thedarknet/darknet8-badge/Prototype1/hardware/docs/TJC-028-9341SPI裸屏规格书.pdf

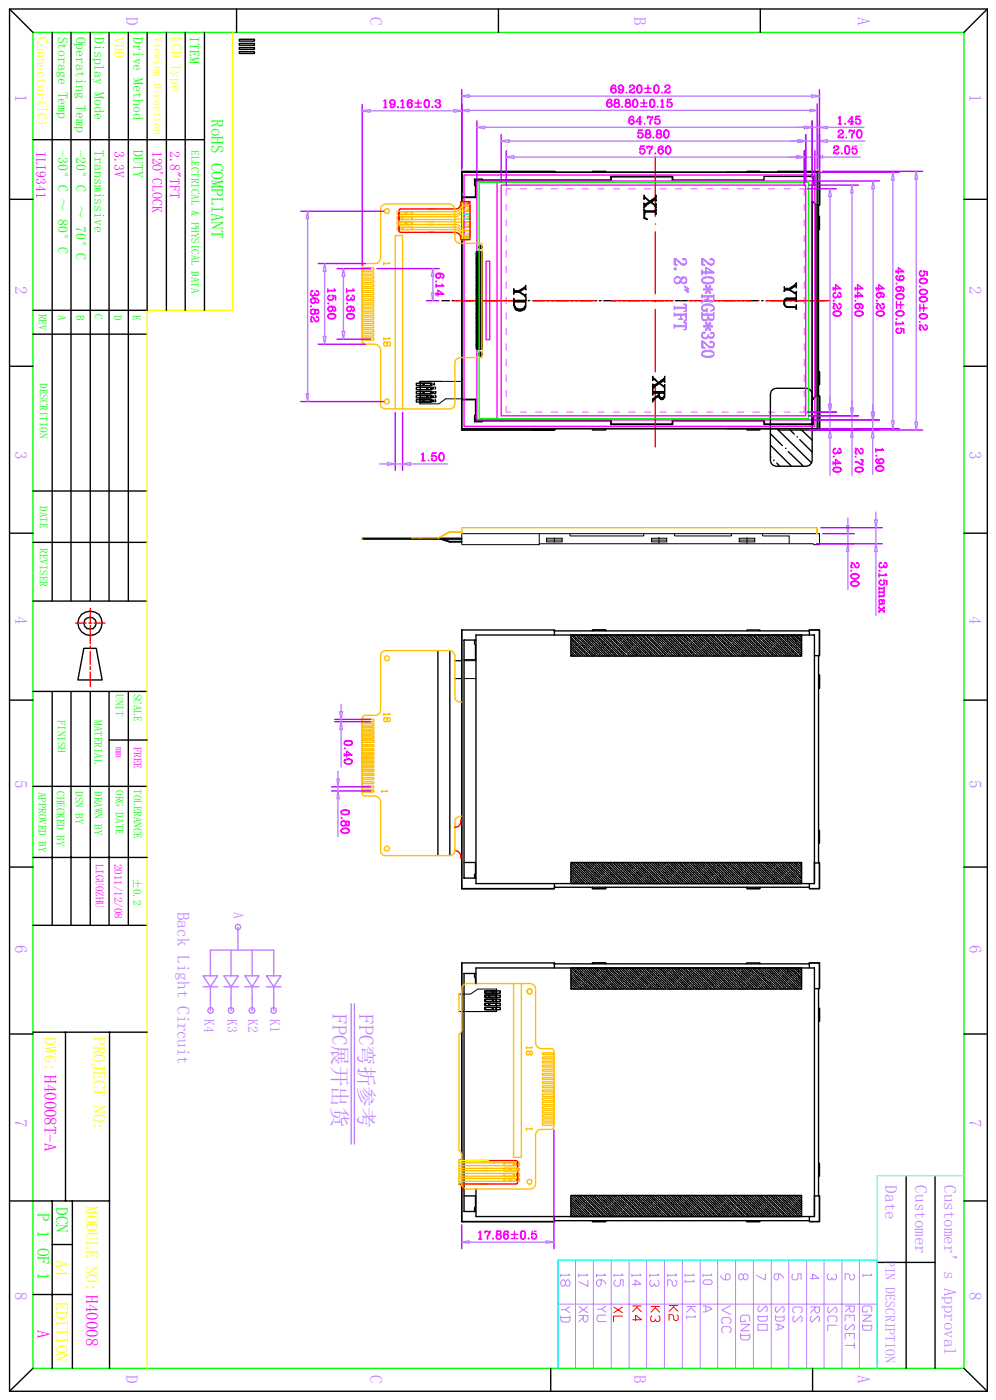
[picture p12: page 1]
Date; Customer; Customer’s Approval; RoHS COMPLIANT; Connector(IC); Storage Temp; Operating Temp; Display Mode; VDD; Drive Method; Viewing Direction; LCD Type; Transmissive; DUTY; UNIT; SCALE; FREE; FINISH; MATERIAL; CHECKED BY; DSN BY; DRAWN BY; ORG DATE; TOLERANCE; APPROVED BY; DWG:; EDITION; DCN A4; FPC弯折参考; FPC展开出货; PIN DESCRIPTION; LIGUOZHU; ILI9341; 12O'CLOCK; 2.8"TFT

ITEM ELECTRICAL & PHYSICAL DATA

REV DESCRITION DATE REVISER

Back Light Circuit

PROJECT NO: MODULE NO:
