thedarknet/darknet8-badge/Prototype1/hardware/docs/2.4-tft-touch-modules  dimension.pdf

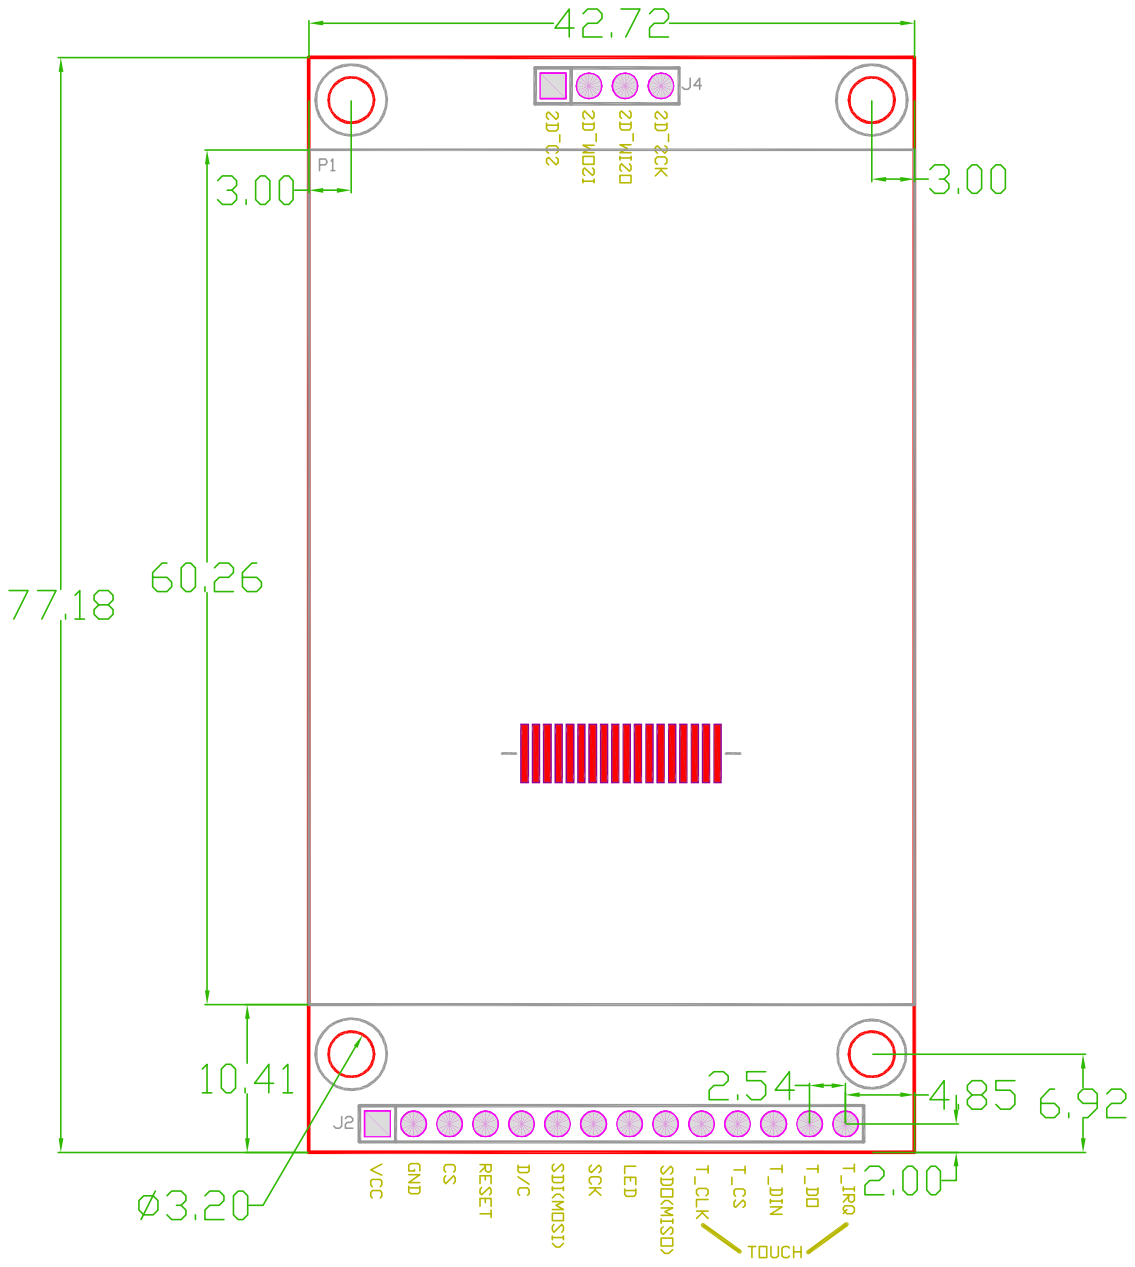
[picture p13: page 1]
