thedarknet/darknet8-badge/Prototype1/hardware/docs/2.4-tft-touch-modules schematic.pdf

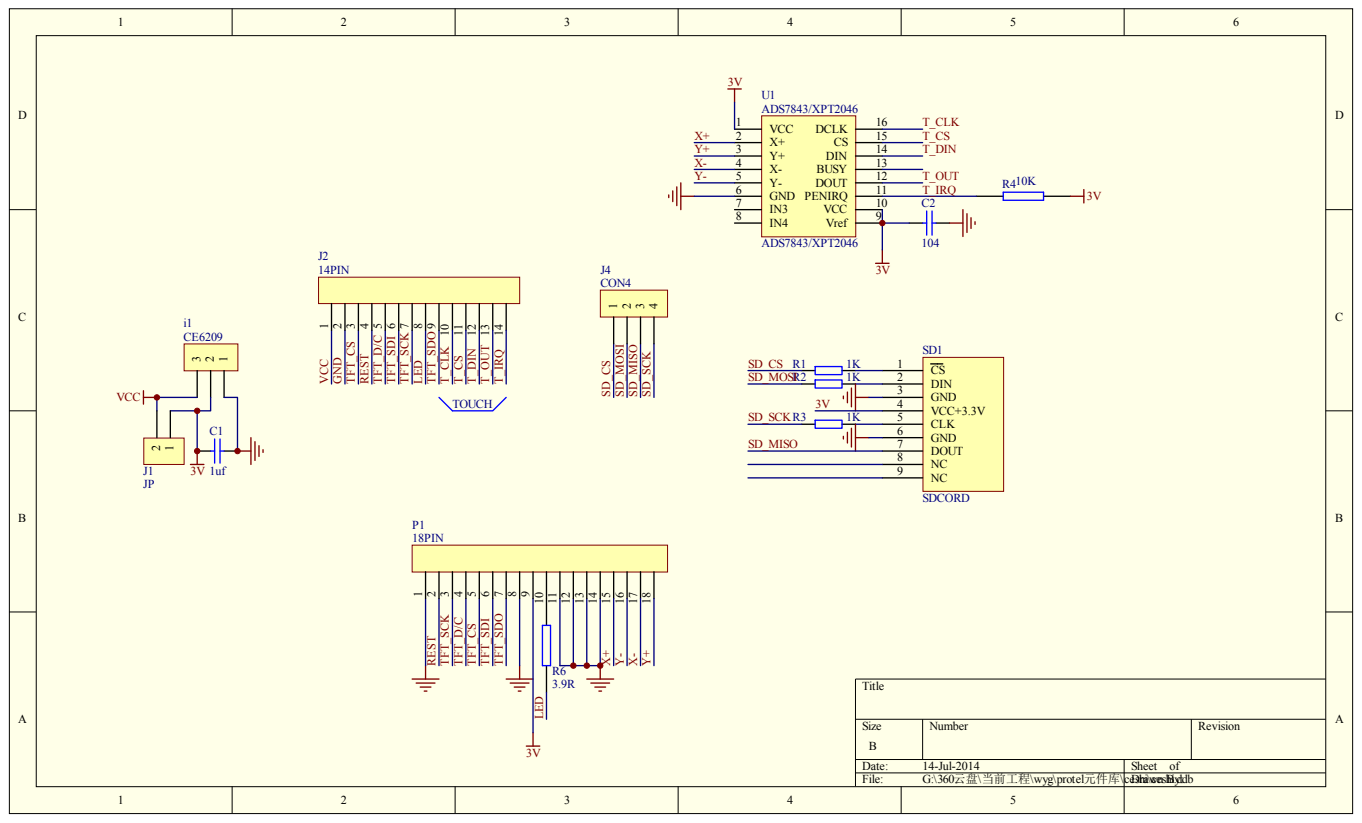
[picture p14: page 1]

\ceshi\ceshi.ddb Drawn By:
