thedarknet/darknet8-badge/DC27/hardware/DC27-bottom.brd

## EAGLE design DC27/hardware/DC27-bottom.brd (2019-06-22)

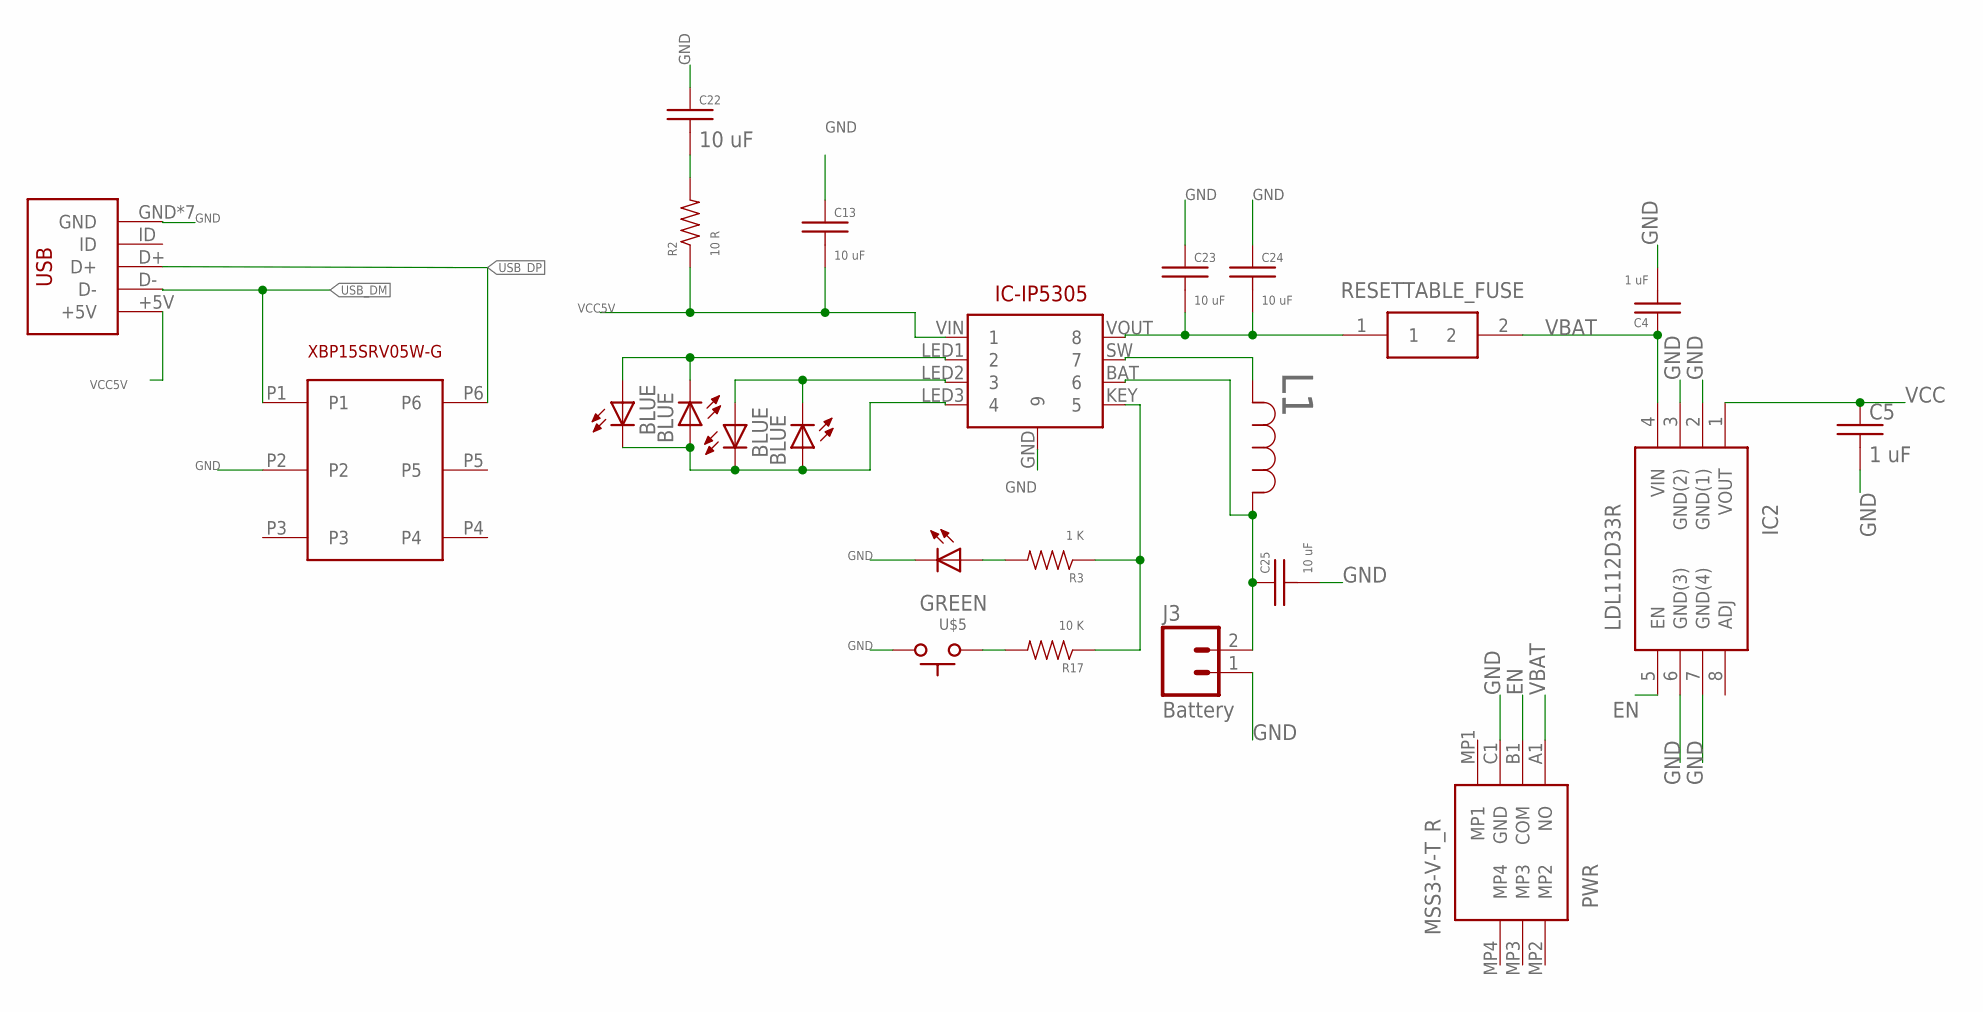
[picture p28: schematic DC27-bottom.sch, sheet 1]

Parts:
C4, C5: 1 uF; C0805
C13, C22, C23, C24, C25: 10 uF; C0805
CL1, CL2, CL3, CL4: BLUE; LED-1206
IC2: LDL112D33R; SOIC127P600X175-8N
IC-IP5305: IP5305ESOP8; SOIC127P600X165-8
J3: Battery; JST-2-PTH
KEYLED: GREEN; LED-1206
L1: 2.2uH; IND_TAIYO_NRS4018
PWR: MSS3-V-T_R; MSS3VTR
R2: 10 R; 0805
R3: 1 K; 0805
R17: 10 K; 0805
RESETTABLE_FUSE: 0ZCJ0050FF2G; FUSC3216X55N
U$2: XBP15SRV05W-G; SOT-26P-XBP15SRV05W-G
U$3: DX4R005JJ2DX4R005JJ2; DX4R005JJ2
U$5: SWITCH_TACTILETACTILE-2PIN-NARROW; TACTILE-2PIN-NARROW

Connections:
EN: IC2.5 (EN), PWR.B1 (COM); also elsewhere on the board
GND: C4.2, C5.2, C13.1, C22.1, C23.1, C24.1, C25.2, IC2.2 (GND(1)), IC2.3 (GND(2)), IC2.6 (GND(3)), IC2.7 (GND(4)), IC-IP5305.GND (9), J3.1, KEYLED.C, PWR.C1 (GND), U$2.P2, U$3.GND, U$3.P$6 (GND), U$3.P$7 (GND), U$3.P$8 (GND), U$3.P$9 (GND), U$3.P$10 (GND), U$3.P$11 (GND), U$5.P$1 (A); also elsewhere on the board
unnamed: CL1.A, CL2.C, IC-IP5305.LED1 (2)
unnamed: CL3.A, CL4.C, IC-IP5305.LED2 (3)
unnamed: CL1.C, CL2.A, CL3.C, CL4.A, IC-IP5305.LED3 (4)
unnamed: C22.2, R2.2
unnamed: IC-IP5305.SW (7), L1.2
unnamed: C25.1, IC-IP5305.BAT (6), J3.2, L1.1
unnamed: IC-IP5305.KEY (5), R3.1, R17.1
unnamed: KEYLED.A, R3.2
unnamed: R17.2, U$5.P$2 (C)
unnamed: C23.2, C24.2, IC-IP5305.VOUT (8), RESETTABLE_FUSE.1
USB_DM: U$2.P1, U$3.D-; also elsewhere on the board
USB_DP: U$2.P6, U$3.D+; also elsewhere on the board
VBAT: C4.1, IC2.4 (VIN), PWR.A1 (NO), RESETTABLE_FUSE.2
VCC: C5.1, IC2.1 (VOUT); also elsewhere on the board
VCC5V: C13.2, IC-IP5305.VIN (1), R2.1, U$3.+5V; also elsewhere on the board

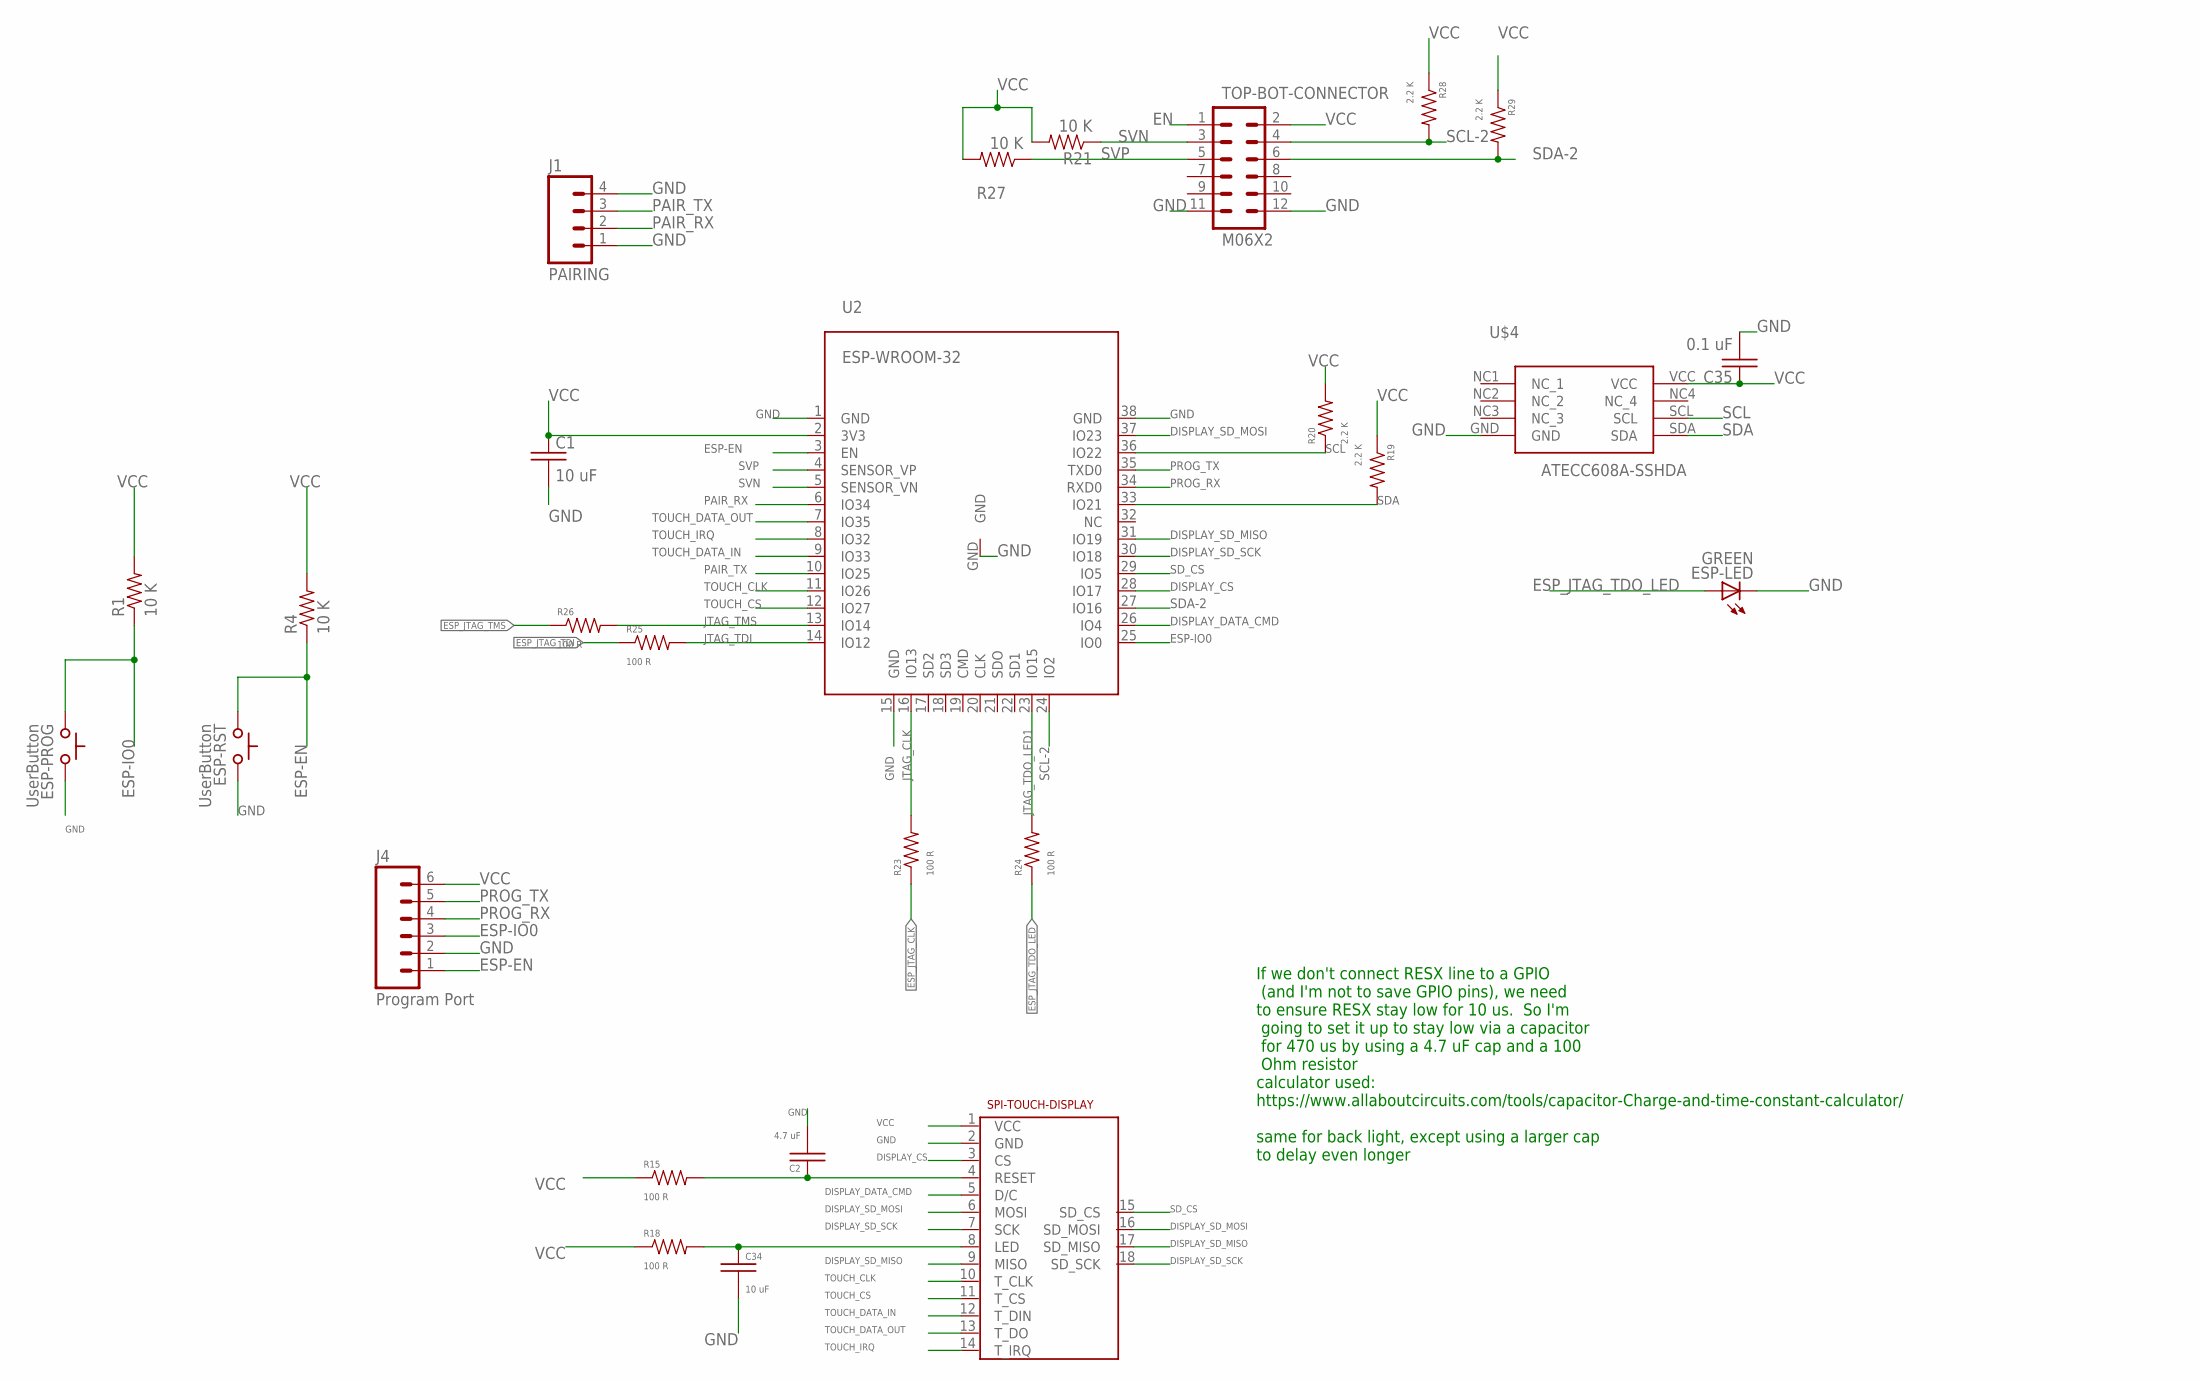
[picture p29: schematic DC27-bottom.sch, sheet 2]

Parts:
C1, C34: 10 uF; C0805
C2: 4.7 uF; C0805
C35: 0.1 uF; C0805
ESP-LED: GREEN; LED-1206
ESP-PROG: UserButton; TACTILE-2PIN-NARROW
ESP-RST: UserButton; TACTILE-2PIN-NARROW
J1: PAIRING; 1X04
J4: Program Port; 1X06-SMD-POGO
R1, R4, R21, R27: 10 K; 0805
R15, R18, R23, R24, R25, R26: 100 R; 0805
R19, R20, R28, R29: 2.2 K; 0805
TOP-BOT-CONNECTOR: M06X2; 2X6
U2: ESP-WROOM-32
U$4: ATECC608A-SSHDA; 8-SOIC
U$10: 2.4-SPI-TFT-TOUCH-SSD-MODULE

Connections:
DISPLAY_BACKLIT: C34.1, R18.2, U$10.8 (LED)
DISPLAY_CS: U2.28 (IO17), U$10.3 (CS)
DISPLAY_DATA_CMD: U2.26 (IO4), U$10.5 (D/C)
DISPLAY_RESET: C2.1, R15.2, U$10.4 (RESET)
DISPLAY_SD_MISO: U2.31 (IO19), U$10.9 (MISO), U$10.17 (SD_MISO)
DISPLAY_SD_MOSI: U2.37 (IO23), U$10.6 (MOSI), U$10.16 (SD_MOSI)
DISPLAY_SD_SCK: U2.30 (IO18), U$10.7 (SCK), U$10.18 (SD_SCK)
EN: TOP-BOT-CONNECTOR.1; also elsewhere on the board
ESP-EN: ESP-RST.P$2 (C), J4.1, R4.1, U2.3 (EN)
ESP-IO0: ESP-PROG.P$2 (C), J4.3, R1.1, U2.25 (IO0)
ESP_JTAG_CLK: R23.1; also elsewhere on the board
ESP_JTAG_TDI: R25.1; also elsewhere on the board
ESP_JTAG_TDO_LED: ESP-LED.A, R24.1; also elsewhere on the board
ESP_JTAG_TMS: R26.1; also elsewhere on the board
GND: C1.2, C2.2, C34.2, C35.2, ESP-LED.C, ESP-PROG.P$1 (A), ESP-RST.P$1 (A), J1.1, J1.4, J4.2, TOP-BOT-CONNECTOR.11, TOP-BOT-CONNECTOR.12, U2.1 (GND), U2.15 (GND), U2.38 (GND), U2.GND, U$4.GND, U$10.2 (GND); also elsewhere on the board
JTAG_CLK: R23.2, U2.16 (IO13)
JTAG_TDI: R25.2, U2.14 (IO12)
JTAG_TDO_LED1: R24.2, U2.23 (IO15)
JTAG_TMS: R26.2, U2.13 (IO14)
PAIR_RX: J1.2, U2.6 (IO34)
PAIR_TX: J1.3, U2.10 (IO25)
PROG_RX: J4.4, U2.34 (RXD0); also elsewhere on the board
PROG_TX: J4.5, U2.35 (TXD0); also elsewhere on the board
SCL: R20.1, U2.36 (IO22), U$4.SCL
SCL-2: R28.2, TOP-BOT-CONNECTOR.4, U2.24 (IO2)
SDA: R19.2, U2.33 (IO21), U$4.SDA
SDA-2: R29.2, TOP-BOT-CONNECTOR.6, U2.27 (IO16)
SD_CS: U2.29 (IO5), U$10.15 (SD_CS)
SVN: R21.1, TOP-BOT-CONNECTOR.3, U2.5 (SENSOR_VN)
SVP: R27.1, TOP-BOT-CONNECTOR.5, U2.4 (SENSOR_VP)
TOUCH_CLK: U2.11 (IO26), U$10.10 (T_CLK)
TOUCH_CS: U2.12 (IO27), U$10.11 (T_CS)
TOUCH_DATA_IN: U2.9 (IO33), U$10.12 (T_DIN)
TOUCH_DATA_OUT: U2.7 (IO35), U$10.13 (T_DO)
TOUCH_IRQ: U2.8 (IO32), U$10.14 (T_IRQ)
VCC: C1.1, C35.1, J4.6, R1.2, R4.2, R15.1, R18.1, R19.1, R20.2, R21.2, R27.2, R28.1, R29.1, TOP-BOT-CONNECTOR.2, U2.2 (3V3), U$4.VCC, U$10.1 (VCC); also elsewhere on the board

Notes on the sheet:
If we don't connect RESX line to a GPIO (and I'm not to save GPIO pins), we need to ensure RESX stay low for 10 us. So I'm going to set it up to stay low via a capacitor for 470 us by using a 4.7 uF cap and a 100 Ohm resistor calculator used: https://www.allaboutcircuits.com/tools/capacitor-Charge-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

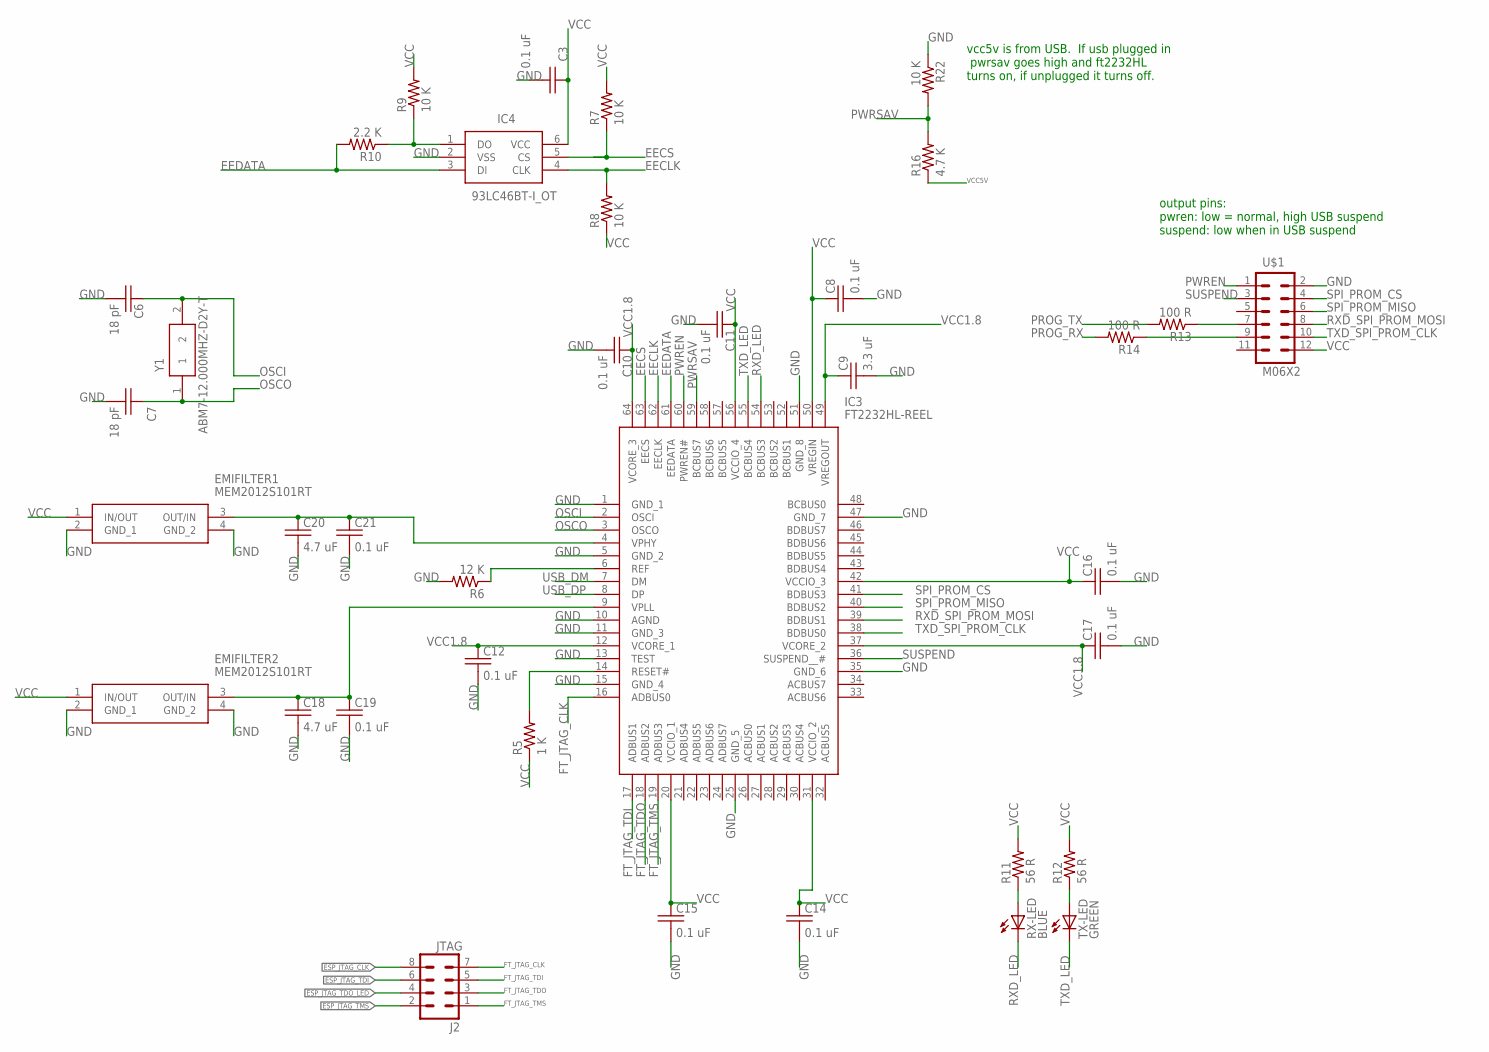
[picture p30: schematic DC27-bottom.sch, sheet 3]

Parts:
C3, C8, C10, C11, C12, C14, C15, C16, C17, C19, C21: 0.1 uF; C0805
C6, C7: 18 pF; C0805
C9: 3.3 uF; C0805
C18, C20: 4.7 uF; C0805
EMIFILTER1, EMIFILTER2: MEM2012S101RT
IC3: FT2232HL-REEL; QFP50P1200X1200X160-64N
IC4: 93LC46BT-I_OT; SOT95P270X145-6N
J2: JTAG; 2X4
R5: 1 K; 0805
R6: 12 K; 0805
R7, R8, R9, R22: 10 K; 0805
R10: 2.2 K; 0805
R11, R12: 56 R; 0805
R13, R14: 100 R; 0805
R16: 4.7 K; 0805
RX-LED: BLUE; LED-1206
TX-LED: GREEN; LED-1206
U$1: M06X2; 2X6
Y1: ABM7-12.000MHZ-D2Y-T; ABM7

Connections:
EECLK: IC3.62 (EECLK), IC4.4 (CLK), R8.2
EECS: IC3.63 (EECS), IC4.5 (CS), R7.1
EEDATA: IC3.61 (EEDATA), IC4.3 (DI), R10.2
ESP_JTAG_CLK: J2.8; also elsewhere on the board
ESP_JTAG_TDI: J2.6; also elsewhere on the board
ESP_JTAG_TDO_LED: J2.4; also elsewhere on the board
ESP_JTAG_TMS: J2.2; also elsewhere on the board
FT_JTAG_CLK: IC3.16 (ADBUS0), J2.7
FT_JTAG_TDI: IC3.17 (ADBUS1), J2.5
FT_JTAG_TDO: IC3.18 (ADBUS2), J2.3
FT_JTAG_TMS: IC3.19 (ADBUS3), J2.1
GND: C3.2, C6.2, C7.2, C8.2, C9.2, C10.2, C11.2, C12.2, C14.2, C15.2, C16.2, C17.2, C18.2, C19.2, C20.2, C21.2, EMIFILTER1.2 (GND_1), EMIFILTER1.4 (GND_2), EMIFILTER2.2 (GND_1), EMIFILTER2.4 (GND_2), IC3.1 (GND_1), IC3.5 (GND_2), IC3.10 (AGND), IC3.11 (GND_3), IC3.13 (TEST), IC3.15 (GND_4), IC3.25 (GND_5), IC3.35 (GND_6), IC3.47 (GND_7), IC3.51 (GND_8), IC4.2 (VSS), R6.2, R22.1, U$1.2; also elsewhere on the board
unnamed: IC3.14 (RESET#), R5.2
unnamed: IC3.6 (REF), R6.1
unnamed: IC4.1 (DO), R9.1, R10.1
unnamed: R11.1, RX-LED.A
unnamed: R12.1, TX-LED.A
unnamed: C18.1, C19.1, EMIFILTER2.3 (OUT/IN), IC3.9 (VPLL)
unnamed: C20.1, C21.1, EMIFILTER1.3 (OUT/IN), IC3.4 (VPHY)
unnamed: R14.1, U$1.9
unnamed: R13.1, U$1.7
OSCI: C6.1, IC3.2 (OSCI), Y1.2
OSCO: C7.1, IC3.3 (OSCO), Y1.1
PROG_RX: R14.2; also elsewhere on the board
PROG_TX: R13.2; also elsewhere on the board
PWREN: IC3.60 (PWREN#), U$1.1
PWRSAV: IC3.59 (BCBUS7), R16.2, R22.2
RXD_LED: IC3.54 (BCBUS3), RX-LED.C
RXD_SPI_PROM_MOSI: IC3.39 (BDBUS1), U$1.8
SPI_PROM_CS: IC3.41 (BDBUS3), U$1.4
SPI_PROM_MISO: IC3.40 (BDBUS2), U$1.6
SUSPEND: IC3.36 (SUSPEND__#), U$1.3
TXD_LED: IC3.55 (BCBUS4), TX-LED.C
TXD_SPI_PROM_CLK: IC3.38 (BDBUS0), U$1.10
USB_DM: IC3.7 (DM); also elsewhere on the board
USB_DP: IC3.8 (DP); also elsewhere on the board
VCC: C3.1, C8.1, C11.1, C14.1, C15.1, C16.1, EMIFILTER1.1 (IN/OUT), EMIFILTER2.1 (IN/OUT), IC3.20 (VCCIO_1), IC3.31 (VCCIO_2), IC3.42 (VCCIO_3), IC3.50 (VREGIN), IC3.56 (VCCIO_4), IC4.6 (VCC), R5.1, R7.2, R8.1, R9.2, R11.2, R12.2, U$1.12; also elsewhere on the board
VCC1.8: C9.1, C10.1, C12.1, C17.1, IC3.12 (VCORE_1), IC3.37 (VCORE_2), IC3.49 (VREGOUT), IC3.64 (VCORE_3)
VCC5V: R16.1; also elsewhere on the board

Notes on the sheet:
output pins: pwren: low = normal, high USB suspend suspend: low when in USB suspend
vcc5v is from USB. If usb plugged in pwrsav goes high and ft2232HL turns on, if unplugged it turns off.

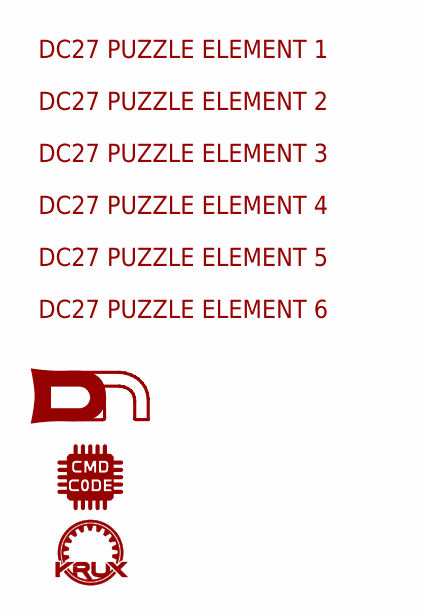
[picture p31: schematic DC27-bottom.sch, sheet 4]

Parts:
U$6: DC27_PUZZLE_ELEMENT_1
U$7: KRUX_LOGO
U$8: CMD_C0DE_LOGO
U$9: DN_LOGODC26; DN_LOGO_DC26
U$11: DC27_PUZZLE_ELEMENT_2
U$12: DC27_PUZZLE_ELEMENT_3
U$13: DC27_PUZZLE_ELEMENT_4
U$14: DC27_PUZZLE_ELEMENT_5
U$15: DC27_PUZZLE_ELEMENT_6

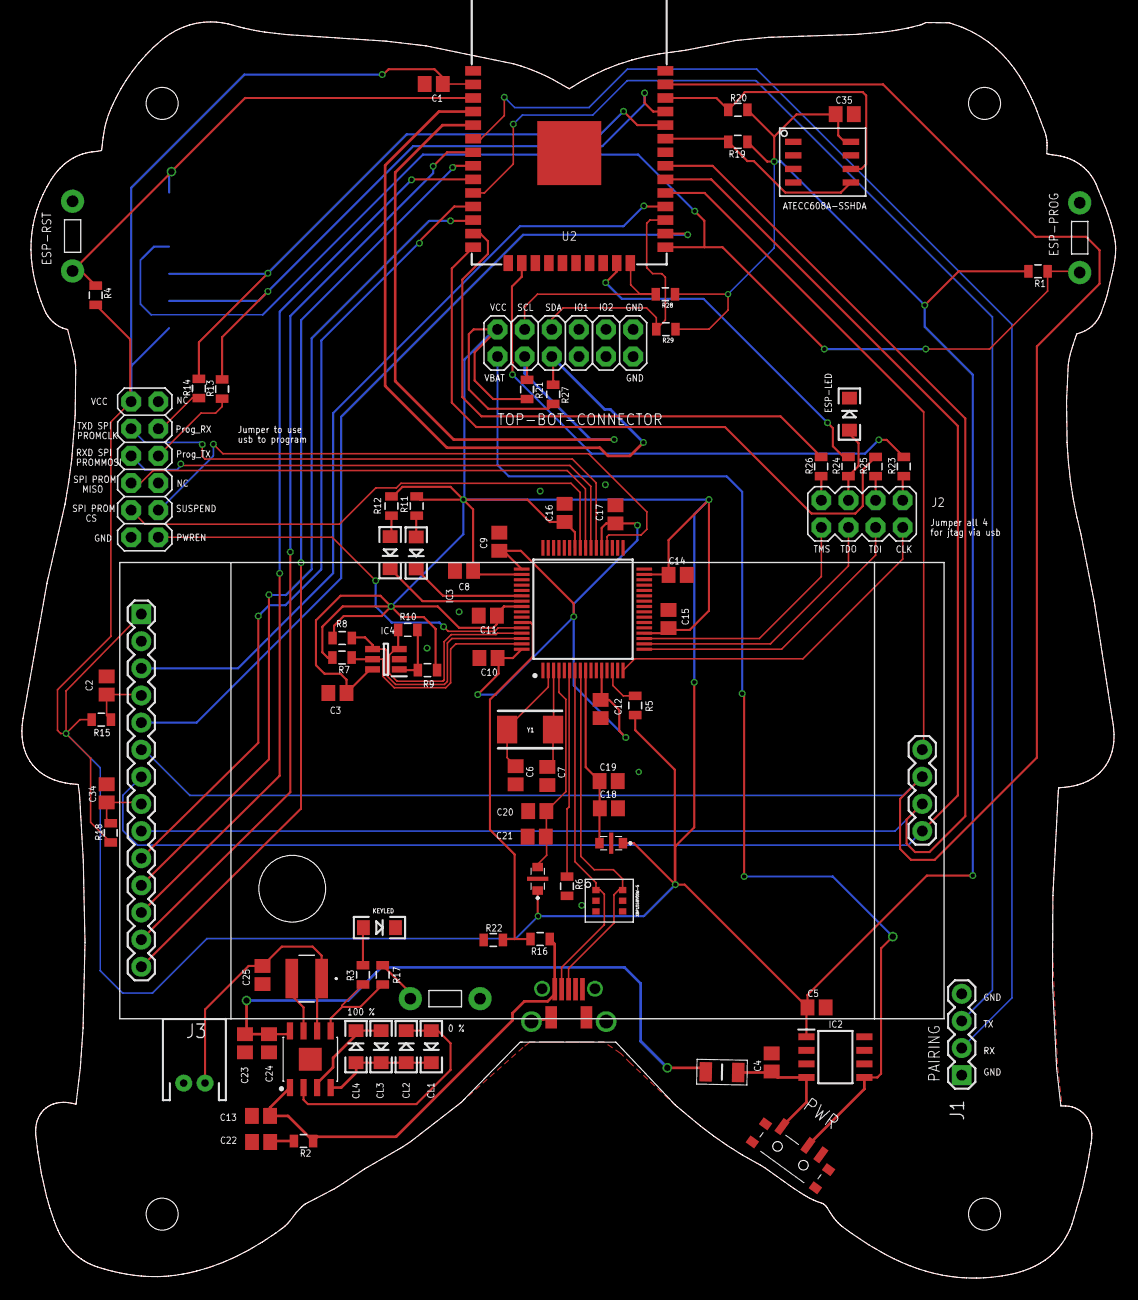
[picture p32: board DC27-bottom.brd from above]

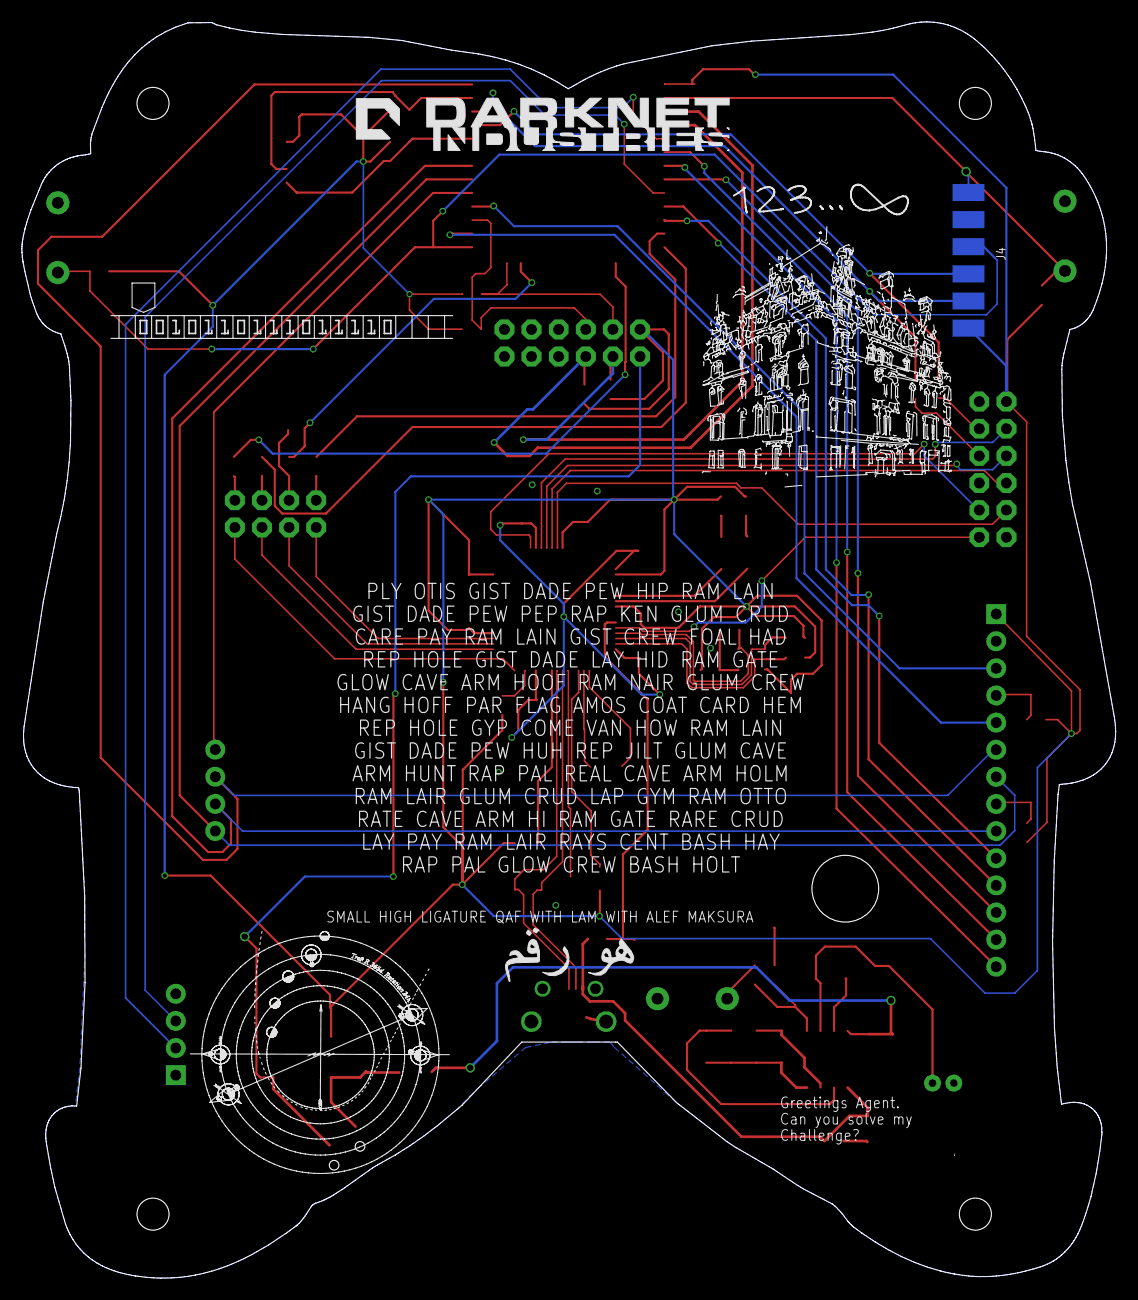
[picture p33: board DC27-bottom.brd from below]

Board: 2 copper layers, 102.4 x 117.6 mm, 97 parts (10 on the bottom side), 78 nets.
