thedarknet/darknet8-badge/DC27/hardware/DC27-top.brd

## EAGLE design DC27/hardware/DC27-top.brd (2019-06-17)

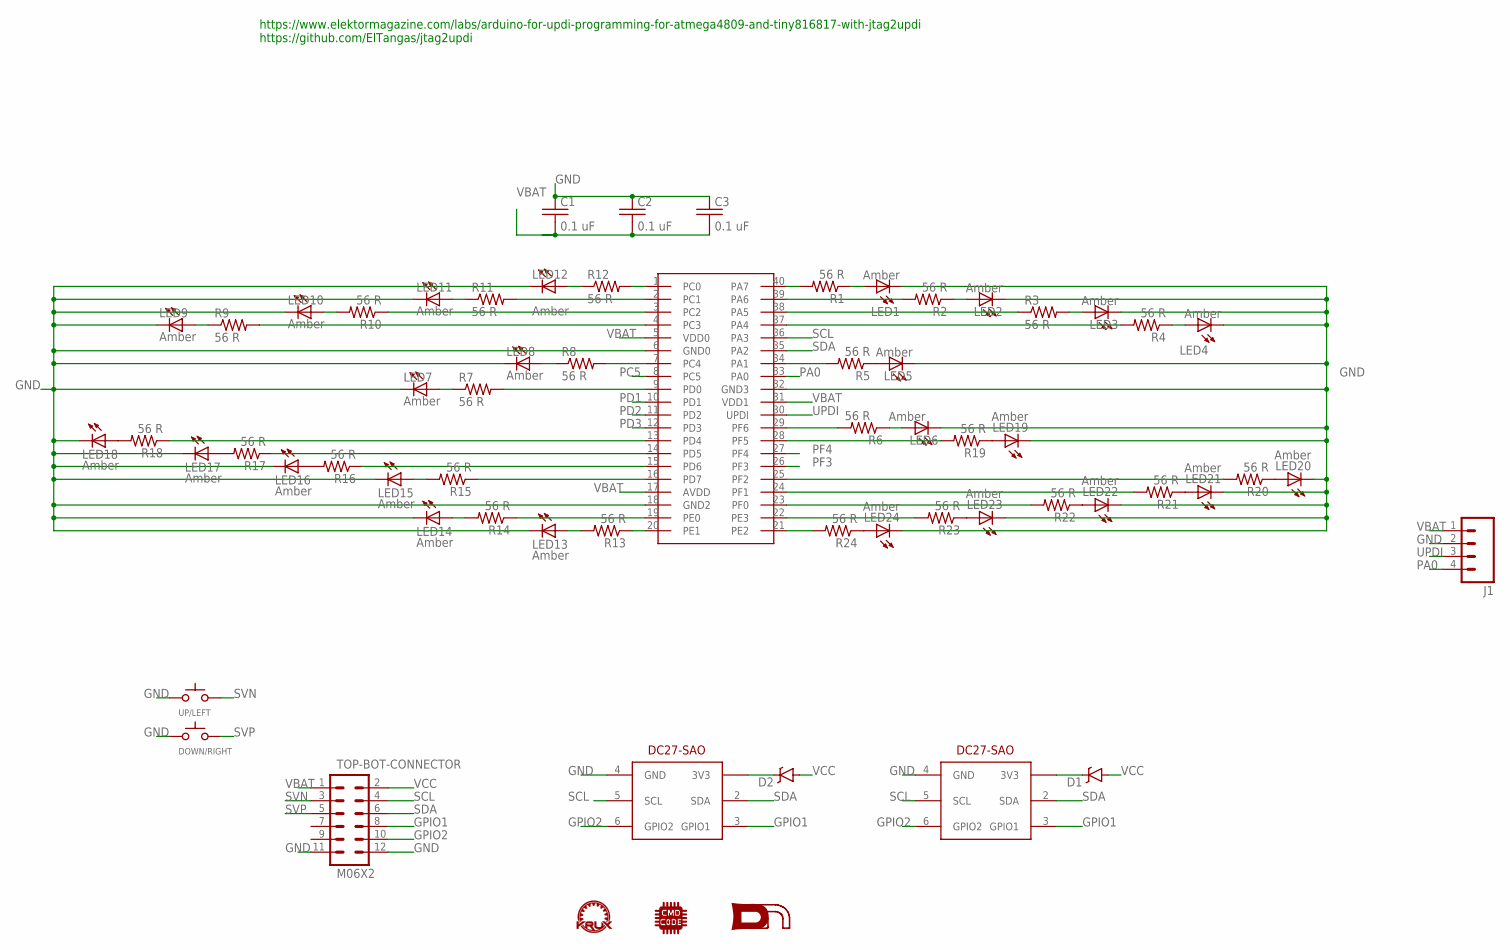
[picture p34: schematic DC27-top.sch]

Parts:
C1, C2, C3: 0.1 uF; C1206
D1, D2: DIODE-SCHOTTKYDIOAD-TH; DIOAD1060W80L520D270
DOWN/RIGHT: SWITCH_TACTILETACTILE-2PIN-NARROW; TACTILE-2PIN-NARROW
J1: M04PTH; 1X04
LED1, LED2, LED3, LED4, LED5, LED6, LED7, LED8, LED9, LED10, LED11, LED12, LED13, LED14, LED15, LED16, LED17, LED18, LED19, LED20, LED21, LED22, LED23, LED24: Amber; GULLWING_LED
R1, R2, R3, R4, R5, R6, R7, R8, R9, R10, R11, R12, R13, R14, R15, R16, R17, R18, R19, R20, R21, R22, R23, R24: 56 R; 1206
TOP-BOT-CONNECTOR: M06X2; 2X6
U$1: KRUX_LOGO
U$2: CMD_C0DE_LOGO
U$3, U$4: DC-27-SAO; 3X2
U$5: DN_LOGODC26; DN_LOGO_DC26
U$6: ATMEGA4809-PFATMEL4809-PF; DIP1587W58P254L5175H635Q40B
UP/LEFT: SWITCH_TACTILETACTILE-2PIN-NARROW; TACTILE-2PIN-NARROW

Connections:
GND: C1.1, C2.1, C3.1, DOWN/RIGHT.P$2 (C), J1.2, LED1.C, LED2.C, LED3.C, LED4.C, LED5.C, LED6.C, LED7.C, LED8.C, LED9.C, LED10.C, LED11.C, LED12.C, LED13.C, LED14.C, LED15.C, LED16.C, LED17.C, LED18.C, LED19.C, LED20.C, LED21.C, LED22.C, LED23.C, LED24.C, TOP-BOT-CONNECTOR.11, TOP-BOT-CONNECTOR.12, U$3.4 (GND), U$4.4 (GND), U$6.6 (GND0), U$6.18 (GND2), U$6.32 (GND3), UP/LEFT.P$2 (C)
GPIO1: TOP-BOT-CONNECTOR.8, U$3.3 (GPIO1), U$4.3 (GPIO1)
GPIO2: TOP-BOT-CONNECTOR.10, U$3.6 (GPIO2), U$4.6 (GPIO2)
unnamed: R9.2, U$6.4 (PC3)
unnamed: LED9.A, R9.1
unnamed: R8.2, U$6.7 (PC4)
unnamed: R7.2, U$6.9 (PD0)
unnamed: R1.2, U$6.40 (PA7)
unnamed: R2.2, U$6.39 (PA6)
unnamed: R3.1, U$6.38 (PA5)
unnamed: LED8.A, R8.1
unnamed: LED7.A, R7.1
unnamed: R10.1, U$6.3 (PC2)
unnamed: R11.2, U$6.2 (PC1)
unnamed: R12.2, U$6.1 (PC0)
unnamed: R4.2, U$6.37 (PA4)
unnamed: LED5.A, R5.1
unnamed: R5.2, U$6.34 (PA1)
unnamed: R13.1, U$6.20 (PE1)
unnamed: LED13.A, R13.2
unnamed: R14.1, U$6.19 (PE0)
unnamed: LED14.A, R14.2
unnamed: R15.1, U$6.16 (PD7)
unnamed: LED15.A, R15.2
unnamed: LED17.A, R17.2
unnamed: LED16.A, R16.2
unnamed: R18.1, U$6.13 (PD4)
unnamed: D2.C, U$3.1 (3V3)
unnamed: D1.C, U$4.1 (3V3)
unnamed: R6.2, U$6.29 (PF6)
unnamed: LED6.A, R6.1
unnamed: LED4.A, R4.1
unnamed: LED18.A, R18.2
unnamed: LED1.A, R1.1
unnamed: LED2.A, R2.1
unnamed: R17.1, U$6.14 (PD5)
unnamed: R16.1, U$6.15 (PD6)
unnamed: LED24.A, R24.1
unnamed: LED10.A, R10.2
unnamed: LED11.A, R11.1
unnamed: LED12.A, R12.1
unnamed: LED23.A, R23.1
unnamed: LED22.A, R22.1
unnamed: LED19.A, R19.1
unnamed: LED21.A, R21.1
unnamed: LED20.A, R20.1
unnamed: R19.2, U$6.28 (PF5)
unnamed: R20.2, U$6.25 (PF2)
unnamed: R21.2, U$6.24 (PF1)
unnamed: R22.2, U$6.23 (PF0)
unnamed: R23.2, U$6.22 (PE3)
unnamed: R24.2, U$6.21 (PE2)
unnamed: LED3.A, R3.2
PA0: J1.4, U$6.33 (PA0)
PC5: U$6.8 (PC5)
PD1: U$6.10 (PD1)
PD2: U$6.11 (PD2)
PD3: U$6.12 (PD3)
PF3: U$6.26 (PF3)
PF4: U$6.27 (PF4)
SCL: TOP-BOT-CONNECTOR.4, U$3.5 (SCL), U$4.5 (SCL), U$6.36 (PA3)
SDA: TOP-BOT-CONNECTOR.6, U$3.2 (SDA), U$4.2 (SDA), U$6.35 (PA2)
SVN: TOP-BOT-CONNECTOR.3, UP/LEFT.P$1 (A)
SVP: DOWN/RIGHT.P$1 (A), TOP-BOT-CONNECTOR.5
UPDI: J1.3, U$6.30 (UPDI)
VBAT: C1.2, C2.2, C3.2, J1.1, TOP-BOT-CONNECTOR.1, U$6.5 (VDD0), U$6.17 (AVDD), U$6.31 (VDD1)
VCC: D1.A, D2.A, TOP-BOT-CONNECTOR.2

Notes on the sheet:
https://www.elektormagazine.com/labs/arduino-for-updi-programming-for-atmega4809-and-tiny816817-with-jtag2updi https://github.com/ElTangas/jtag2updi

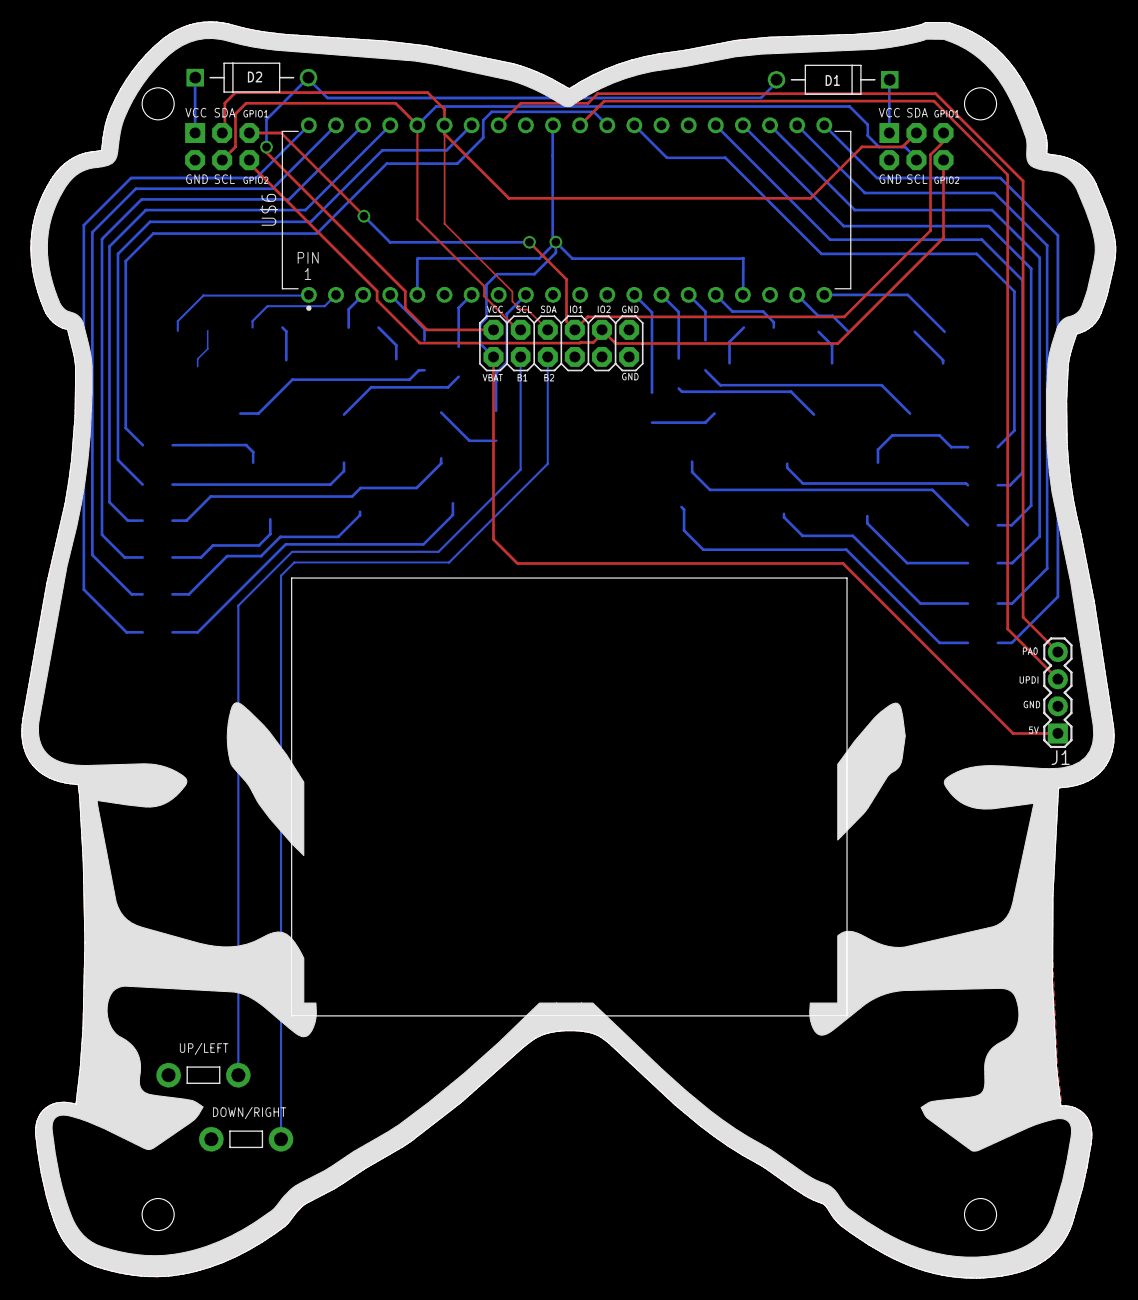
[picture p35: board DC27-top.brd from above]

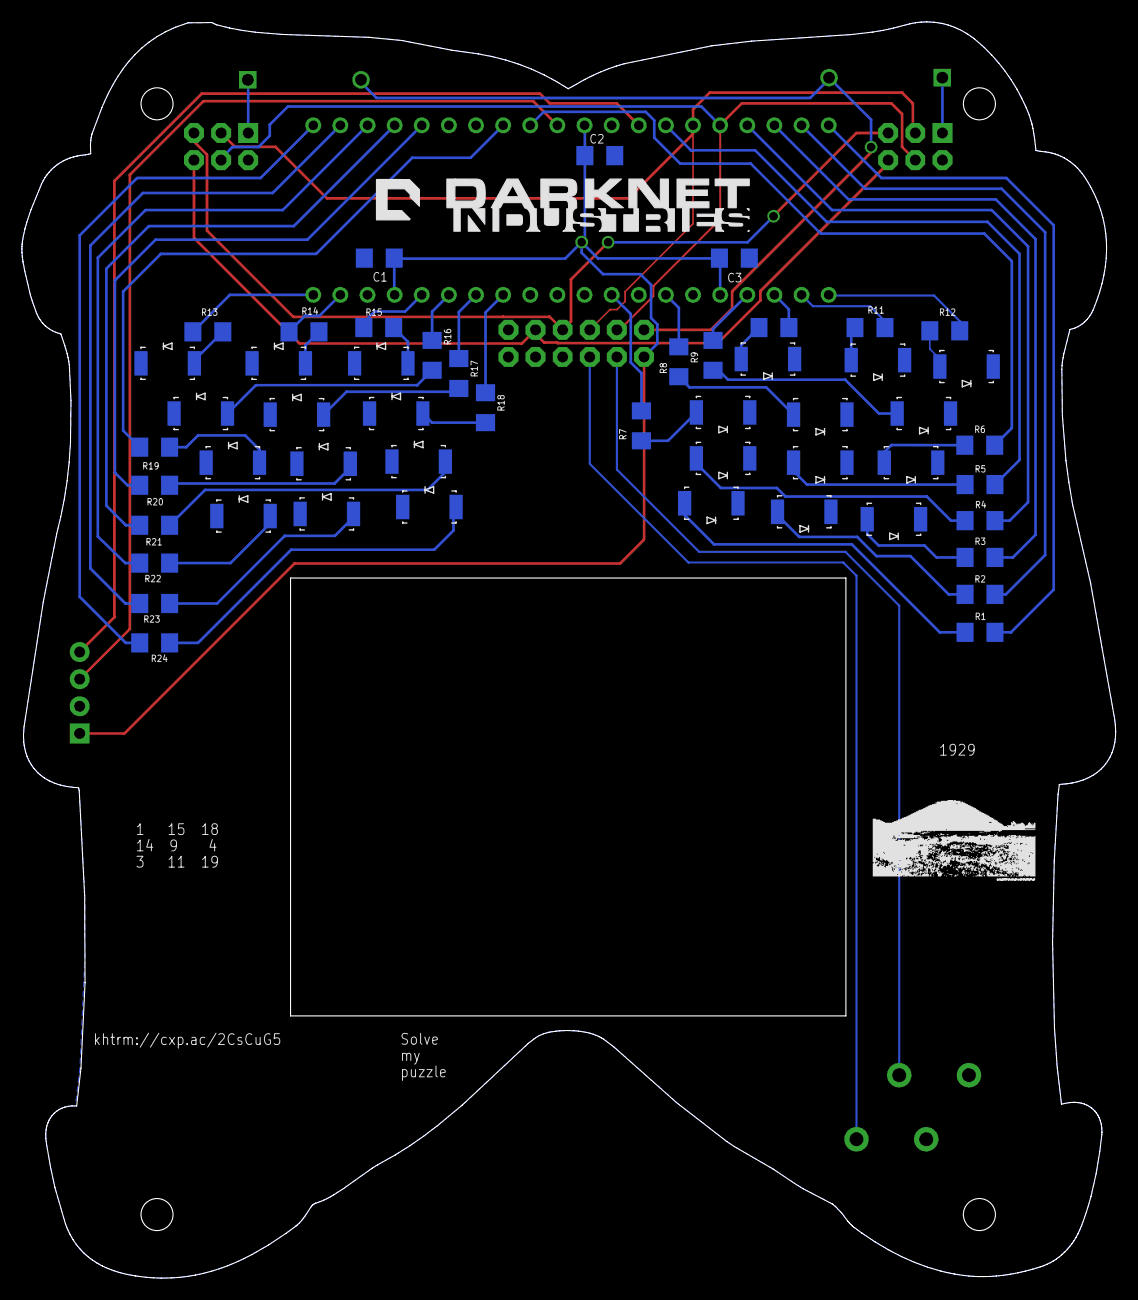
[picture p36: board DC27-top.brd from below]

Board: 2 copper layers, 102.4 x 117.6 mm, 63 parts (54 on the bottom side), 61 nets.
