thedarknet/darknet8-badge/DC27/hardware/sao/fpa-sao.brd

## EAGLE design DC27/hardware/sao/fpa-sao.brd (2019-06-17)

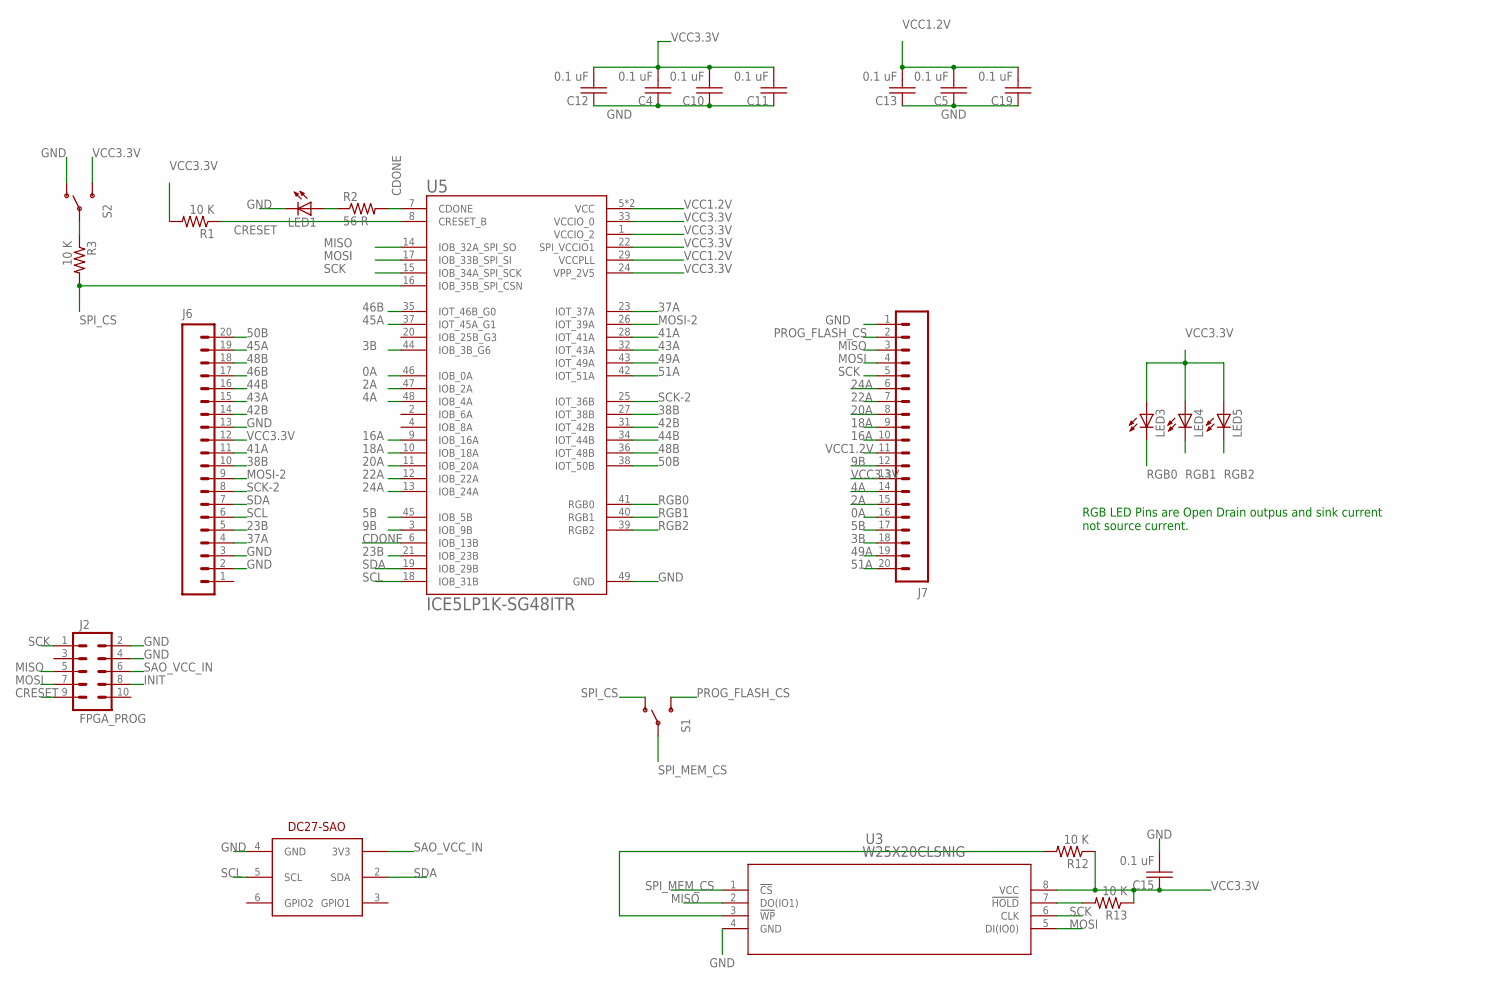
[picture p37: schematic fpa-sao.sch, sheet 1]

Parts:
C4, C5, C10, C11, C12, C13, C15, C19: 0.1 uF; C0603
J2: FPGA_PROG; 2X5_NOSILK
J6, J7: M20NO_SILK_KIT; 1X20_NO_SILK_KIT
LED1: LED1206; LED-1206
LED3, LED4, LED5: LED3MM
R1, R3, R12, R13: 10 K; 0805
R2: 56 R; 1206
S1, S2: SWITCH-SPSTKIT; SWITCH-SPDT_KIT
U3: W25X20CLSNIG; WIN_SN-8
U5: ICE5LP1K-SG48ITR; QFN50P700X700X100-49N
U$1: DC-27-SAO; 3X2

Connections:
0A: J7.16, U5.46 (IOB_0A)
2A: J7.15, U5.47 (IOB_2A)
3B: J7.18, U5.44 (IOB_3B_G6)
4A: J7.14, U5.48 (IOB_4A)
5B: J7.17, U5.45 (IOB_5B)
9B: J7.12, U5.3 (IOB_9B)
16A: J7.10, U5.9 (IOB_16A)
18A: J7.9, U5.10 (IOB_18A)
20A: J7.8, U5.11 (IOB_20A)
22A: J7.7, U5.12 (IOB_22A)
23B: J6.5, U5.21 (IOB_23B)
24A: J7.6, U5.13 (IOB_24A)
37A: J6.4, U5.23 (IOT_37A)
38B: J6.10, U5.27 (IOT_38B)
41A: J6.11, U5.28 (IOT_41A)
42B: J6.14, U5.31 (IOT_42B)
43A: J6.15, U5.32 (IOT_43A)
44B: J6.16, U5.34 (IOT_44B)
45A: J6.19, U5.37 (IOT_45A_G1)
46B: J6.17, U5.35 (IOT_46B_G0)
48B: J6.18, U5.36 (IOT_48B)
49A: J7.19, U5.43 (IOT_49A)
50B: J6.20, U5.38 (IOT_50B)
51A: J7.20, U5.42 (IOT_51A)
CDONE: R2.2, U5.6 (IOB_13B), U5.7 (CDONE)
CRESET: J2.9, R1.1, U5.8 (CRESET_B)
GND: C4.1, C5.1, C10.1, C11.1, C12.1, C13.1, C15.2, C19.1, J2.2, J2.4, J6.2, J6.3, J6.13, J7.1, LED1.C, S2.1 (O), U3.4 (GND), U5.49 (GND), U$1.4 (GND); also elsewhere on the board
INIT: J2.8
MISO: J2.5, J7.3, U3.2 (DO(IO1)), U5.14 (IOB_32A_SPI_SO)
MOSI: J2.7, J7.4, U3.5 (DI(IO0)), U5.17 (IOB_33B_SPI_SI); also elsewhere on the board
MOSI-2: J6.9, U5.26 (IOT_39A); also elsewhere on the board
unnamed: LED1.A, R2.1
unnamed: R3.1, S2.2
unnamed: R12.2, U3.3 (!WP)
unnamed: R13.2, U3.7 (!HOLD)
PROG_FLASH_CS: J7.2, S1.3 (S)
RGB0: LED3.K (C), U5.41 (RGB0)
RGB1: LED4.K (C), U5.40 (RGB1)
RGB2: LED5.K (C), U5.39 (RGB2)
SAO_VCC_IN: J2.6, U$1.1 (3V3); also elsewhere on the board
SCK: J2.1, J7.5, U3.6 (CLK), U5.15 (IOB_34A_SPI_SCK); also elsewhere on the board
SCK-2: J6.8, U5.25 (IOT_36B); also elsewhere on the board
SCL: J6.6, U5.18 (IOB_31B), U$1.5 (SCL)
SDA: J6.7, U5.19 (IOB_29B), U$1.2 (SDA)
SPI_CS: R3.2, S1.1 (O), U5.16 (IOB_35B_SPI_CSN)
SPI_MEM_CS: S1.2, U3.1 (!CS)
VCC1.2V: C5.2, C13.2, C19.2, J7.11, U5.5 (VCC), U5.29 (VCCPLL), U5.30 (VCC); also elsewhere on the board
VCC3.3V: C4.2, C10.2, C11.2, C12.2, C15.1, J6.12, J7.13, LED3.A, LED4.A, LED5.A, R1.2, R12.1, R13.1, S2.3 (S), U3.8 (VCC), U5.1 (VCCIO_2), U5.22 (SPI_VCCIO1), U5.24 (VPP_2V5), U5.33 (VCCIO_0); also elsewhere on the board

Notes on the sheet:
RGB LED Pins are Open Drain outpus and sink current not source current.

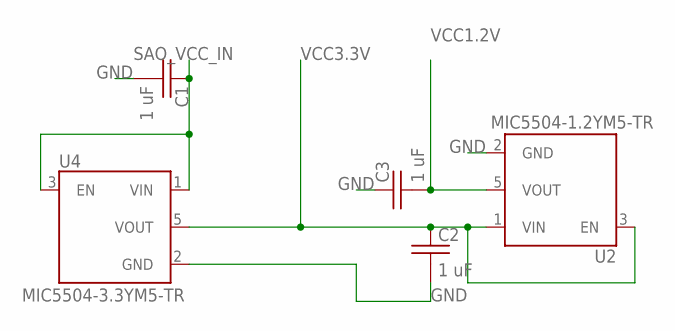
[picture p38: schematic fpa-sao.sch, sheet 2]

Parts:
C1, C2, C3: 1 uF; C0603
U2: MIC5504-1.2YM5-TR; SOT23-5P95_280X145XL45X37N
U4: MIC5504-3.3YM5-TR; SOT23-5P95_280X145XL45X37N

Connections:
GND: C1.2, C2.2, C3.1, U2.2 (GND), U4.2 (GND); also elsewhere on the board
SAO_VCC_IN: C1.1, U4.1 (VIN), U4.3 (EN); also elsewhere on the board
VCC1.2V: C3.2, U2.5 (VOUT); also elsewhere on the board
VCC3.3V: C2.1, U2.1 (VIN), U2.3 (EN), U4.5 (VOUT); also elsewhere on the board

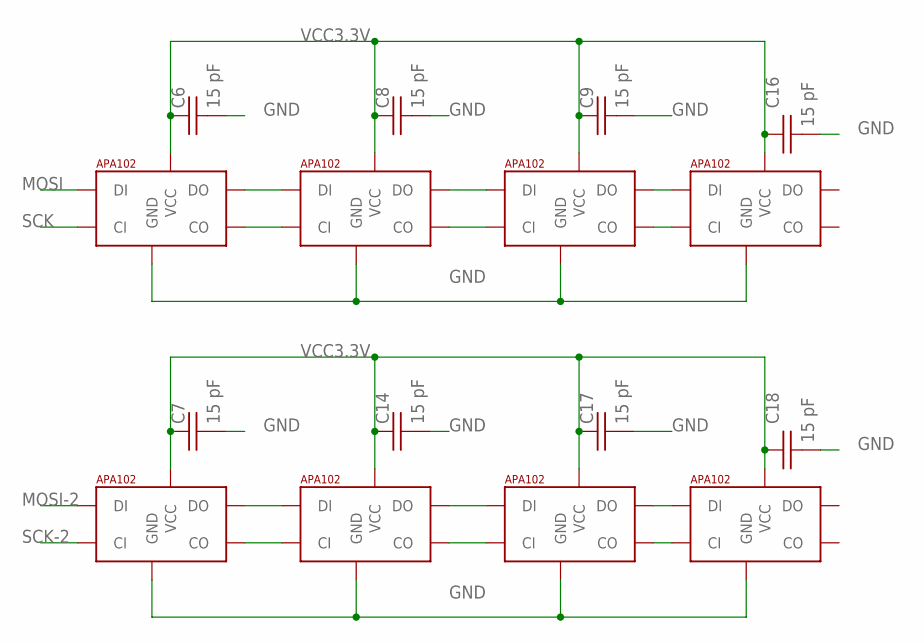
[picture p39: schematic fpa-sao.sch, sheet 3]

Parts:
C6, C7, C8, C9, C14, C16, C17, C18: 15 pF; C1206
U$2, U$3, U$4, U$5, U$6, U$7, U$8, U$10: APA1025050; APA102_5050

Connections:
GND: C6.2, C7.2, C8.2, C9.2, C14.2, C16.2, C17.2, C18.2, U$2.6 (GND), U$3.6 (GND), U$4.6 (GND), U$5.6 (GND), U$6.6 (GND), U$7.6 (GND), U$8.6 (GND), U$10.6 (GND); also elsewhere on the board
MOSI: U$6.4 (DI); also elsewhere on the board
MOSI-2: U$2.4 (DI); also elsewhere on the board
unnamed: U$6.2 (CO), U$7.5 (CI)
unnamed: U$6.3 (DO), U$7.4 (DI)
unnamed: U$7.3 (DO), U$8.4 (DI)
unnamed: U$7.2 (CO), U$8.5 (CI)
unnamed: U$2.2 (CO), U$3.5 (CI)
unnamed: U$8.3 (DO), U$10.4 (DI)
unnamed: U$8.2 (CO), U$10.5 (CI)
unnamed: U$2.3 (DO), U$3.4 (DI)
unnamed: U$3.3 (DO), U$4.4 (DI)
unnamed: U$3.2 (CO), U$4.5 (CI)
unnamed: U$4.3 (DO), U$5.4 (DI)
unnamed: U$4.2 (CO), U$5.5 (CI)
SCK: U$6.5 (CI); also elsewhere on the board
SCK-2: U$2.5 (CI); also elsewhere on the board
VCC3.3V: C6.1, C7.1, C8.1, C9.1, C14.1, C16.1, C17.1, C18.1, U$2.1 (VCC), U$3.1 (VCC), U$4.1 (VCC), U$5.1 (VCC), U$6.1 (VCC), U$7.1 (VCC), U$8.1 (VCC), U$10.1 (VCC); also elsewhere on the board

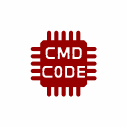
[picture p40: schematic fpa-sao.sch, sheet 4]

Parts:
U$9: CMD_C0DE_LOGOCMD_CODE_LOGO_SILK; CMD_C0DE_LOGO_SILK

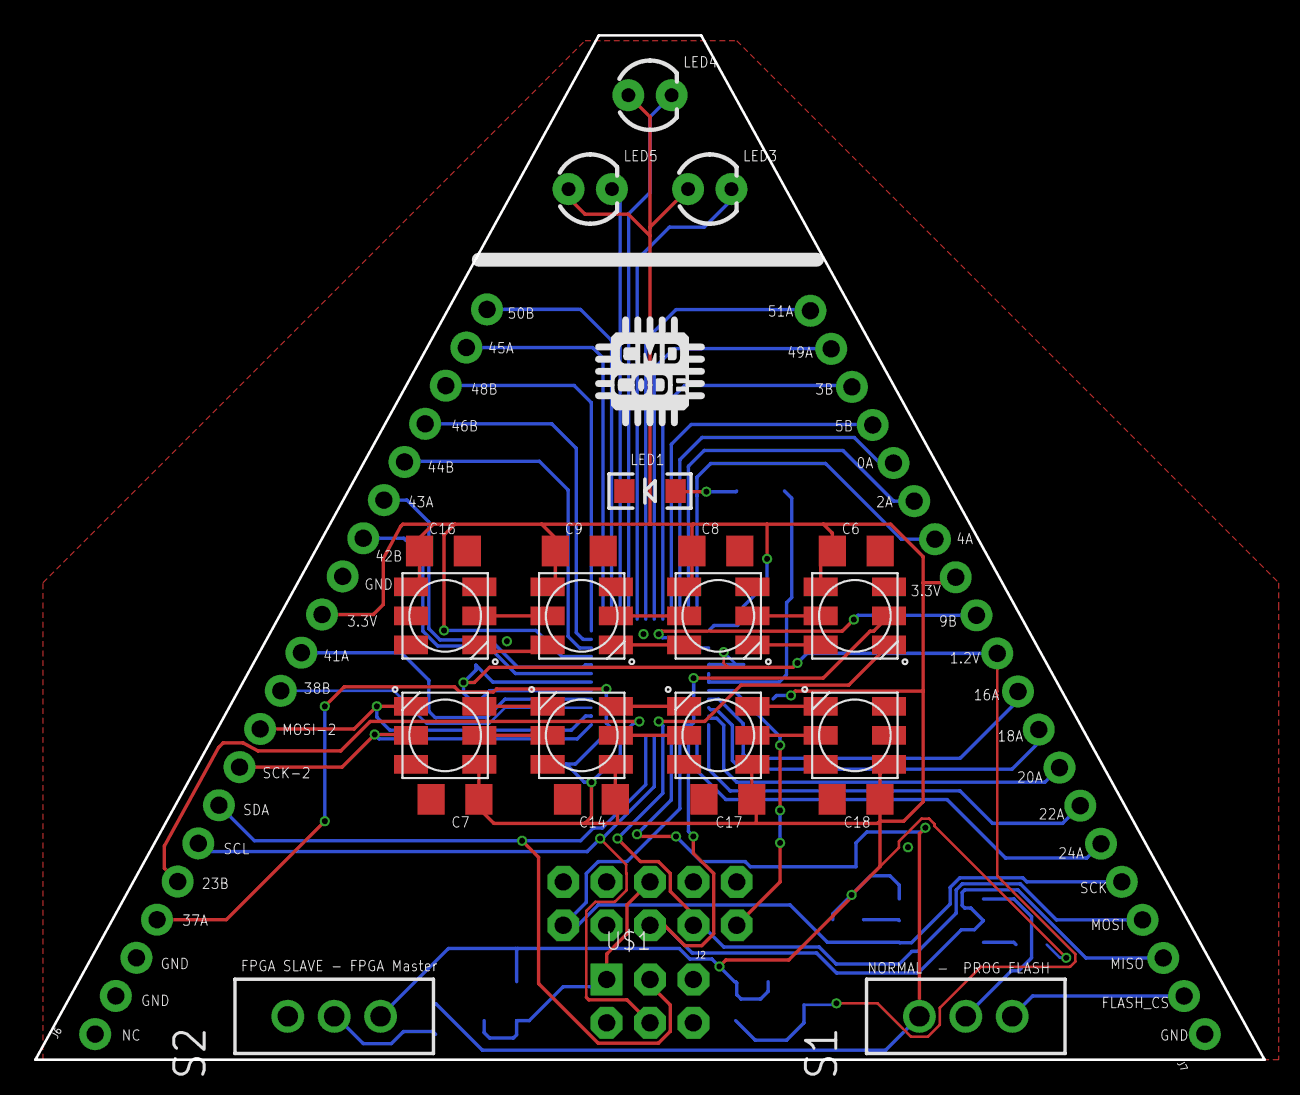
[picture p41: board fpa-sao.brd from above]

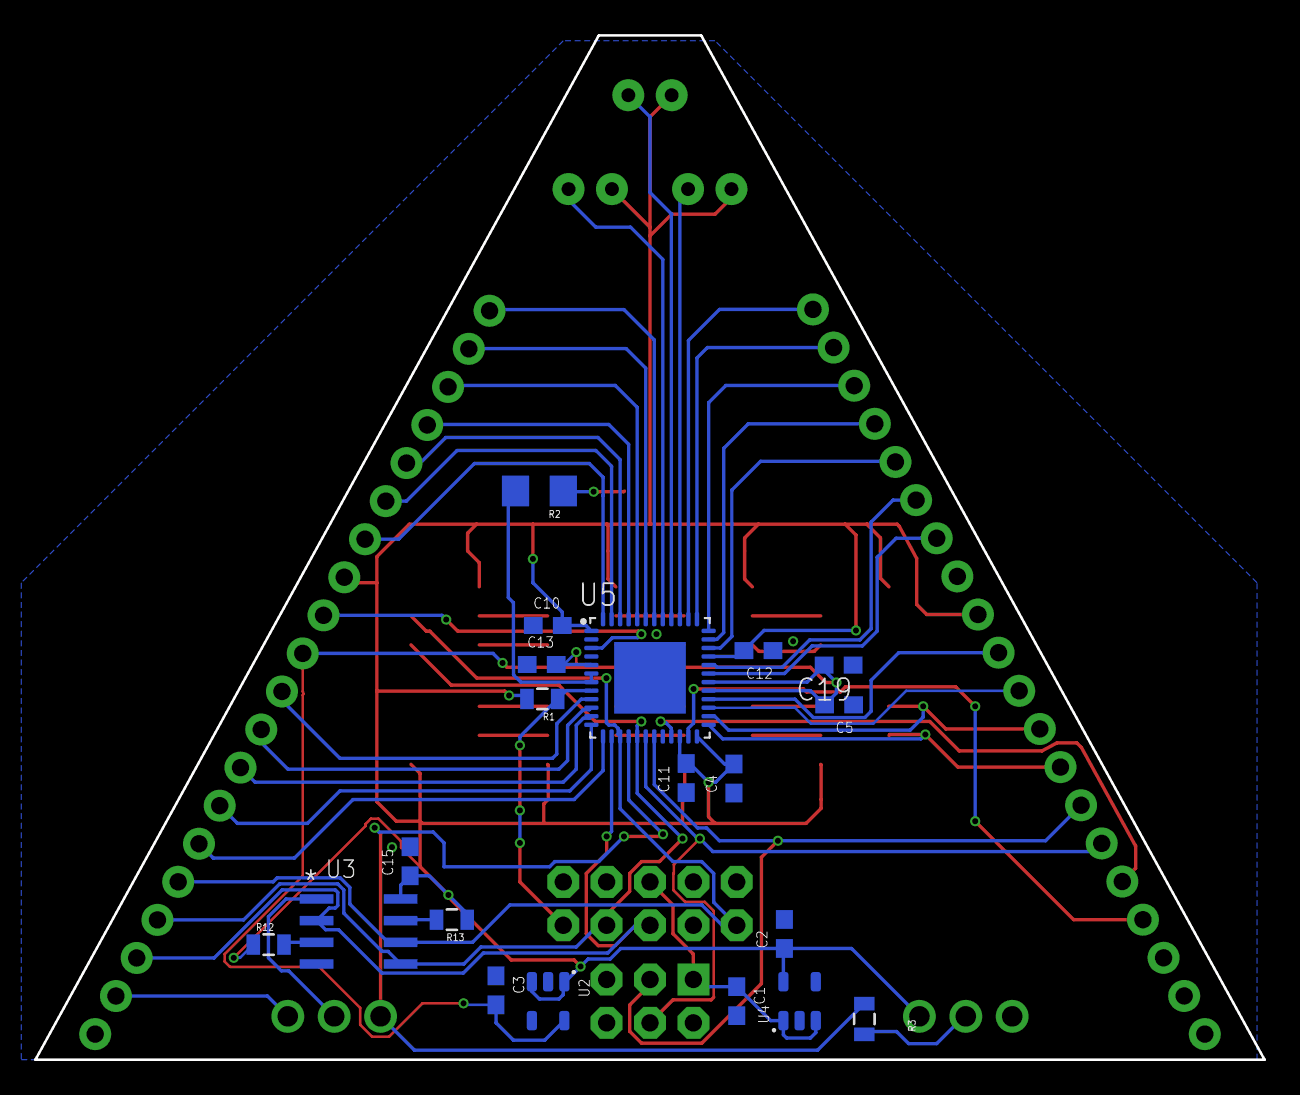
[picture p42: board fpa-sao.brd from below]

Board: 2 copper layers, 72.0 x 60.0 mm, 47 parts (20 on the bottom side), 59 nets.
