thedarknet/darknet8-badge/DC27/hardware/breakouts-for-testing/breakout-ledpca9956b.brd

## EAGLE design DC27/hardware/breakouts-for-testing/breakout-ledpca9956b.brd (2019-04-20)

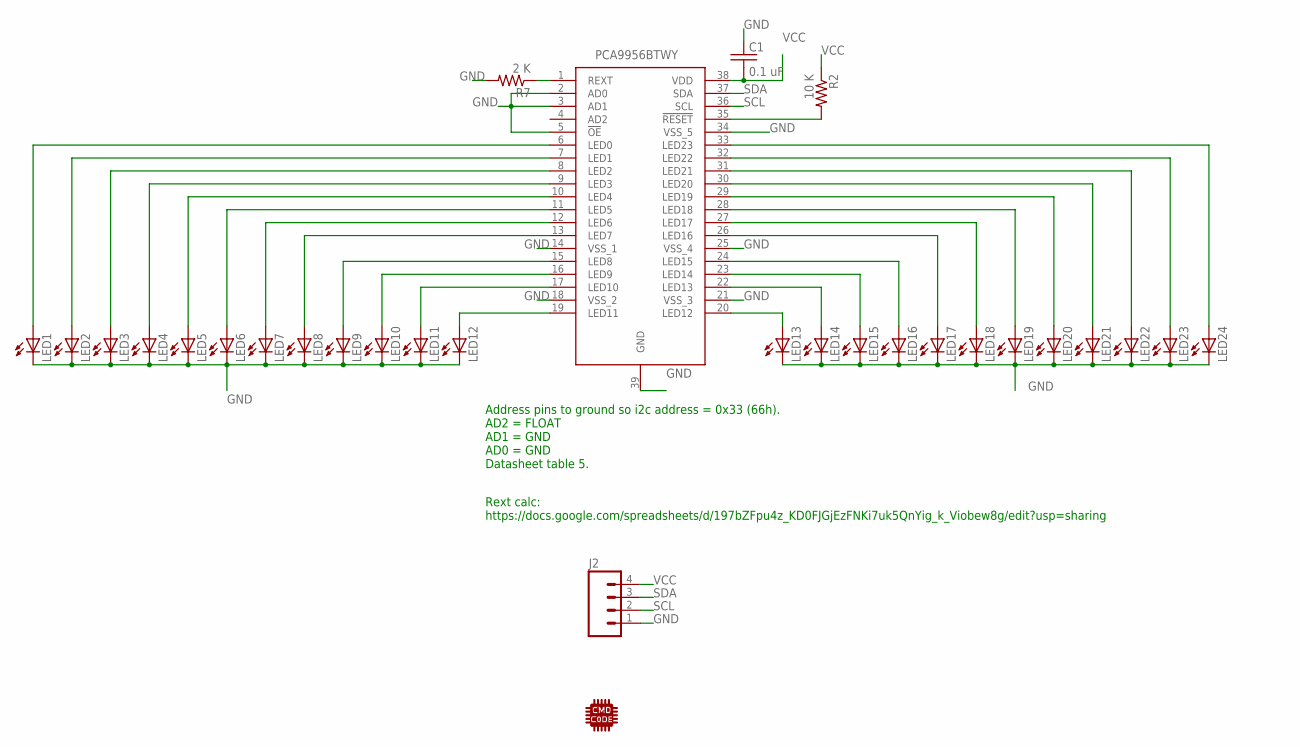
[picture p43: schematic breakout-ledpca9956b.sch]

Parts:
C1: 0.1 uF; C0805
IC1: PCA9956BTWY; SOP50P640X110-39N
J2: M04PTH; 1X04
LED1, LED2, LED3, LED4, LED5, LED6, LED7, LED8, LED9, LED10, LED11, LED12, LED13, LED14, LED15, LED16, LED17, LED18, LED19, LED20, LED21, LED22, LED23, LED24: LEDREVERSEMOUNT; GULLWING_LED
R2: 10 K; R0805
R7: 2 K; R0805
U$2: CMD_C0DE_LOGO

Connections:
GND: C1.1, IC1.2 (AD0), IC1.3 (AD1), IC1.5 (!OE), IC1.14 (VSS_1), IC1.18 (VSS_2), IC1.21 (VSS_3), IC1.25 (VSS_4), IC1.34 (VSS_5), IC1.39 (GND), J2.1, LED1.C, LED2.C, LED3.C, LED4.C, LED5.C, LED6.C, LED7.C, LED8.C, LED9.C, LED10.C, LED11.C, LED12.C, LED13.C, LED14.C, LED15.C, LED16.C, LED17.C, LED18.C, LED19.C, LED20.C, LED21.C, LED22.C, LED23.C, LED24.C, R7.2
unnamed: IC1.6 (LED0), LED1.A
unnamed: IC1.7 (LED1), LED2.A
unnamed: IC1.8 (LED2), LED3.A
unnamed: IC1.9 (LED3), LED4.A
unnamed: IC1.10 (LED4), LED5.A
unnamed: IC1.11 (LED5), LED6.A
unnamed: IC1.12 (LED6), LED7.A
unnamed: IC1.13 (LED7), LED8.A
unnamed: IC1.15 (LED8), LED9.A
unnamed: IC1.16 (LED9), LED10.A
unnamed: IC1.17 (LED10), LED11.A
unnamed: IC1.19 (LED11), LED12.A
unnamed: IC1.20 (LED12), LED13.A
unnamed: IC1.22 (LED13), LED14.A
unnamed: IC1.23 (LED14), LED15.A
unnamed: IC1.24 (LED15), LED16.A
unnamed: IC1.26 (LED16), LED17.A
unnamed: IC1.27 (LED17), LED18.A
unnamed: IC1.28 (LED18), LED19.A
unnamed: IC1.29 (LED19), LED20.A
unnamed: IC1.30 (LED20), LED21.A
unnamed: IC1.31 (LED21), LED22.A
unnamed: IC1.32 (LED22), LED23.A
unnamed: IC1.33 (LED23), LED24.A
unnamed: IC1.1 (REXT), R7.1
unnamed: IC1.35 (!RESET), R2.2
SCL: IC1.36 (SCL), J2.2
SDA: IC1.37 (SDA), J2.3
VCC: C1.2, IC1.38 (VDD), J2.4, R2.1

Notes on the sheet:
Address pins to ground so i2c address = 0x33 (66h). AD2 = FLOAT AD1 = GND AD0 = GND Datasheet table 5.
Rext calc: https://docs.google.com/spreadsheets/d/197bZFpu4z_KD0FJGjEzFNKi7uk5QnYig_k_Viobew8g/edit?usp=sharing

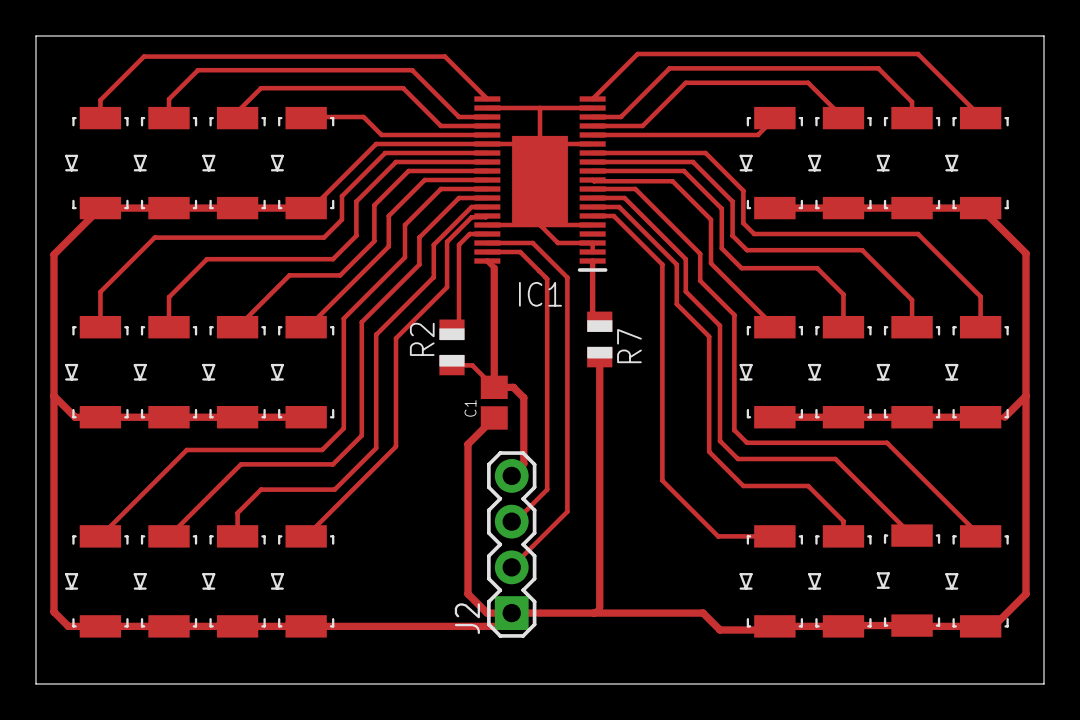
[picture p44: board breakout-ledpca9956b.brd from above]

Board: 2 copper layers, 56.0 x 36.0 mm, 30 parts (0 on the bottom side), 30 nets.
