thedarknet/darknet8-badge/DC27/hardware/breakouts-for-testing/atmega4089/atmega4089-breakout.brd

## EAGLE design DC27/hardware/breakouts-for-testing/atmega4089/atmega4089-breakout.brd (2019-05-16)

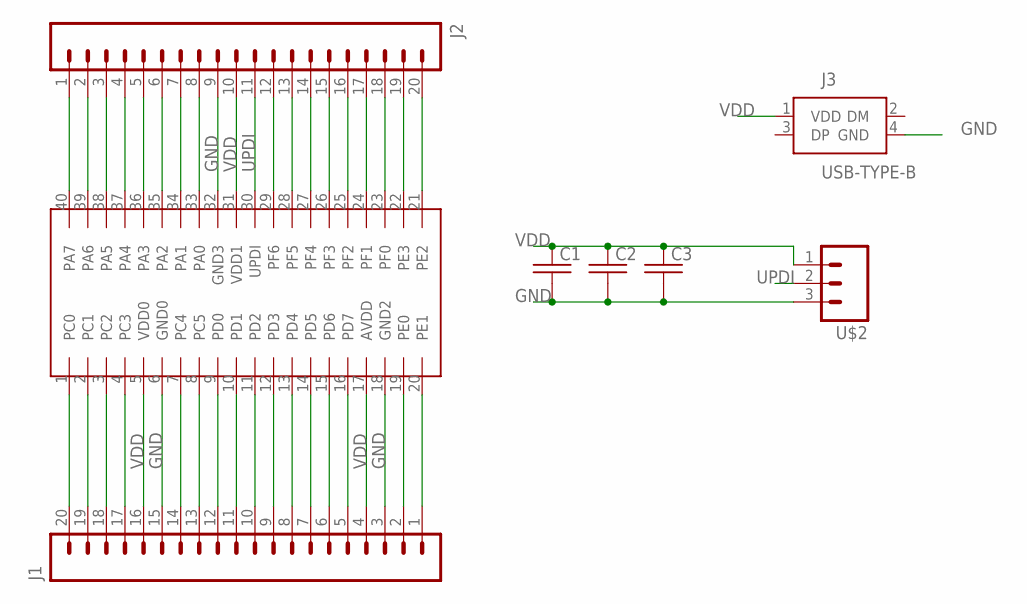
[picture p45: schematic atmega4089-breakout.sch]

Parts:
C1, C2, C3: C-USC0805; C0805
J1, J2: M20; 1X20
J3: USB-TYPE-B; 61400413321
U$1: ATMEGA4809-PFATMEL4809-PF; DIP1587W58P254L5175H635Q40B
U$2: M03; 1X03_UDPI

Connections:
GND: C1.2, C2.2, C3.2, J1.3, J1.15, J2.9, J3.4 (GND), U$1.6 (GND0), U$1.18 (GND2), U$1.32 (GND3), U$2.3
unnamed: J2.1, U$1.40 (PA7)
unnamed: J2.2, U$1.39 (PA6)
unnamed: J2.3, U$1.38 (PA5)
unnamed: J2.4, U$1.37 (PA4)
unnamed: J2.5, U$1.36 (PA3)
unnamed: J2.6, U$1.35 (PA2)
unnamed: J2.7, U$1.34 (PA1)
unnamed: J2.8, U$1.33 (PA0)
unnamed: J2.12, U$1.29 (PF6)
unnamed: J2.13, U$1.28 (PF5)
unnamed: J2.14, U$1.27 (PF4)
unnamed: J2.15, U$1.26 (PF3)
unnamed: J2.16, U$1.25 (PF2)
unnamed: J2.17, U$1.24 (PF1)
unnamed: J2.18, U$1.23 (PF0)
unnamed: J2.19, U$1.22 (PE3)
unnamed: J2.20, U$1.21 (PE2)
unnamed: J1.1, U$1.20 (PE1)
unnamed: J1.2, U$1.19 (PE0)
unnamed: J1.5, U$1.16 (PD7)
unnamed: J1.6, U$1.15 (PD6)
unnamed: J1.7, U$1.14 (PD5)
unnamed: J1.8, U$1.13 (PD4)
unnamed: J1.9, U$1.12 (PD3)
unnamed: J1.10, U$1.11 (PD2)
unnamed: J1.11, U$1.10 (PD1)
unnamed: J1.12, U$1.9 (PD0)
unnamed: J1.13, U$1.8 (PC5)
unnamed: J1.14, U$1.7 (PC4)
unnamed: J1.17, U$1.4 (PC3)
unnamed: J1.18, U$1.3 (PC2)
unnamed: J1.19, U$1.2 (PC1)
unnamed: J1.20, U$1.1 (PC0)
UPDI: J2.11, U$1.30 (UPDI), U$2.2
VDD: C1.1, C2.1, C3.1, J1.4, J1.16, J2.10, J3.1 (VDD), U$1.5 (VDD0), U$1.17 (AVDD), U$1.31 (VDD1), U$2.1

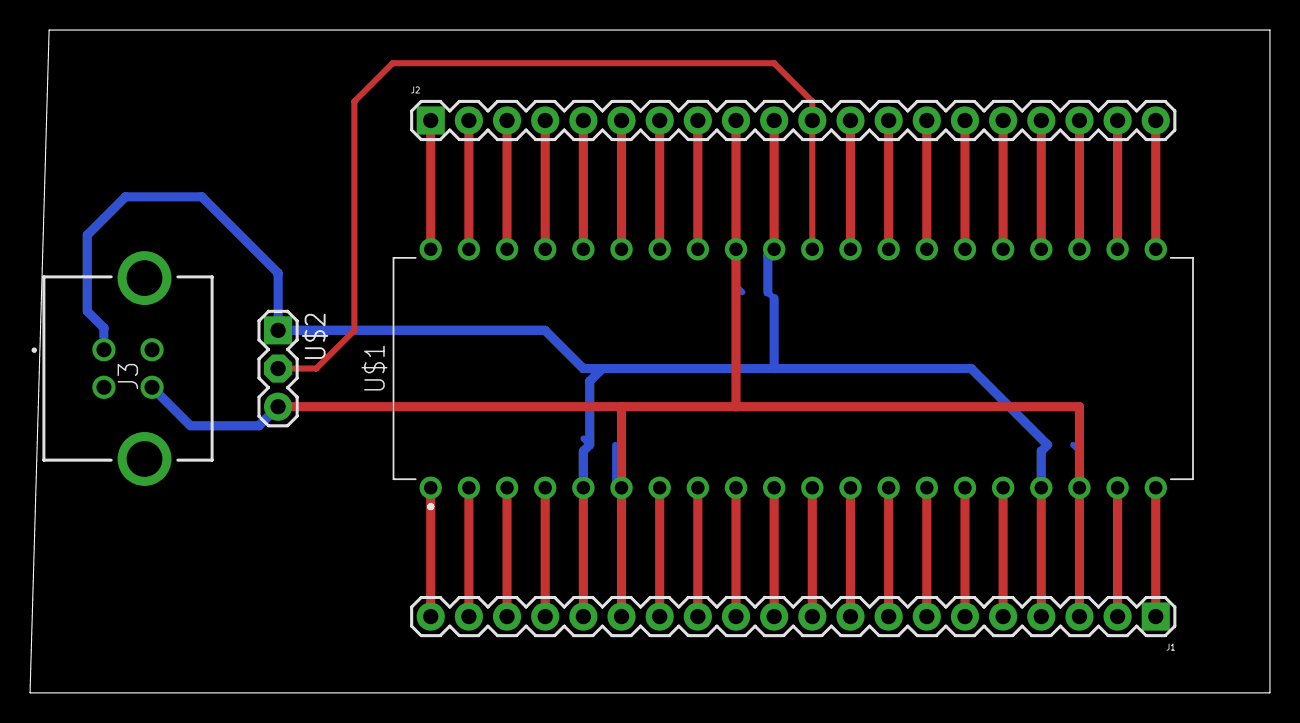
[picture p46: board atmega4089-breakout.brd from above]

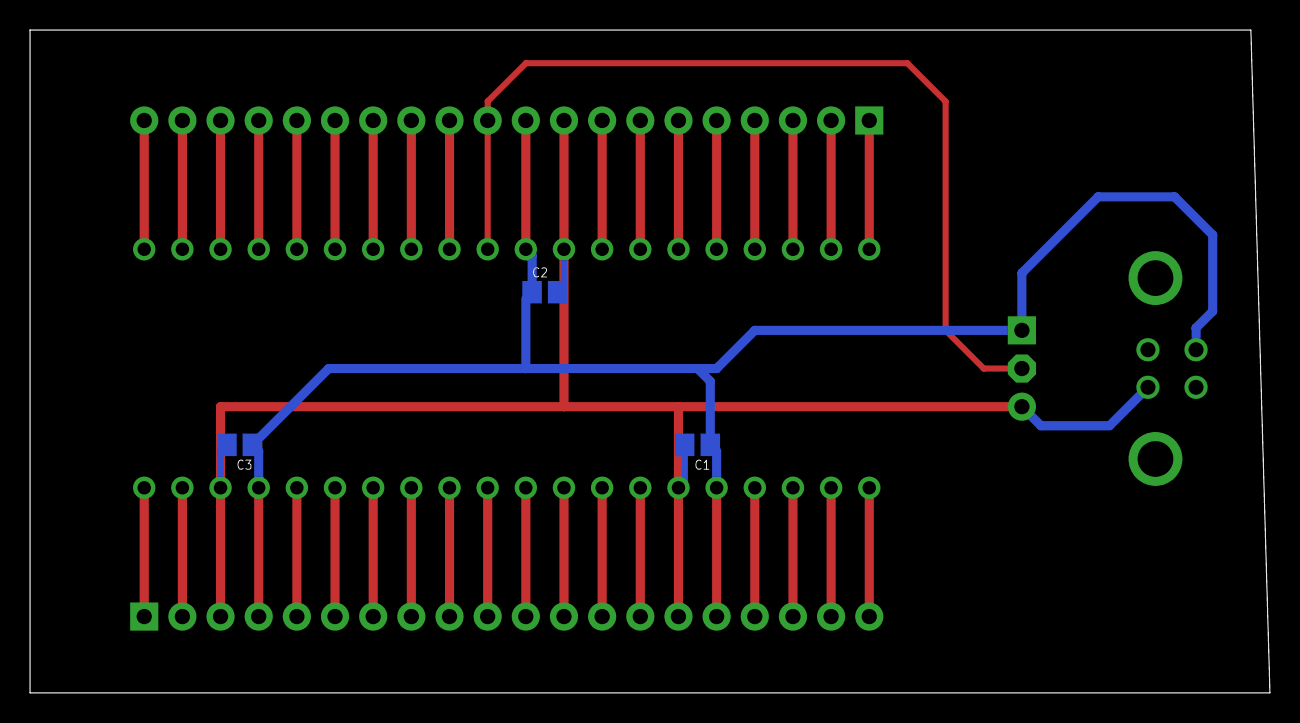
[picture p47: board atmega4089-breakout.brd from below]

Board: 2 copper layers, 82.5 x 44.1 mm, 8 parts (3 on the bottom side), 36 nets.
