thedarknet/darknet8-badge/Prototype1/hardware/prototype2/prototype2-whole-through-usb.brd

## EAGLE design Prototype1/hardware/prototype2/prototype2-whole-through-usb.brd (2019-05-05)

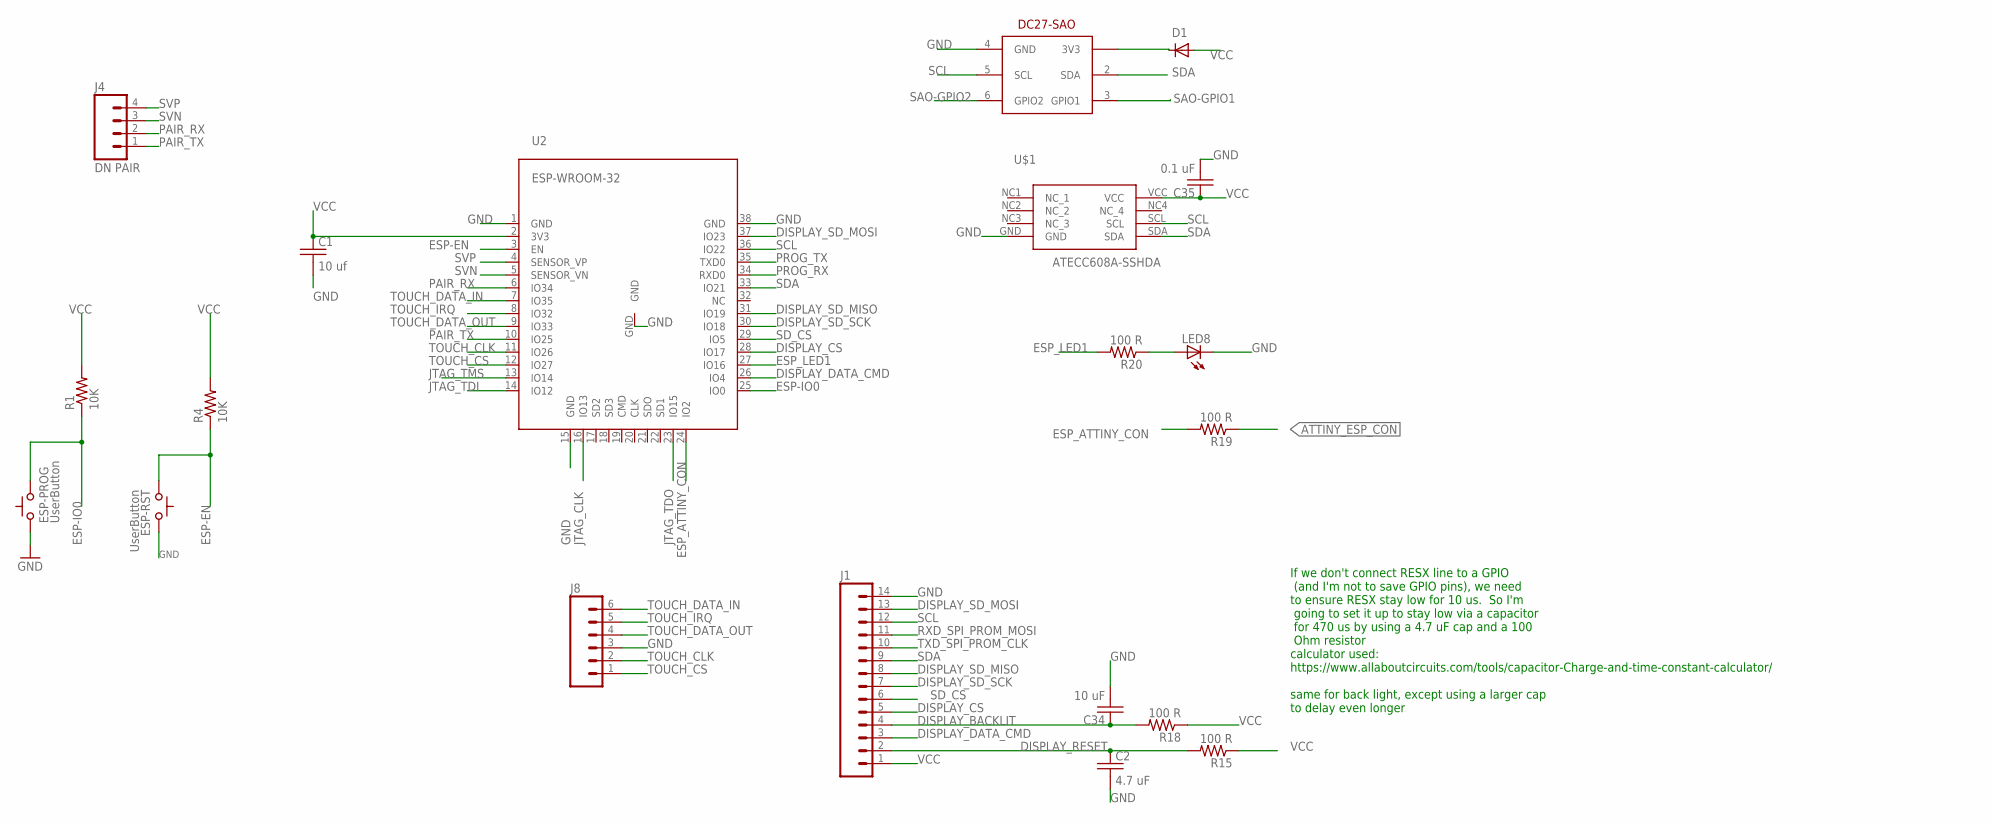
[picture p48: schematic prototype2-whole-through-usb.sch, sheet 1]

Parts:
C1: 10 uf; C0805
C2: 4.7 uF; C0805
C34: 10 uF; C0805
C35: 0.1 uF; C0805
D1: DIODESMA; SMA-DIODE
ESP-PROG: UserButton; TACTILE-2PIN-NARROW
ESP-RST: UserButton; TACTILE-2PIN-NARROW
J1: M14; 1X14
J4: DN PAIR; 1X04
J8: M06NO_SILK_YES_STOP; 1X06_NO_SILK_YES_STOP
LED8: LED3MM
R1, R4: 10K; 0805
R15, R18, R19, R20: 100 R; 0805
U2: ESP-WROOM-32
U$1: ATECC608A-SSHDA; 8-SOIC
U$4: DC-27-SAO; 3X2

Connections:
ATTINY_ESP_CON: R19.1; also elsewhere on the board
DISPLAY_BACKLIT: C34.1, J1.4, R18.2
DISPLAY_CS: J1.5, U2.28 (IO17)
DISPLAY_DATA_CMD: J1.3, U2.26 (IO4)
DISPLAY_RESET: C2.1, J1.2, R15.2
DISPLAY_SD_MISO: J1.8, U2.31 (IO19)
DISPLAY_SD_MOSI: J1.13, U2.37 (IO23)
DISPLAY_SD_SCK: J1.7, U2.30 (IO18)
ESP-EN: ESP-RST.P$2 (C), R4.1, U2.3 (EN)
ESP-IO0: ESP-PROG.P$1 (A), R1.1, U2.25 (IO0)
ESP_ATTINY_CON: R19.2, U2.24 (IO2)
ESP_LED1: R20.2, U2.27 (IO16)
GND: C1.2, C2.2, C34.2, C35.2, ESP-PROG.P$2 (C), ESP-RST.P$1 (A), J1.14, J8.3, LED8.K (C), U2.1 (GND), U2.15 (GND), U2.38 (GND), U2.GND, U$1.GND, U$4.4 (GND); also elsewhere on the board
JTAG_CLK: U2.16 (IO13); also elsewhere on the board
JTAG_TDI: U2.14 (IO12); also elsewhere on the board
JTAG_TDO: U2.23 (IO15); also elsewhere on the board
JTAG_TMS: U2.13 (IO14); also elsewhere on the board
unnamed: D1.C, U$4.1 (3V3)
unnamed: LED8.A, R20.1
PAIR_RX: J4.2, U2.6 (IO34)
PAIR_TX: J4.1, U2.10 (IO25)
PROG_RX: U2.34 (RXD0); also elsewhere on the board
PROG_TX: U2.35 (TXD0); also elsewhere on the board
RXD_SPI_PROM_MOSI: J1.11; also elsewhere on the board
SAO-GPIO1: U$4.3 (GPIO1)
SAO-GPIO2: U$4.6 (GPIO2)
SCL: J1.12, U2.36 (IO22), U$1.SCL, U$4.5 (SCL)
SDA: J1.9, U2.33 (IO21), U$1.SDA, U$4.2 (SDA)
SD_CS: J1.6, U2.29 (IO5)
SVN: J4.3, U2.5 (SENSOR_VN)
SVP: J4.4, U2.4 (SENSOR_VP)
TOUCH_CLK: J8.2, U2.11 (IO26)
TOUCH_CS: J8.1, U2.12 (IO27)
TOUCH_DATA_IN: J8.6, U2.7 (IO35)
TOUCH_DATA_OUT: J8.4, U2.9 (IO33)
TOUCH_IRQ: J8.5, U2.8 (IO32)
TXD_SPI_PROM_CLK: J1.10; also elsewhere on the board
VCC: C1.1, C35.1, D1.A, J1.1, R1.2, R4.2, R15.1, R18.1, U2.2 (3V3), U$1.VCC; also elsewhere on the board

Notes on the sheet:
If we don't connect RESX line to a GPIO (and I'm not to save GPIO pins), we need to ensure RESX stay low for 10 us. So I'm going to set it up to stay low via a capacitor for 470 us by using a 4.7 uF cap and a 100 Ohm resistor calculator used: https://www.allaboutcircuits.com/tools/capacitor-Charge-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

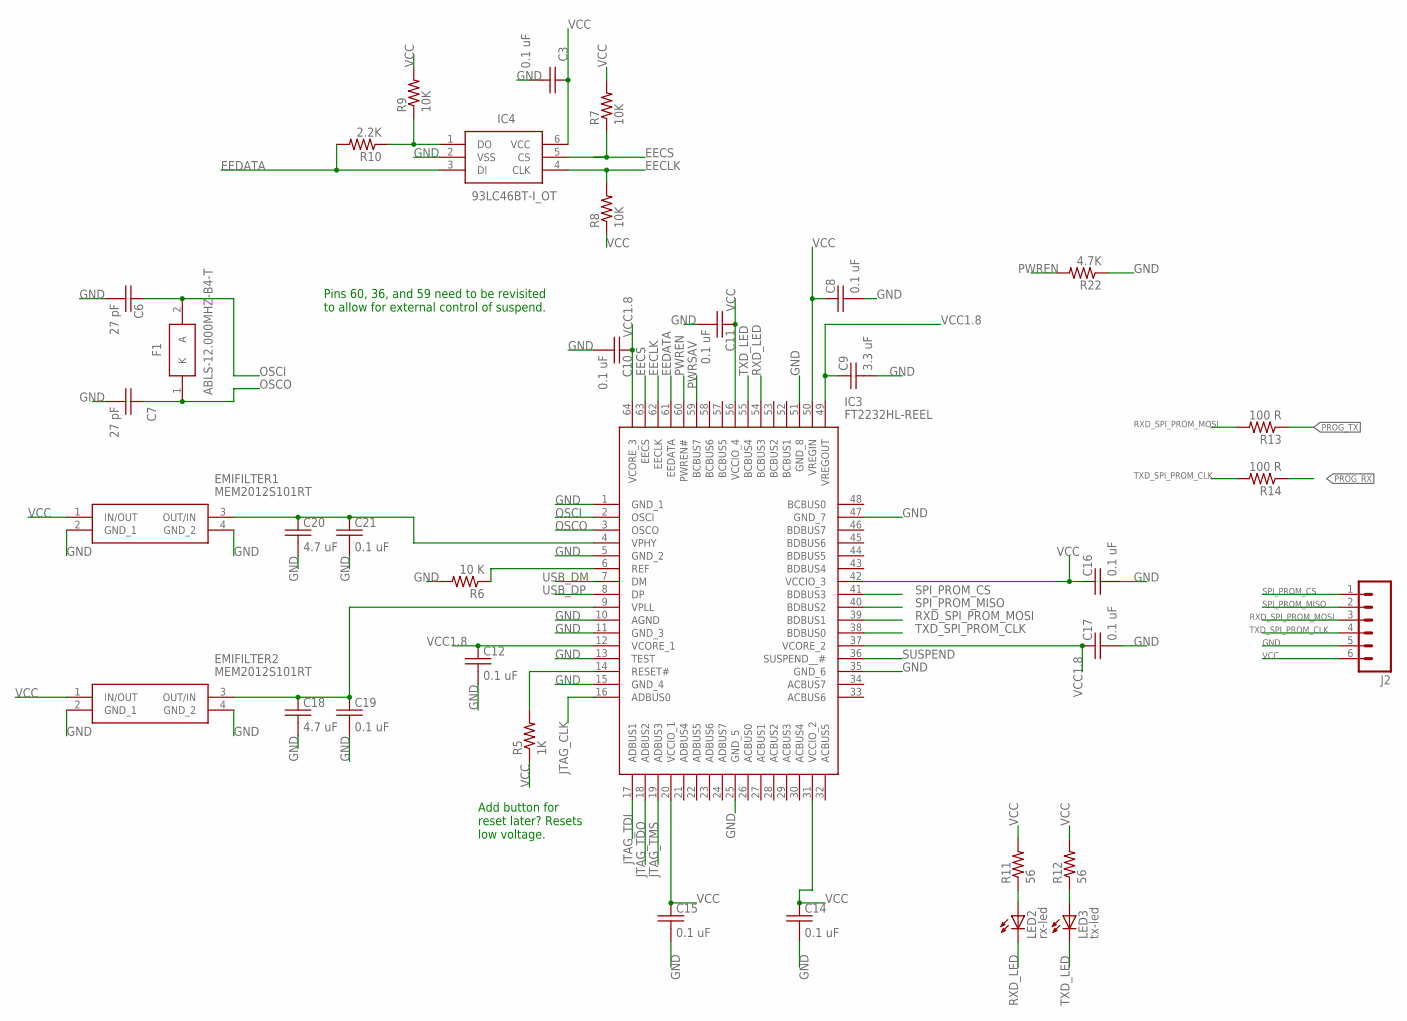
[picture p49: schematic prototype2-whole-through-usb.sch, sheet 2]

Parts:
C3, C8, C10, C11, C12, C14, C15, C16, C17, C19, C21: 0.1 uF; C0805
C6, C7: 27 pF; C0805
C9: 3.3 uF; C0805
C18, C20: 4.7 uF; C0805
EMIFILTER1, EMIFILTER2: MEM2012S101RT
F1: ABLS-12.000MHZ-B4-T; HC/49US-(AT49)_1
IC3: FT2232HL-REEL; QFP50P1200X1200X160-64N
IC4: 93LC46BT-I_OT; SOT95P270X145-6N
J2: M06SILK_FEMALE_PTH; 1X06
LED2: rx-led; LED3MM
LED3: tx-led; LED3MM
R5: 1K; 0805
R6: 10 K; 0805
R7, R8, R9: 10K; 0805
R10: 2.2K; 0805
R11, R12: 56; 0805
R13, R14: 100 R; 0805
R22: 4.7K; 0805

Connections:
EECLK: IC3.62 (EECLK), IC4.4 (CLK), R8.2
EECS: IC3.63 (EECS), IC4.5 (CS), R7.1
EEDATA: IC3.61 (EEDATA), IC4.3 (DI), R10.2
GND: C3.2, C6.2, C7.2, C8.2, C9.2, C10.2, C11.2, C12.2, C14.2, C15.2, C16.2, C17.2, C18.2, C19.2, C20.2, C21.2, EMIFILTER1.2 (GND_1), EMIFILTER1.4 (GND_2), EMIFILTER2.2 (GND_1), EMIFILTER2.4 (GND_2), IC3.1 (GND_1), IC3.5 (GND_2), IC3.10 (AGND), IC3.11 (GND_3), IC3.13 (TEST), IC3.15 (GND_4), IC3.25 (GND_5), IC3.35 (GND_6), IC3.47 (GND_7), IC3.51 (GND_8), IC4.2 (VSS), J2.5, R6.2, R22.1; also elsewhere on the board
JTAG_CLK: IC3.16 (ADBUS0); also elsewhere on the board
JTAG_TDI: IC3.17 (ADBUS1); also elsewhere on the board
JTAG_TDO: IC3.18 (ADBUS2); also elsewhere on the board
JTAG_TMS: IC3.19 (ADBUS3); also elsewhere on the board
unnamed: IC3.14 (RESET#), R5.2
unnamed: IC3.6 (REF), R6.1
unnamed: IC4.1 (DO), R9.1, R10.1
unnamed: LED2.A, R11.1
unnamed: LED3.A, R12.1
unnamed: C18.1, C19.1, EMIFILTER2.3 (OUT/IN), IC3.9 (VPLL)
unnamed: C20.1, C21.1, EMIFILTER1.3 (OUT/IN), IC3.4 (VPHY)
OSCI: C6.1, F1.2 (A), IC3.2 (OSCI)
OSCO: C7.1, F1.1 (K), IC3.3 (OSCO)
PROG_RX: R14.1; also elsewhere on the board
PROG_TX: R13.1; also elsewhere on the board
PWREN: IC3.60 (PWREN#), R22.2
PWRSAV: IC3.59 (BCBUS7)
RXD_LED: IC3.54 (BCBUS3), LED2.K (C)
RXD_SPI_PROM_MOSI: IC3.39 (BDBUS1), J2.3, R13.2; also elsewhere on the board
SPI_PROM_CS: IC3.41 (BDBUS3), J2.1
SPI_PROM_MISO: IC3.40 (BDBUS2), J2.2
SUSPEND: IC3.36 (SUSPEND__#)
TXD_LED: IC3.55 (BCBUS4), LED3.K (C)
TXD_SPI_PROM_CLK: IC3.38 (BDBUS0), J2.4, R14.2; also elsewhere on the board
USB_DM: IC3.7 (DM); also elsewhere on the board
USB_DP: IC3.8 (DP); also elsewhere on the board
VCC: C3.1, C8.1, C11.1, C14.1, C15.1, C16.1, EMIFILTER1.1 (IN/OUT), EMIFILTER2.1 (IN/OUT), IC3.20 (VCCIO_1), IC3.31 (VCCIO_2), IC3.42 (VCCIO_3), IC3.50 (VREGIN), IC3.56 (VCCIO_4), IC4.6 (VCC), J2.6, R5.1, R7.2, R8.1, R9.2, R11.2, R12.2; also elsewhere on the board
VCC1.8: C9.1, C10.1, C12.1, C17.1, IC3.12 (VCORE_1), IC3.37 (VCORE_2), IC3.49 (VREGOUT), IC3.64 (VCORE_3)

Notes on the sheet:
Add button for reset later? Resets low voltage.
Pins 60, 36, and 59 need to be revisited to allow for external control of suspend.

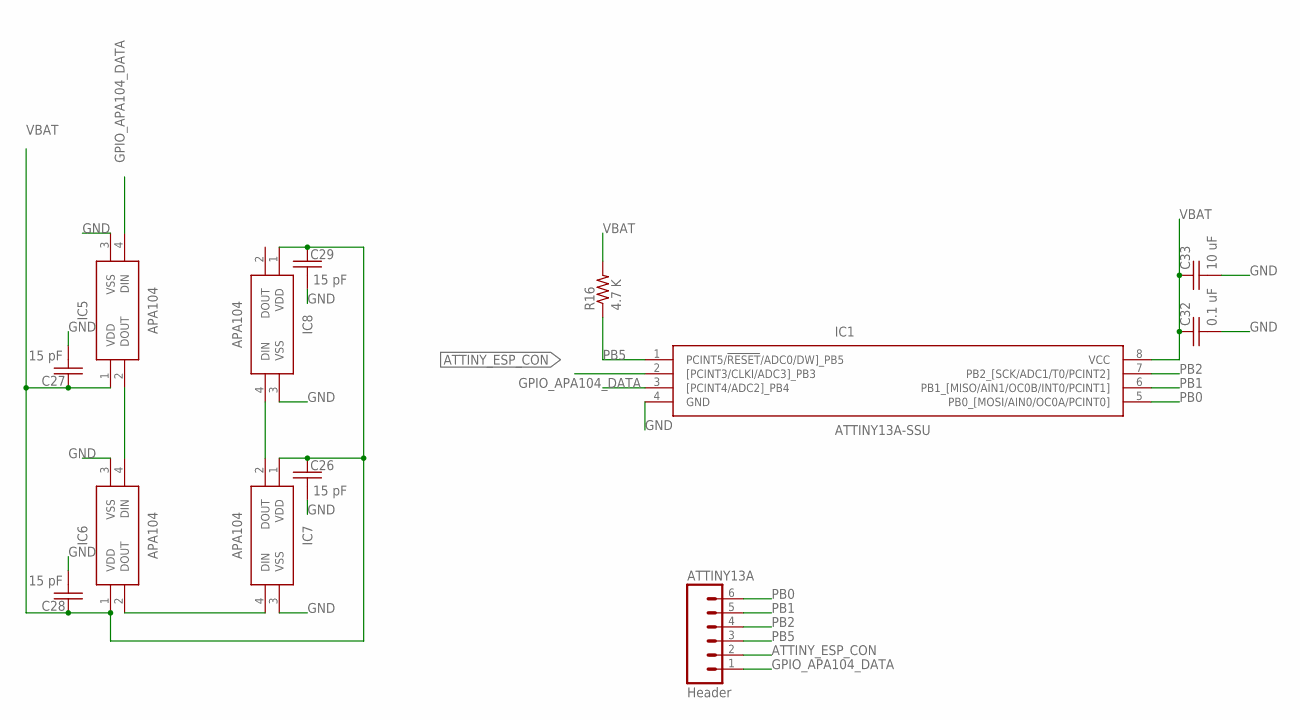
[picture p50: schematic prototype2-whole-through-usb.sch, sheet 3]

Parts:
ATTINY13A: Header; 1X06
C26, C27, C28, C29: 15 pF; C0805
C32: 0.1 uF; C0805
C33: 10 uF; C0805
IC1: ATTINY13A-SSU; SOIC127P600X175-8N
IC5, IC6, IC7, IC8: APA104
R16: 4.7 K; 0805

Connections:
ATTINY_ESP_CON: ATTINY13A.2, IC1.2 ([PCINT3/CLKI/ADC3]_PB3); also elsewhere on the board
GND: C26.2, C27.2, C28.2, C29.2, C32.2, C33.2, IC1.4 (GND), IC5.3 (VSS), IC6.3 (VSS), IC7.3 (VSS), IC8.3 (VSS); also elsewhere on the board
GPIO_APA104_DATA: ATTINY13A.1, IC1.3 ([PCINT4/ADC2]_PB4), IC5.4 (DIN)
unnamed: IC5.2 (DOUT), IC6.4 (DIN)
unnamed: IC6.2 (DOUT), IC7.4 (DIN)
unnamed: IC7.2 (DOUT), IC8.4 (DIN)
PB0: ATTINY13A.6, IC1.5 (PB0_[MOSI/AIN0/OC0A/PCINT0])
PB1: ATTINY13A.5, IC1.6 (PB1_[MISO/AIN1/OC0B/INT0/PCINT1])
PB2: ATTINY13A.4, IC1.7 (PB2_[SCK/ADC1/T0/PCINT2])
PB5: ATTINY13A.3, IC1.1 (PCINT5/!RESET!/ADC0/DW]_PB5), R16.1
VBAT: C26.1, C27.1, C28.1, C29.1, C32.1, C33.1, IC1.8 (VCC), IC5.1 (VDD), IC6.1 (VDD), IC7.1 (VDD), IC8.1 (VDD), R16.2; also elsewhere on the board
