thedarknet/darknet8-badge/Prototype1/hardware/prototype2/prototype2-whole-through-usb.brd

## EAGLE design Prototype1/hardware/prototype2/prototype2-whole-through-usb.brd (continued)

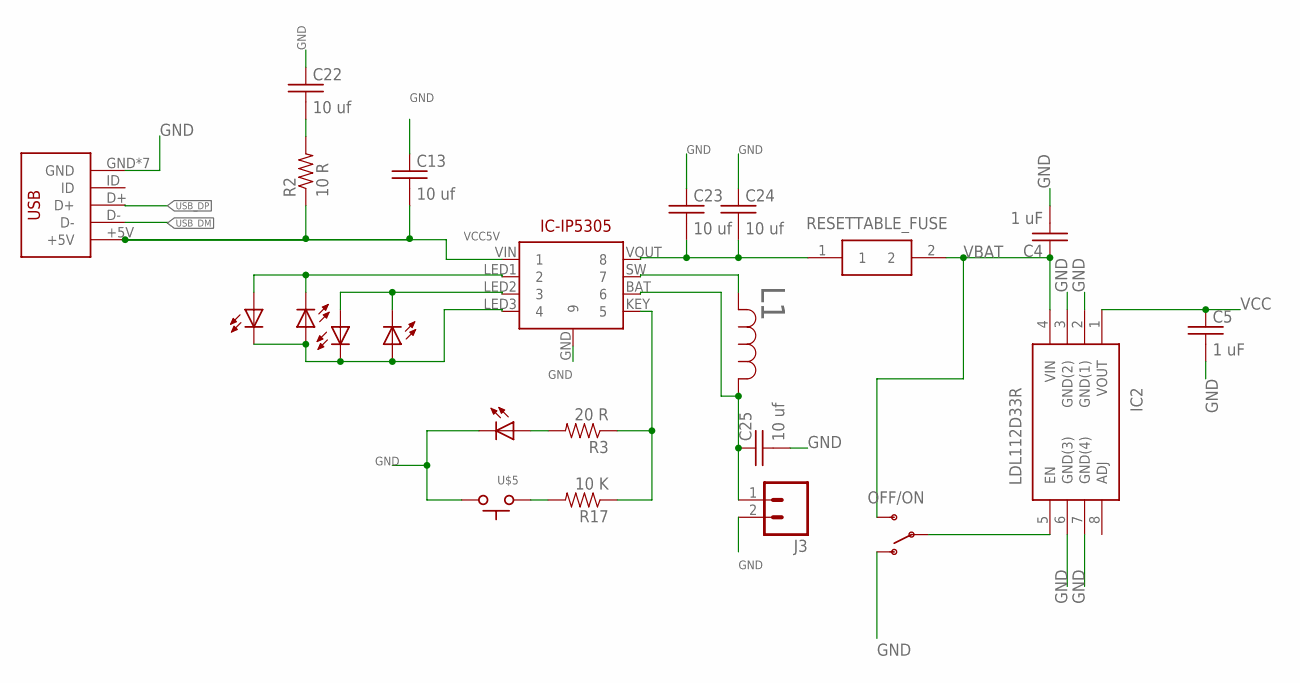
[picture p51: schematic prototype2-whole-through-usb.sch, sheet 4]

Parts:
C4, C5: 1 uF; C0805
C13, C22, C23, C24, C25: 10 uf; C0805
IC2: LDL112D33R; SOIC127P600X175-8N
IC-IP5305: IP5305ESOP8; SOIC127P600X165-8
J3: M02PTH; 1X02
L1: NRS4018T2R2MDGJ; IND_TAIYO_NRS4018
LED1, LED4, LED5, LED6, LED7: LED3MM
OFF/ON: SWITCH-SPSTKIT; SWITCH-SPDT_KIT
R2: 10 R; 0805
R3: 20 R; 0805
R17: 10 K; 0805
RESETTABLE_FUSE: 0ZCJ0050FF2G; FUSC3216X55N
U$2: DX4R005JJ2DX4R005JJ2; DX4R005JJ2
U$5: SWITCH_TACTILETACTILE-2PIN-NARROW; TACTILE-2PIN-NARROW

Connections:
GND: C4.2, C5.2, C13.1, C22.1, C23.1, C24.1, C25.2, IC2.2 (GND(1)), IC2.3 (GND(2)), IC2.6 (GND(3)), IC2.7 (GND(4)), IC-IP5305.GND (9), J3.2, LED7.K (C), OFF/ON.1 (O), U$2.GND, U$2.P$6 (GND), U$2.P$7 (GND), U$2.P$8 (GND), U$2.P$9 (GND), U$2.P$10 (GND), U$2.P$11 (GND), U$5.P$1 (A); also elsewhere on the board
unnamed: IC2.5 (EN), OFF/ON.2
unnamed: IC-IP5305.LED1 (2), LED1.A, LED4.K (C)
unnamed: C23.2, C24.2, IC-IP5305.VOUT (8), RESETTABLE_FUSE.1
unnamed: IC-IP5305.LED2 (3), LED5.A, LED6.K (C)
unnamed: IC-IP5305.LED3 (4), LED1.K (C), LED4.A, LED5.K (C), LED6.A
unnamed: C22.2, R2.2
unnamed: IC-IP5305.SW (7), L1.2
unnamed: C25.1, IC-IP5305.BAT (6), J3.1, L1.1
unnamed: IC-IP5305.KEY (5), R3.1, R17.1
unnamed: LED7.A, R3.2
unnamed: R17.2, U$5.P$2 (C)
USB_DM: U$2.D-; also elsewhere on the board
USB_DP: U$2.D+; also elsewhere on the board
VBAT: C4.1, IC2.4 (VIN), OFF/ON.3 (S), RESETTABLE_FUSE.2; also elsewhere on the board
VCC: C5.1, IC2.1 (VOUT); also elsewhere on the board
VCC5V: C13.2, IC-IP5305.VIN (1), R2.1, U$2.+5V


Parts:
U$3: CMD_C0DE_LOGOCMD_CODE_LOGO_TOP_COPPER; CMD_C0DE_LOGO_TOP_COPPER

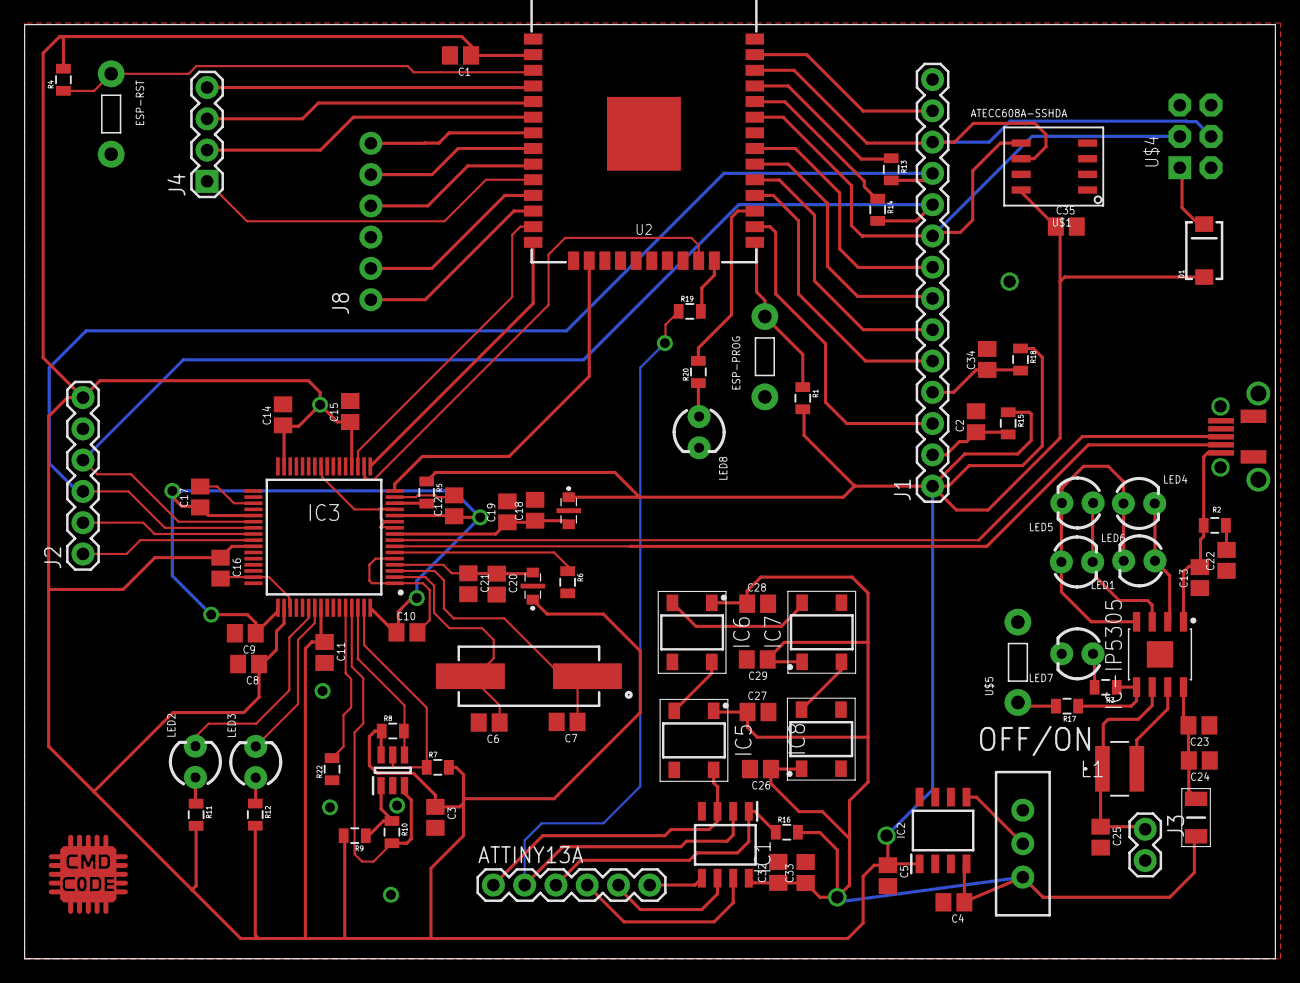
[picture p52: board prototype2-whole-through-usb.brd from above]

Board: 2 copper layers, 101.6 x 75.9 mm, 92 parts (0 on the bottom side), 77 nets.
