thedarknet/darknet8-badge/Prototype1/hardware/ft2232H Breakout/ft2232h-breakout-with-ground-planesch.brd

## EAGLE design Prototype1/hardware/ft2232H Breakout/ft2232h-breakout-with-ground-planesch.brd (2019-03-21)

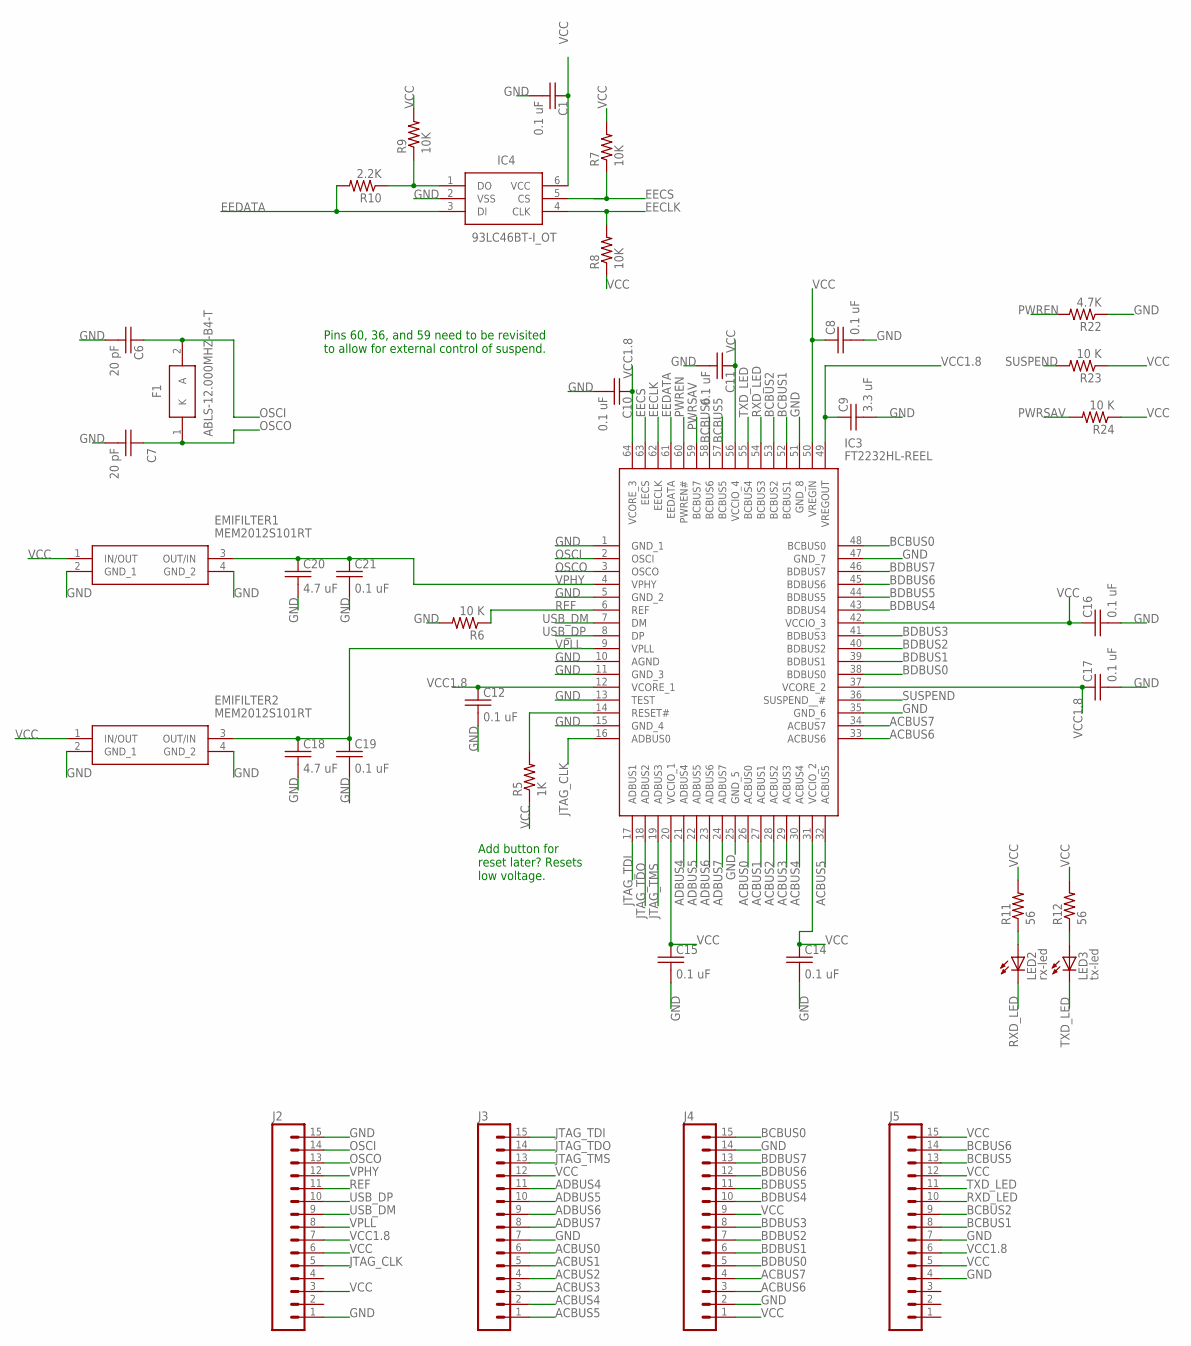
[picture p53: schematic ft2232h-breakout-with-ground-planesch.sch, sheet 1]

Parts:
C1, C8, C10, C11, C12, C14, C15, C16, C17, C19, C21: 0.1 uF; C0805
C6, C7: 20 pF; C0805
C9: 3.3 uF; C0805
C18, C20: 4.7 uF; C0805
EMIFILTER1, EMIFILTER2: MEM2012S101RT
F1: ABLS-12.000MHZ-B4-T; HC/49US-(AT49)_1
IC3: FT2232HL-REEL; QFP50P1200X1200X160-64N
IC4: 93LC46BT-I_OT; SOT95P270X145-6N
J2, J3, J4, J5: M15; 1X15
LED2: rx-led; LED3MM
LED3: tx-led; LED3MM
R5: 1K; 0805
R6, R23, R24: 10 K; 0805
R7, R8, R9: 10K; 0805
R10: 2.2K; 0805
R11, R12: 56; 0805
R22: 4.7K; 0805

Connections:
ACBUS0: IC3.26 (ACBUS0), J3.6
ACBUS1: IC3.27 (ACBUS1), J3.5
ACBUS2: IC3.28 (ACBUS2), J3.4
ACBUS3: IC3.29 (ACBUS3), J3.3
ACBUS4: IC3.30 (ACBUS4), J3.2
ACBUS5: IC3.32 (ACBUS5), J3.1
ACBUS6: IC3.33 (ACBUS6), J4.3
ACBUS7: IC3.34 (ACBUS7), J4.4
ADBUS4: IC3.21 (ADBUS4), J3.11
ADBUS5: IC3.22 (ADBUS5), J3.10
ADBUS6: IC3.23 (ADBUS6), J3.9
ADBUS7: IC3.24 (ADBUS7), J3.8
BCBUS0: IC3.48 (BCBUS0), J4.15
BCBUS1: IC3.52 (BCBUS1), J5.8
BCBUS2: IC3.53 (BCBUS2), J5.9
BCBUS5: IC3.57 (BCBUS5), J5.13
BCBUS6: IC3.58 (BCBUS6), J5.14
BDBUS0: IC3.38 (BDBUS0), J4.5
BDBUS1: IC3.39 (BDBUS1), J4.6
BDBUS2: IC3.40 (BDBUS2), J4.7
BDBUS3: IC3.41 (BDBUS3), J4.8
BDBUS4: IC3.43 (BDBUS4), J4.10
BDBUS5: IC3.44 (BDBUS5), J4.11
BDBUS6: IC3.45 (BDBUS6), J4.12
BDBUS7: IC3.46 (BDBUS7), J4.13
EECLK: IC3.62 (EECLK), IC4.4 (CLK), R8.2
EECS: IC3.63 (EECS), IC4.5 (CS), R7.1
EEDATA: IC3.61 (EEDATA), IC4.3 (DI), R10.2
GND: C1.2, C6.2, C7.2, C8.2, C9.2, C10.2, C11.2, C12.2, C14.2, C15.2, C16.2, C17.2, C18.2, C19.2, C20.2, C21.2, EMIFILTER1.2 (GND_1), EMIFILTER1.4 (GND_2), EMIFILTER2.2 (GND_1), EMIFILTER2.4 (GND_2), IC3.1 (GND_1), IC3.5 (GND_2), IC3.10 (AGND), IC3.11 (GND_3), IC3.13 (TEST), IC3.15 (GND_4), IC3.25 (GND_5), IC3.35 (GND_6), IC3.47 (GND_7), IC3.51 (GND_8), IC4.2 (VSS), J2.1, J2.15, J3.7, J4.2, J4.14, J5.4, J5.7, R6.2, R22.1; also elsewhere on the board
JTAG_CLK: IC3.16 (ADBUS0), J2.5
JTAG_TDI: IC3.17 (ADBUS1), J3.15
JTAG_TDO: IC3.18 (ADBUS2), J3.14
JTAG_TMS: IC3.19 (ADBUS3), J3.13
unnamed: IC3.14 (RESET#), R5.2
unnamed: IC4.1 (DO), R9.1, R10.1
unnamed: LED2.A, R11.1
unnamed: LED3.A, R12.1
OSCI: C6.1, F1.2 (A), IC3.2 (OSCI), J2.14
OSCO: C7.1, F1.1 (K), IC3.3 (OSCO), J2.13
PWREN: IC3.60 (PWREN#), R22.2
PWRSAV: IC3.59 (BCBUS7), R24.2
REF: IC3.6 (REF), J2.11, R6.1
RXD_LED: IC3.54 (BCBUS3), J5.10, LED2.K (C)
SUSPEND: IC3.36 (SUSPEND__#), R23.2
TXD_LED: IC3.55 (BCBUS4), J5.11, LED3.K (C)
USB_DM: IC3.7 (DM), J2.9; also elsewhere on the board
USB_DP: IC3.8 (DP), J2.10; also elsewhere on the board
VCC: C1.1, C8.1, C11.1, C14.1, C15.1, C16.1, EMIFILTER1.1 (IN/OUT), EMIFILTER2.1 (IN/OUT), IC3.20 (VCCIO_1), IC3.31 (VCCIO_2), IC3.42 (VCCIO_3), IC3.50 (VREGIN), IC3.56 (VCCIO_4), IC4.6 (VCC), J2.3, J2.6, J3.12, J4.1, J4.9, J5.5, J5.12, J5.15, R5.1, R7.2, R8.1, R9.2, R11.2, R12.2, R23.1, R24.1; also elsewhere on the board
VCC1.8: C9.1, C10.1, C12.1, C17.1, IC3.12 (VCORE_1), IC3.37 (VCORE_2), IC3.49 (VREGOUT), IC3.64 (VCORE_3), J2.7, J5.6
VPHY: C20.1, C21.1, EMIFILTER1.3 (OUT/IN), IC3.4 (VPHY), J2.12
VPLL: C18.1, C19.1, EMIFILTER2.3 (OUT/IN), IC3.9 (VPLL), J2.8

Notes on the sheet:
Add button for reset later? Resets low voltage.
Pins 60, 36, and 59 need to be revisited to allow for external control of suspend.

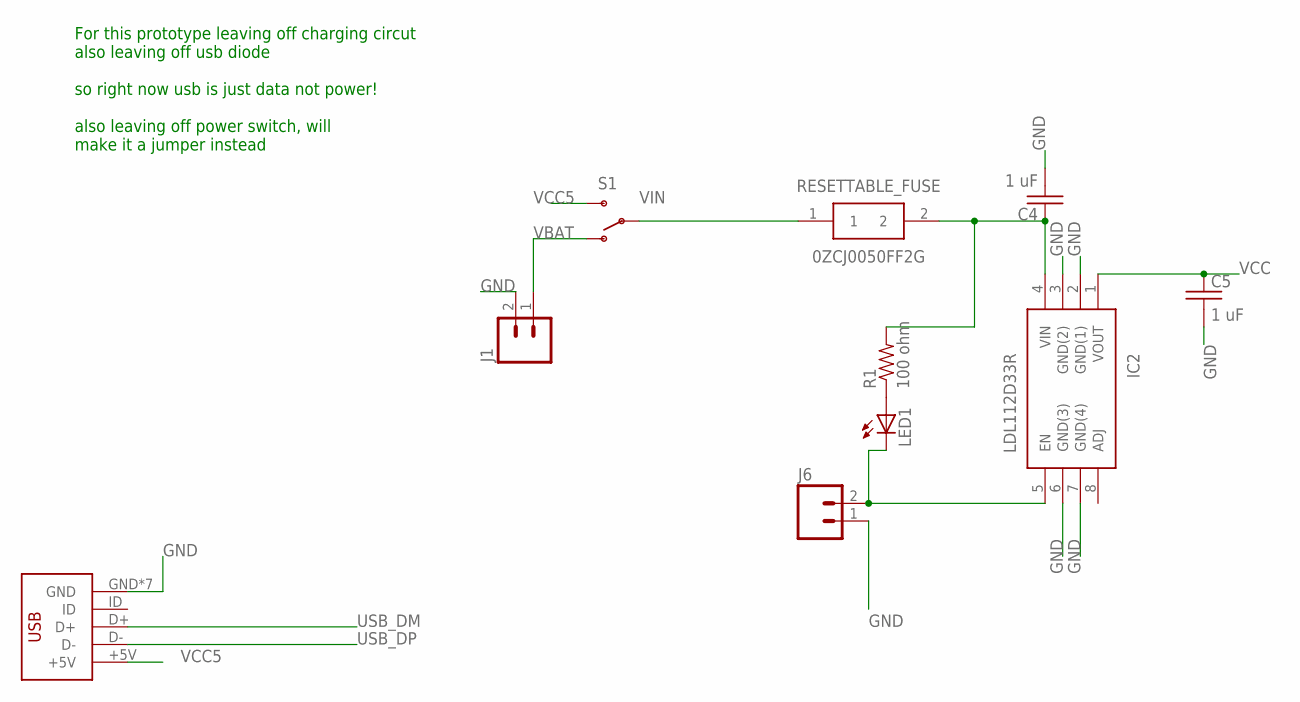
[picture p54: schematic ft2232h-breakout-with-ground-planesch.sch, sheet 2]

Parts:
C4, C5: 1 uF; C0805
IC2: LDL112D33R; SOIC127P600X175-8N
J1, J6: M02PTH; 1X02
LED1: LED3MM
R1: 100 ohm; AXIAL-0.3-KIT
RESETTABLE_FUSE: 0ZCJ0050FF2G; FUSC3216X55N
S1: SWITCH-SPSTPTH; SWITCH-SPDT
U$2: DX4R005JJ2DX4R005JJ2; DX4R005JJ2

Connections:
GND: C4.2, C5.2, IC2.2 (GND(1)), IC2.3 (GND(2)), IC2.6 (GND(3)), IC2.7 (GND(4)), J1.2, J6.1, U$2.GND, U$2.P$6 (GND), U$2.P$7 (GND), U$2.P$8 (GND), U$2.P$9 (GND), U$2.P$10 (GND), U$2.P$11 (GND); also elsewhere on the board
unnamed: LED1.A, R1.P$1 (1)
unnamed: C4.1, IC2.4 (VIN), R1.P$2 (2), RESETTABLE_FUSE.2
unnamed: IC2.5 (EN), J6.2, LED1.K (C)
USB_DM: U$2.D+; also elsewhere on the board
USB_DP: U$2.D-; also elsewhere on the board
VBAT: J1.1, S1.1 (O)
VCC: C5.1, IC2.1 (VOUT); also elsewhere on the board
VCC5: S1.3 (S), U$2.+5V
VIN: RESETTABLE_FUSE.1, S1.2

Notes on the sheet:
For this prototype leaving off charging circut also leaving off usb diode so right now usb is just data not power! also leaving off power switch, will make it a jumper instead

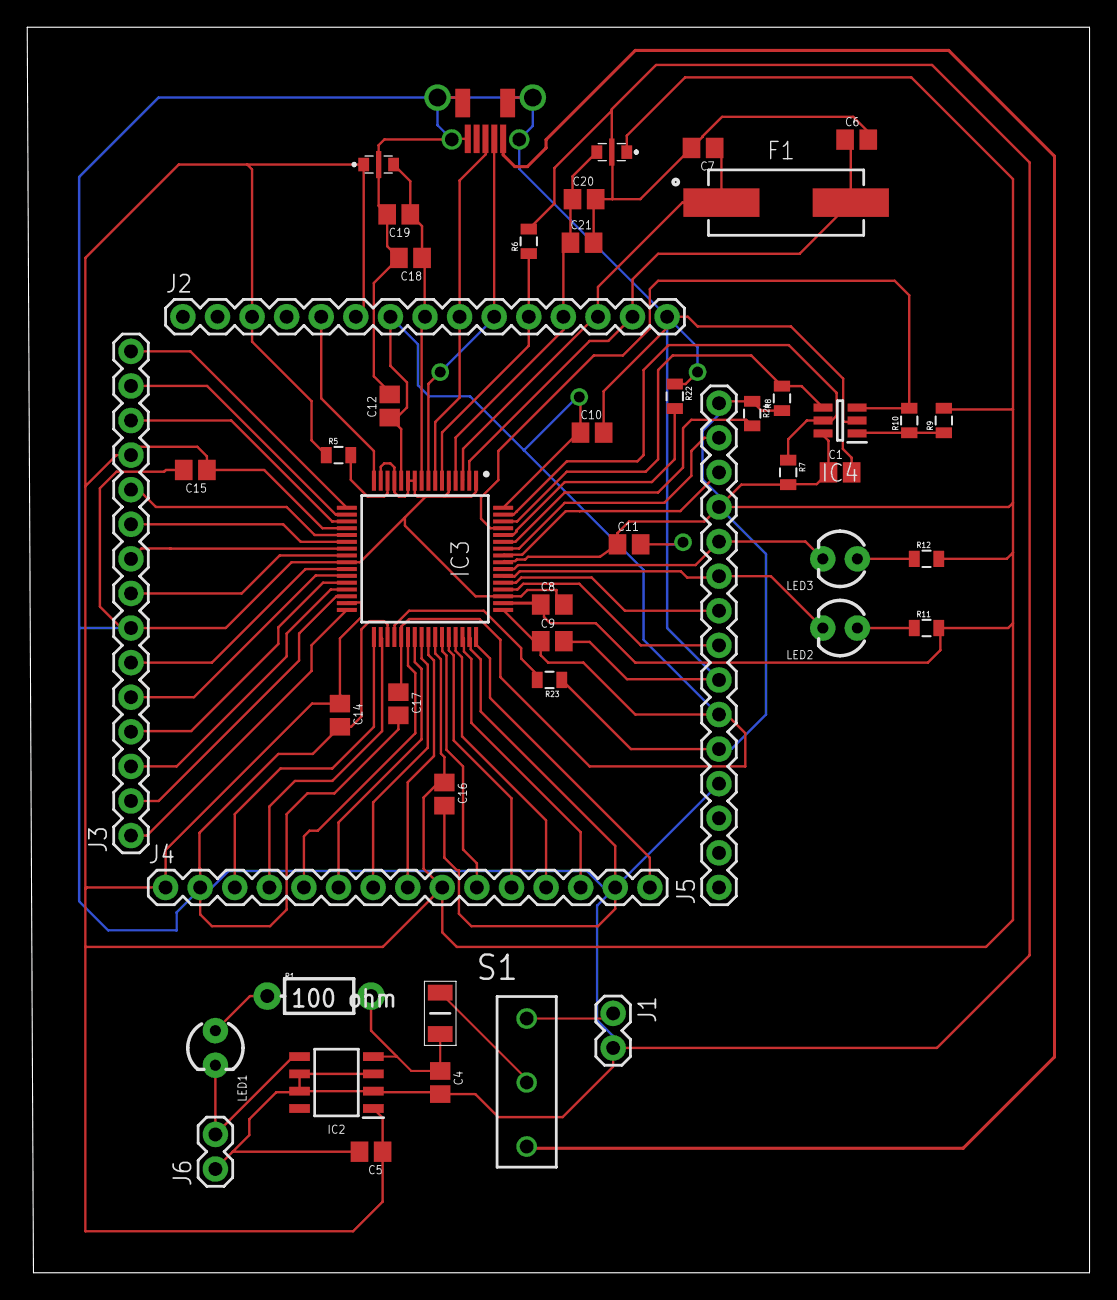
[picture p55: board ft2232h-breakout-with-ground-planesch.brd from above]

Board: 2 copper layers, 78.0 x 91.5 mm, 48 parts (0 on the bottom side), 57 nets.
