thedarknet/darknet8-badge/Prototype1/hardware/prototype1/prototype1-ftdi-as-breakout.brd

## EAGLE design Prototype1/hardware/prototype1/prototype1-ftdi-as-breakout.brd (2019-01-21, an earlier design)

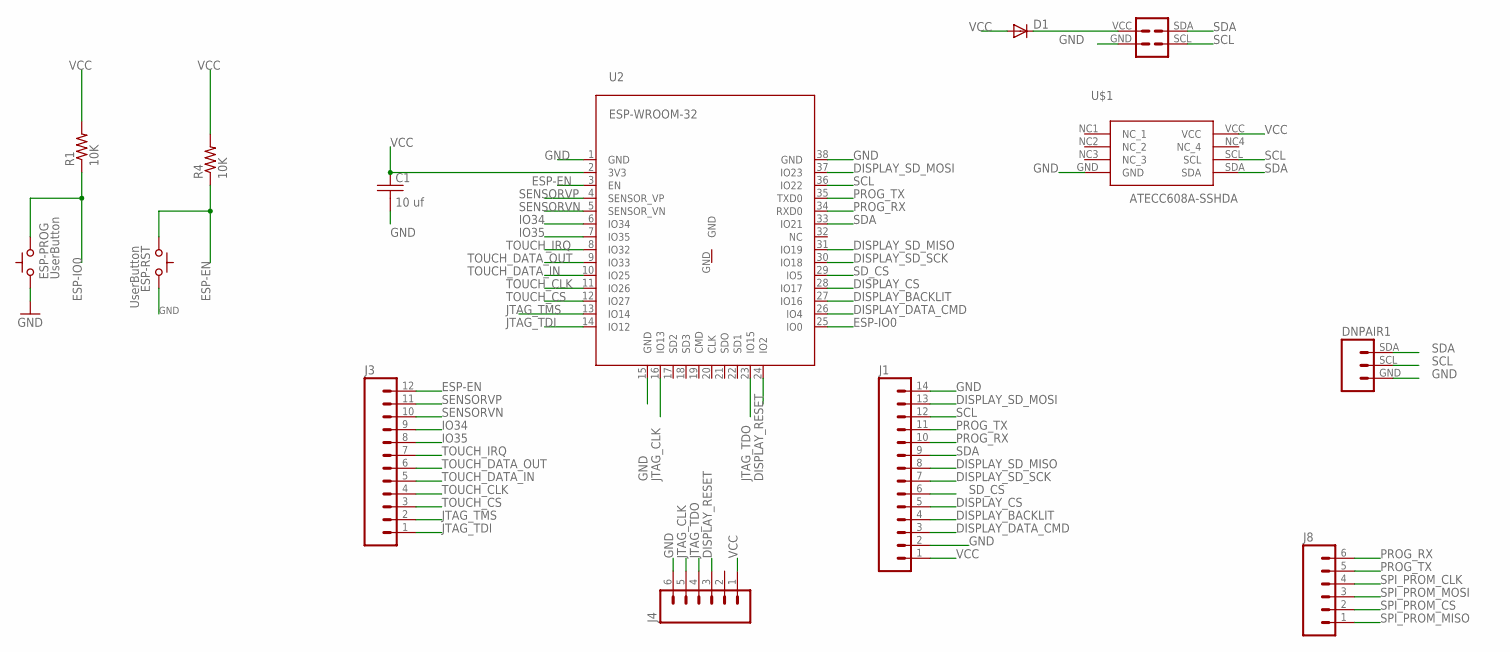
[picture p56: schematic prototype1-ftdi-as-breakout.sch, sheet 1]

Parts:
C1: 10 uf; C0805
D1: DIODESMA; SMA-DIODE
DNPAIR1: DARKNET_8_PAIR_CONNECTORPTH; 1X03
ESP-PROG: UserButton; TACTILE-2PIN-NARROW
ESP-RST: UserButton; TACTILE-2PIN-NARROW
J1: M14; 1X14
J3: M12PTH; 1X12
J4, J8: M06SILK_FEMALE_PTH; 1X06
R1, R4: 10K; 0805
SHITTY_ADDON: SAO1; DC26SHITTY_ADDON_CONNECTOR
U2: ESP-WROOM-32
U$1: ATECC608A-SSHDA; 8-SOIC

Connections:
DISPLAY_BACKLIT: J1.4, U2.27 (IO16)
DISPLAY_CS: J1.5, U2.28 (IO17)
DISPLAY_DATA_CMD: J1.3, U2.26 (IO4)
DISPLAY_RESET: J4.3, U2.24 (IO2)
DISPLAY_SD_MISO: J1.8, U2.31 (IO19)
DISPLAY_SD_MOSI: J1.13, U2.37 (IO23)
DISPLAY_SD_SCK: J1.7, U2.30 (IO18)
ESP-EN: ESP-RST.P$2 (C), J3.12, R4.1, U2.3 (EN)
ESP-IO0: ESP-PROG.P$1 (A), R1.1, U2.25 (IO0)
GND: C1.2, DNPAIR1.GND, ESP-PROG.P$2 (C), ESP-RST.P$1 (A), J1.2, J1.14, J4.6, SHITTY_ADDON.GND, U2.1 (GND), U2.15 (GND), U2.38 (GND), U$1.GND; also elsewhere on the board
IO34: J3.9, U2.6 (IO34)
IO35: J3.8, U2.7 (IO35)
JTAG_CLK: J4.5, U2.16 (IO13)
JTAG_TDI: J3.1, U2.14 (IO12)
JTAG_TDO: J4.4, U2.23 (IO15)
JTAG_TMS: J3.2, U2.13 (IO14)
unnamed: D1.C, SHITTY_ADDON.VCC
PROG_RX: J1.10, J8.6, U2.34 (RXD0)
PROG_TX: J1.11, J8.5, U2.35 (TXD0)
SCL: DNPAIR1.SCL, J1.12, SHITTY_ADDON.SCL, U2.36 (IO22), U$1.SCL
SDA: DNPAIR1.SDA, J1.9, SHITTY_ADDON.SDA, U2.33 (IO21), U$1.SDA
SD_CS: J1.6, U2.29 (IO5)
SENSORVN: J3.10, U2.5 (SENSOR_VN)
SENSORVP: J3.11, U2.4 (SENSOR_VP)
SPI_PROM_CLK: J8.4; also elsewhere on the board
SPI_PROM_CS: J8.2; also elsewhere on the board
SPI_PROM_MISO: J8.1; also elsewhere on the board
SPI_PROM_MOSI: J8.3; also elsewhere on the board
TOUCH_CLK: J3.4, U2.11 (IO26)
TOUCH_CS: J3.3, U2.12 (IO27)
TOUCH_DATA_IN: J3.5, U2.10 (IO25)
TOUCH_DATA_OUT: J3.6, U2.9 (IO33)
TOUCH_IRQ: J3.7, U2.8 (IO32)
VCC: C1.1, D1.A, J1.1, J4.1, R1.2, R4.2, U2.2 (3V3), U$1.VCC; also elsewhere on the board

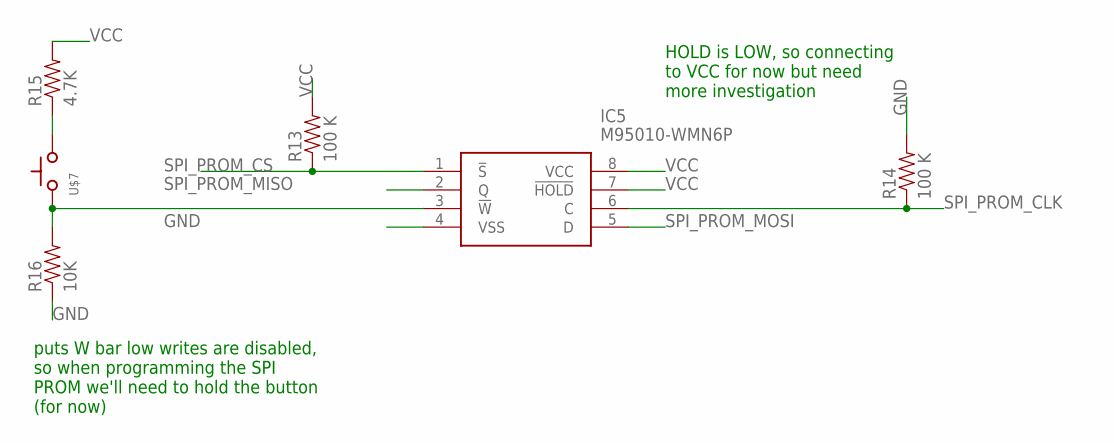
[picture p57: schematic prototype1-ftdi-as-breakout.sch, sheet 2]

Parts:
IC5: M95010-WMN6P; SOIC127P600X175-8N
R13, R14: 100 K; 0805
R15: 4.7K; 0805
R16: 10K; 0805
U$7: SWITCH_TACTILETACTILE-2PIN-NARROW; TACTILE-2PIN-NARROW

Connections:
GND: IC5.4 (VSS), R14.2, R16.1; also elsewhere on the board
unnamed: IC5.3 (!W), R16.2, U$7.P$2 (C)
unnamed: R15.1, U$7.P$1 (A)
SPI_PROM_CLK: IC5.6 (C), R14.1; also elsewhere on the board
SPI_PROM_CS: IC5.1 (!S), R13.1; also elsewhere on the board
SPI_PROM_MISO: IC5.2 (Q); also elsewhere on the board
SPI_PROM_MOSI: IC5.5 (D); also elsewhere on the board
VCC: IC5.7 (!HOLD), IC5.8 (VCC), R13.2, R15.2; also elsewhere on the board

Notes on the sheet:
HOLD is LOW, so connecting to VCC for now but need more investigation
puts W bar low writes are disabled, so when programming the SPI PROM we'll need to hold the button (for now)

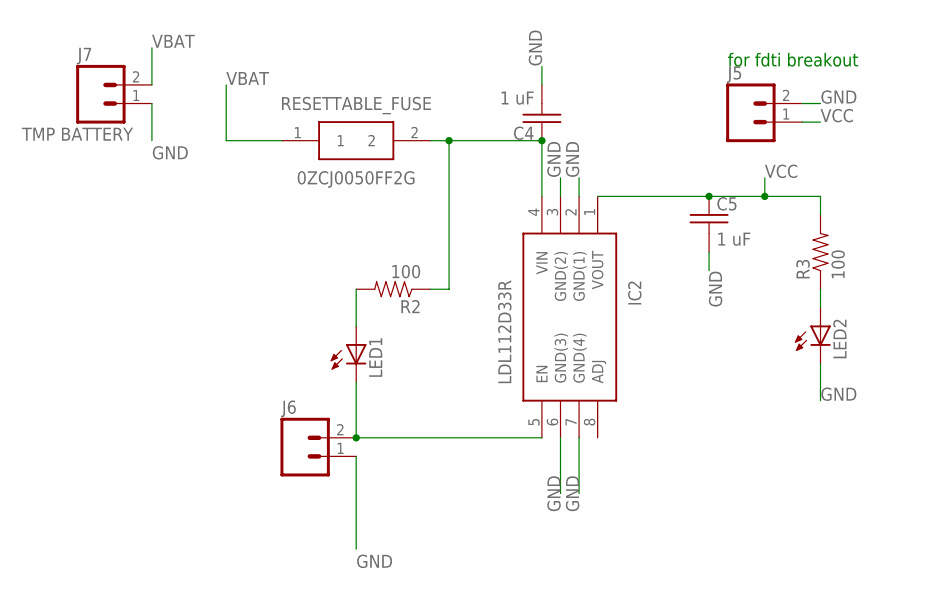
[picture p58: schematic prototype1-ftdi-as-breakout.sch, sheet 3]

Parts:
C4, C5: 1 uF; C0805
IC2: LDL112D33R; SOIC127P600X175-8N
J5, J6: M02PTH; 1X02
J7: TMP BATTERY; 1X02
LED1, LED2: LED3MM
R2, R3: 100; 0805
RESETTABLE_FUSE: 0ZCJ0050FF2G; FUSC3216X55N

Connections:
GND: C4.2, C5.2, IC2.2 (GND(1)), IC2.3 (GND(2)), IC2.6 (GND(3)), IC2.7 (GND(4)), J5.2, J6.1, J7.1, LED2.K (C); also elsewhere on the board
unnamed: C4.1, IC2.4 (VIN), R2.1, RESETTABLE_FUSE.2
unnamed: LED1.A, R2.2
unnamed: LED2.A, R3.1
unnamed: IC2.5 (EN), J6.2, LED1.K (C)
VBAT: J7.2, RESETTABLE_FUSE.1
VCC: C5.1, IC2.1 (VOUT), J5.1, R3.2; also elsewhere on the board

Notes on the sheet:
for fdti breakout


Parts:
U$2: CMD_C0DE_LOGOCMD_CODE_LOGO_TOP_COPPER; CMD_C0DE_LOGO_TOP_COPPER

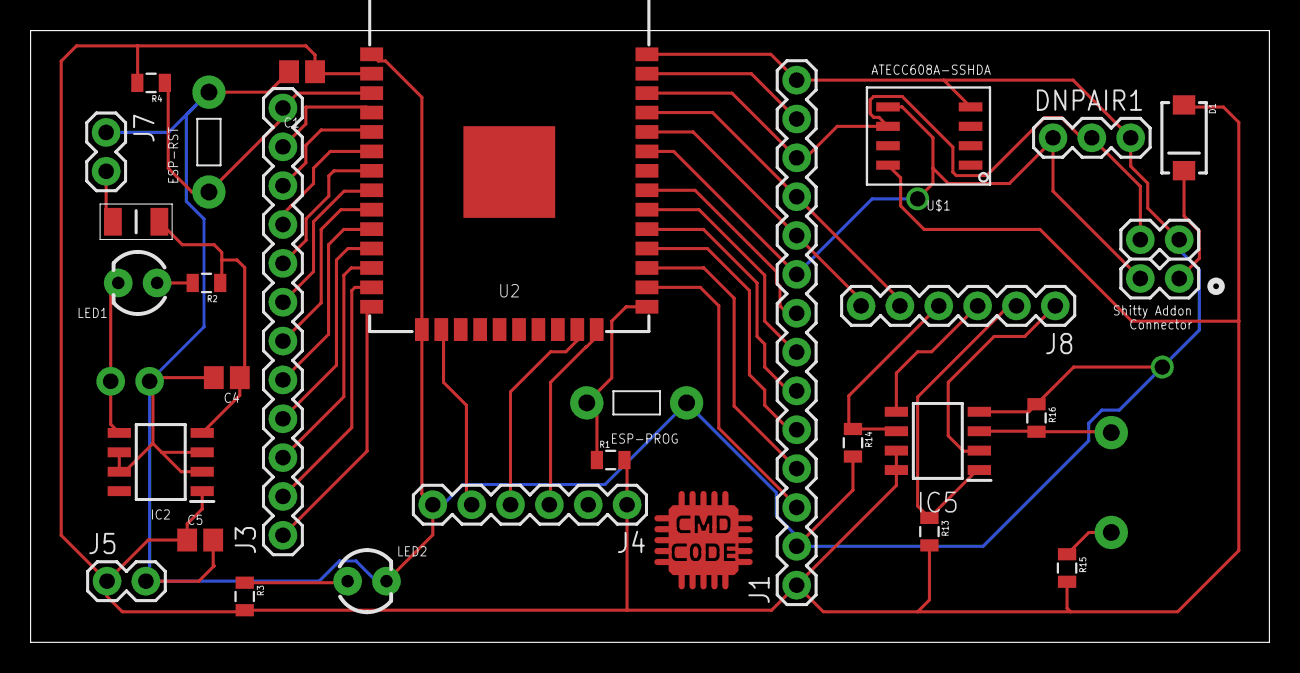
[picture p59: board prototype1-ftdi-as-breakout.brd from above]

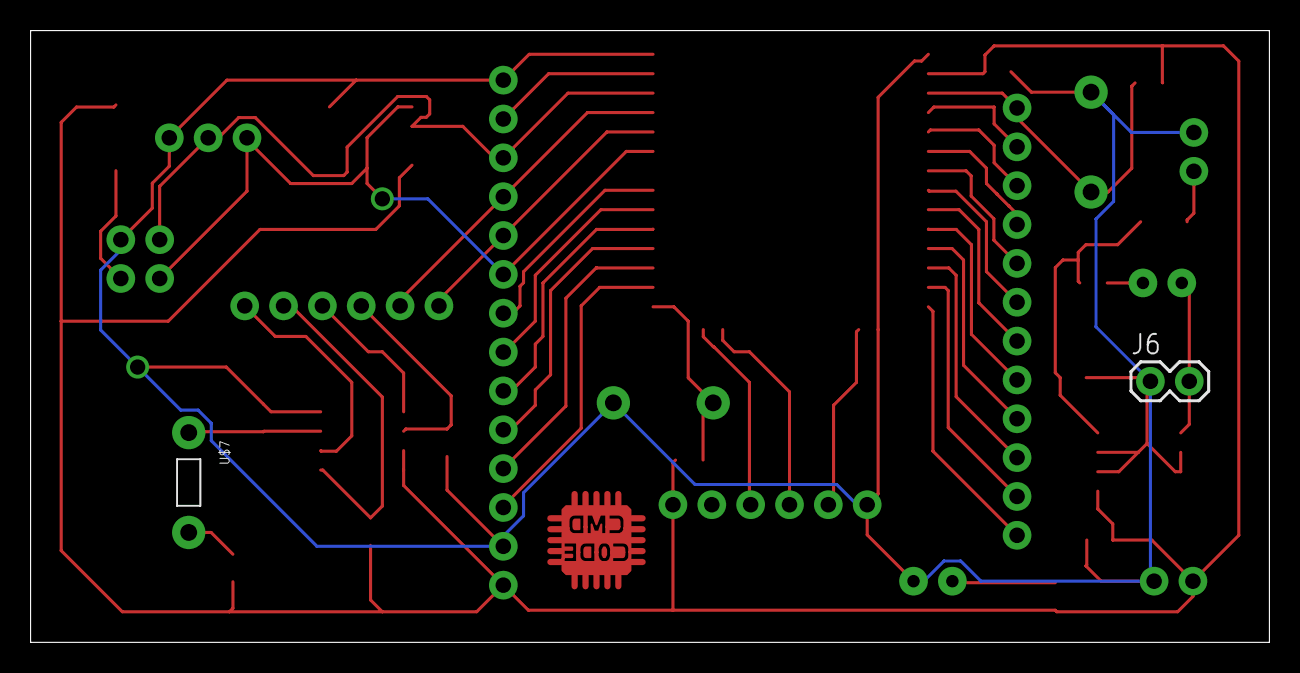
[picture p60: board prototype1-ftdi-as-breakout.brd from below]

Board: 2 copper layers, 81.0 x 40.0 mm, 32 parts (2 on the bottom side), 41 nets.
