thedarknet/darknet8-badge/Prototype1/hardware/prototype1/prototype1-with-charging-circut.brd

## EAGLE design Prototype1/hardware/prototype1/prototype1-with-charging-circut.brd (2019-01-07, an earlier design)

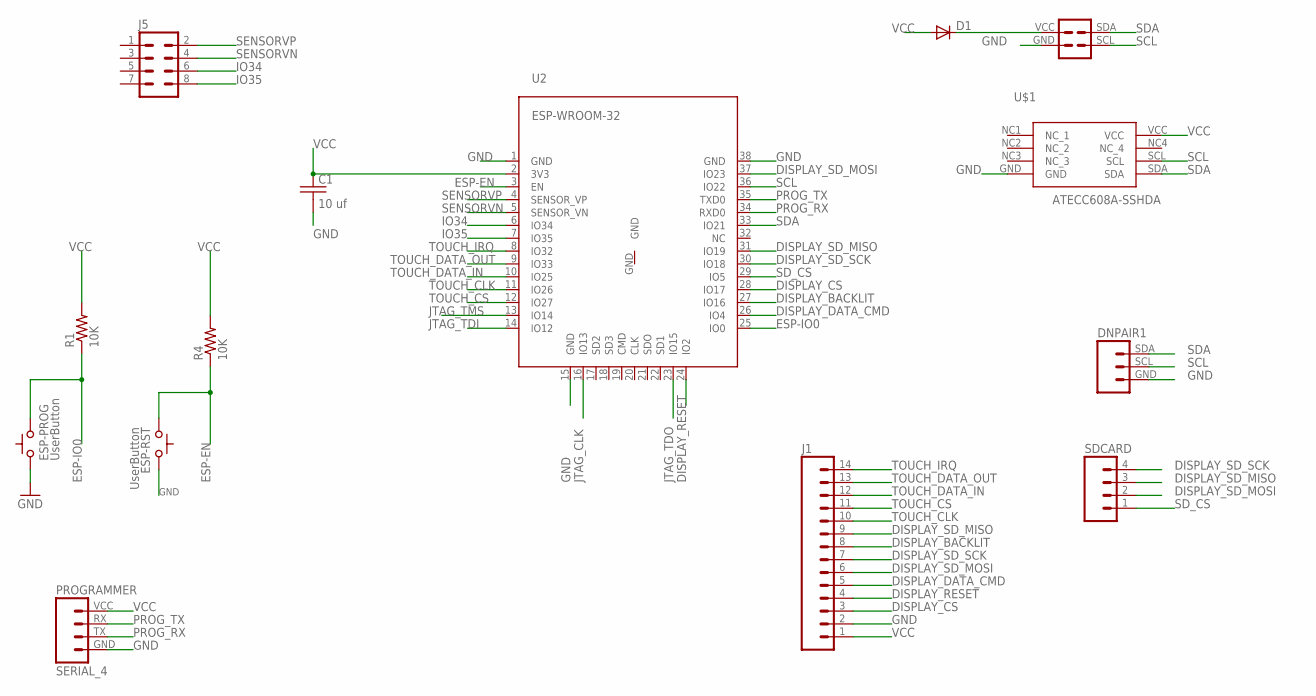
[picture p61: schematic prototype1-with-charging-circut.sch, sheet 1]

Parts:
C1: 10 uf; C0805
D1: DIODESMA; SMA-DIODE
DNPAIR1: DARKNET_8_PAIR_CONNECTORPTH; 1X03
ESP-PROG: UserButton; TACTILE-2PIN-NARROW
ESP-RST: UserButton; TACTILE-2PIN-NARROW
J1: M14; 1X14
J5: M04X2; 2X4
PROGRAMMER: SERIAL_4; SERIAL_HEADER_4
R1, R4: 10K; 0805
SDCARD: M04PTH; 1X04
SHITTY_ADDON: SAO1; DC26SHITTY_ADDON_CONNECTOR
U2: ESP-WROOM-32
U$1: ATECC608A-SSHDA; 8-SOIC

Connections:
DISPLAY_BACKLIT: J1.8, U2.27 (IO16)
DISPLAY_CS: J1.3, U2.28 (IO17)
DISPLAY_DATA_CMD: J1.5, U2.26 (IO4)
DISPLAY_RESET: J1.4, U2.24 (IO2)
DISPLAY_SD_MISO: J1.9, SDCARD.3, U2.31 (IO19)
DISPLAY_SD_MOSI: J1.6, SDCARD.2, U2.37 (IO23)
DISPLAY_SD_SCK: J1.7, SDCARD.4, U2.30 (IO18)
ESP-EN: ESP-RST.P$2 (C), R4.1, U2.3 (EN)
ESP-IO0: ESP-PROG.P$1 (A), R1.1, U2.25 (IO0)
GND: C1.2, DNPAIR1.GND, ESP-PROG.P$2 (C), ESP-RST.P$1 (A), J1.2, PROGRAMMER.GND, SHITTY_ADDON.GND, U2.1 (GND), U2.15 (GND), U2.38 (GND), U$1.GND; also elsewhere on the board
IO34: J5.6, U2.6 (IO34)
IO35: J5.8, U2.7 (IO35)
JTAG_CLK: U2.16 (IO13); also elsewhere on the board
JTAG_TDI: U2.14 (IO12); also elsewhere on the board
JTAG_TDO: U2.23 (IO15); also elsewhere on the board
JTAG_TMS: U2.13 (IO14); also elsewhere on the board
unnamed: D1.C, SHITTY_ADDON.VCC
PROG_RX: PROGRAMMER.TX, U2.34 (RXD0); also elsewhere on the board
PROG_TX: PROGRAMMER.RX, U2.35 (TXD0); also elsewhere on the board
SCL: DNPAIR1.SCL, SHITTY_ADDON.SCL, U2.36 (IO22), U$1.SCL
SDA: DNPAIR1.SDA, SHITTY_ADDON.SDA, U2.33 (IO21), U$1.SDA
SD_CS: SDCARD.1, U2.29 (IO5)
SENSORVN: J5.4, U2.5 (SENSOR_VN)
SENSORVP: J5.2, U2.4 (SENSOR_VP)
TOUCH_CLK: J1.10, U2.11 (IO26)
TOUCH_CS: J1.11, U2.12 (IO27)
TOUCH_DATA_IN: J1.12, U2.10 (IO25)
TOUCH_DATA_OUT: J1.13, U2.9 (IO33)
TOUCH_IRQ: J1.14, U2.8 (IO32)
VCC: C1.1, D1.A, J1.1, PROGRAMMER.VCC, R1.2, R4.2, U2.2 (3V3), U$1.VCC; also elsewhere on the board

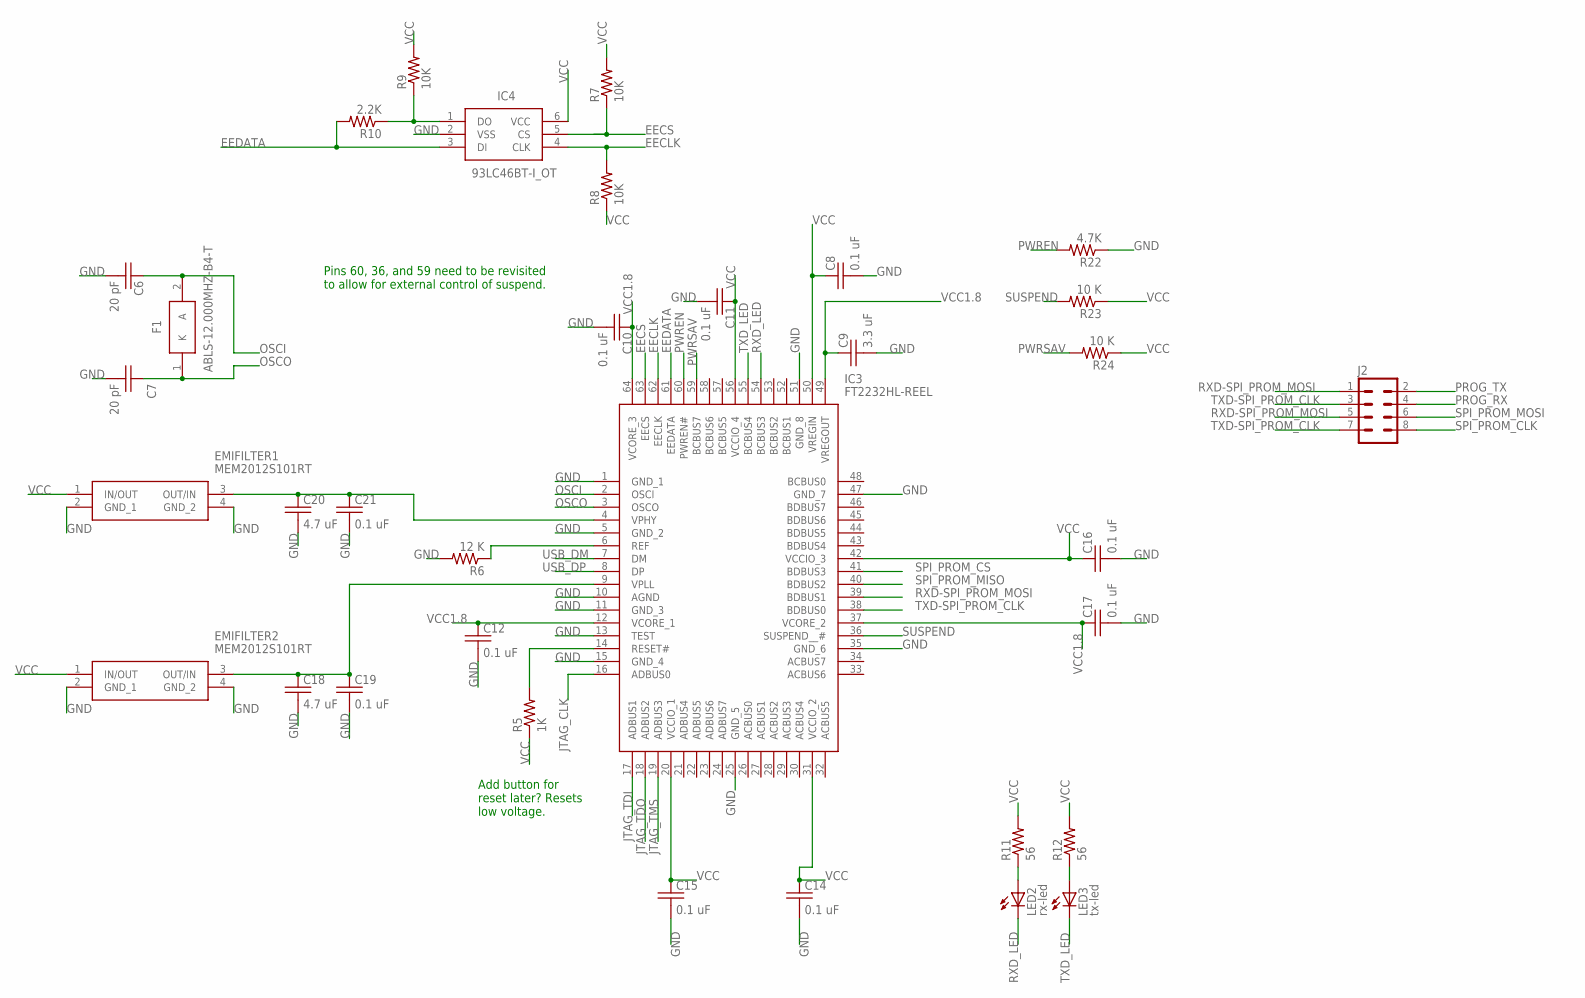
[picture p62: schematic prototype1-with-charging-circut.sch, sheet 2]

Parts:
C6, C7: 20 pF; C0805
C8, C10, C11, C12, C14, C15, C16, C17, C19, C21: 0.1 uF; C0805
C9: 3.3 uF; C0805
C18, C20: 4.7 uF; C0805
EMIFILTER1, EMIFILTER2: MEM2012S101RT
F1: ABLS-12.000MHZ-B4-T; HC/49US-(AT49)_1
IC3: FT2232HL-REEL; QFP50P1200X1200X160-64N
IC4: 93LC46BT-I_OT; SOT95P270X145-6N
J2: M04X2; 2X4
LED2: rx-led; LED3MM
LED3: tx-led; LED3MM
R5: 1K; 0805
R6: 12 K; 0805
R7, R8, R9: 10K; 0805
R10: 2.2K; 0805
R11, R12: 56; 0805
R22: 4.7K; 0805
R23, R24: 10 K; 0805

Connections:
EECLK: IC3.62 (EECLK), IC4.4 (CLK), R8.2
EECS: IC3.63 (EECS), IC4.5 (CS), R7.1
EEDATA: IC3.61 (EEDATA), IC4.3 (DI), R10.2
GND: C6.2, C7.2, C8.2, C9.2, C10.2, C11.2, C12.2, C14.2, C15.2, C16.2, C17.2, C18.2, C19.2, C20.2, C21.2, EMIFILTER1.2 (GND_1), EMIFILTER1.4 (GND_2), EMIFILTER2.2 (GND_1), EMIFILTER2.4 (GND_2), IC3.1 (GND_1), IC3.5 (GND_2), IC3.10 (AGND), IC3.11 (GND_3), IC3.13 (TEST), IC3.15 (GND_4), IC3.25 (GND_5), IC3.35 (GND_6), IC3.47 (GND_7), IC3.51 (GND_8), IC4.2 (VSS), R6.2, R22.1; also elsewhere on the board
JTAG_CLK: IC3.16 (ADBUS0); also elsewhere on the board
JTAG_TDI: IC3.17 (ADBUS1); also elsewhere on the board
JTAG_TDO: IC3.18 (ADBUS2); also elsewhere on the board
JTAG_TMS: IC3.19 (ADBUS3); also elsewhere on the board
unnamed: IC3.14 (RESET#), R5.2
unnamed: IC3.6 (REF), R6.1
unnamed: IC4.1 (DO), R9.1, R10.1
unnamed: LED2.A, R11.1
unnamed: LED3.A, R12.1
unnamed: C18.1, C19.1, EMIFILTER2.3 (OUT/IN), IC3.9 (VPLL)
unnamed: C20.1, C21.1, EMIFILTER1.3 (OUT/IN), IC3.4 (VPHY)
OSCI: C6.1, F1.2 (A), IC3.2 (OSCI)
OSCO: C7.1, F1.1 (K), IC3.3 (OSCO)
PROG_RX: J2.4; also elsewhere on the board
PROG_TX: J2.2; also elsewhere on the board
PWREN: IC3.60 (PWREN#), R22.2
PWRSAV: IC3.59 (BCBUS7), R24.2
RXD-SPI_PROM_MOSI: IC3.39 (BDBUS1), J2.1, J2.5
RXD_LED: IC3.54 (BCBUS3), LED2.K (C)
SPI_PROM_CLK: J2.8; also elsewhere on the board
SPI_PROM_CS: IC3.41 (BDBUS3); also elsewhere on the board
SPI_PROM_MISO: IC3.40 (BDBUS2); also elsewhere on the board
SPI_PROM_MOSI: J2.6; also elsewhere on the board
SUSPEND: IC3.36 (SUSPEND__#), R23.2
TXD-SPI_PROM_CLK: IC3.38 (BDBUS0), J2.3, J2.7
TXD_LED: IC3.55 (BCBUS4), LED3.K (C)
USB_DM: IC3.7 (DM); also elsewhere on the board
USB_DP: IC3.8 (DP); also elsewhere on the board
VCC: C8.1, C11.1, C14.1, C15.1, C16.1, EMIFILTER1.1 (IN/OUT), EMIFILTER2.1 (IN/OUT), IC3.20 (VCCIO_1), IC3.31 (VCCIO_2), IC3.42 (VCCIO_3), IC3.50 (VREGIN), IC3.56 (VCCIO_4), IC4.6 (VCC), R5.1, R7.2, R8.1, R9.2, R11.2, R12.2, R23.1, R24.1; also elsewhere on the board
VCC1.8: C9.1, C10.1, C12.1, C17.1, IC3.12 (VCORE_1), IC3.37 (VCORE_2), IC3.49 (VREGOUT), IC3.64 (VCORE_3)

Notes on the sheet:
Add button for reset later? Resets low voltage.
Pins 60, 36, and 59 need to be revisited to allow for external control of suspend.
