thedarknet/darknet8-badge/Prototype1/hardware/prototype1/prototype1-with-charging-circut.brd

## EAGLE design Prototype1/hardware/prototype1/prototype1-with-charging-circut.brd (continued)

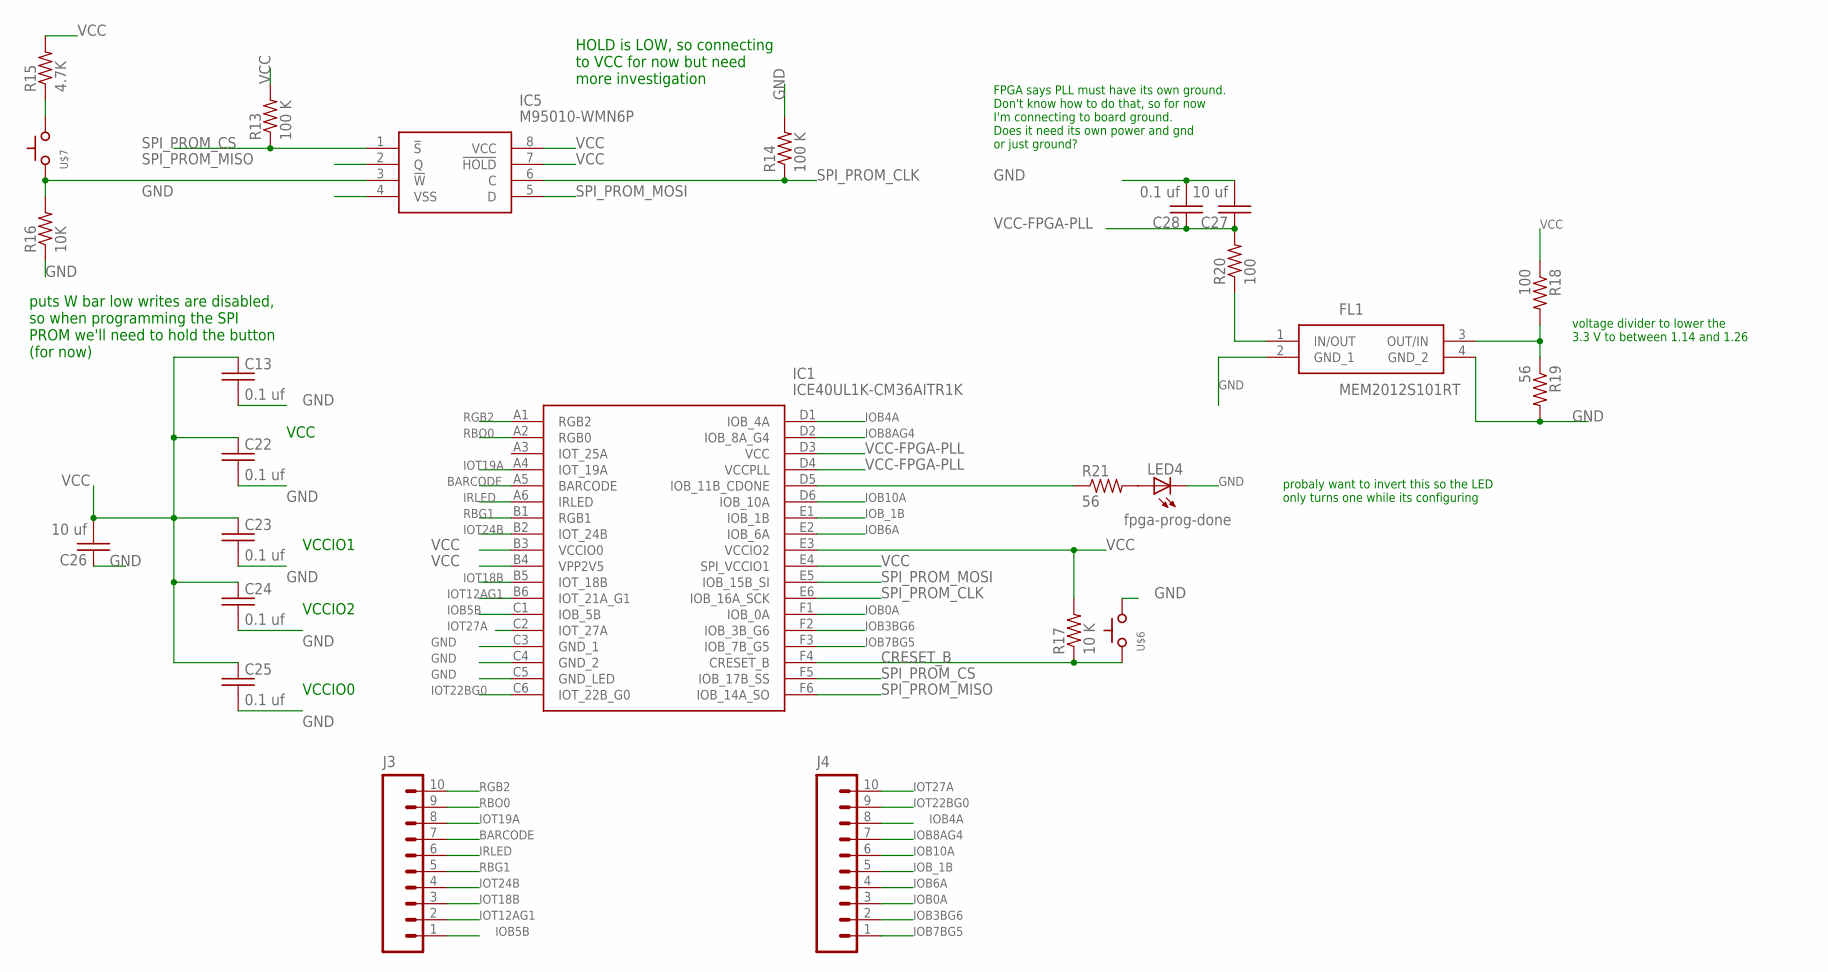
[picture p63: schematic prototype1-with-charging-circut.sch, sheet 3]

Parts:
C13, C22, C23, C24, C25, C28: 0.1 uf; C0805
C26, C27: 10 uf; C0805
FL1: MEM2012S101RT
IC1: ICE40UL1K-CM36AITR1K; BGA36C40P6X6_250X250X91
IC5: M95010-WMN6P; SOIC127P600X175-8N
J3, J4: M10SILK_FEMALE_PTH; 1X10
LED4: fpga-prog-done; LED3MM
R13, R14: 100 K; 0805
R15: 4.7K; 0805
R16: 10K; 0805
R17: 10 K; 0805
R18, R20: 100; 0805
R19, R21: 56; 0805
U$6, U$7: SWITCH_TACTILETACTILE-2PIN; TACTILE-2PIN

Connections:
BARCODE: IC1.A5 (BARCODE), J3.7
CRESET_B: IC1.F4 (CRESET_B), R17.1, U$6.P$2 (C)
GND: C13.2, C22.2, C23.2, C24.2, C25.2, C26.1, C27.2, C28.2, FL1.2 (GND_1), FL1.4 (GND_2), IC1.C3 (GND_1), IC1.C4 (GND_2), IC1.C5 (GND_LED), IC5.4 (VSS), LED4.K (C), R14.2, R16.1, R19.2, U$6.P$1 (A); also elsewhere on the board
IOB0A: IC1.F1 (IOB_0A), J4.3
IOB3BG6: IC1.F2 (IOB_3B_G6), J4.2
IOB4A: IC1.D1 (IOB_4A), J4.8
IOB5B: IC1.C1 (IOB_5B), J3.1
IOB6A: IC1.E2 (IOB_6A), J4.4
IOB7BG5: IC1.F3 (IOB_7B_G5), J4.1
IOB8AG4: IC1.D2 (IOB_8A_G4), J4.7
IOB10A: IC1.D6 (IOB_10A), J4.6
IOB_1B: IC1.E1 (IOB_1B), J4.5
IOT12AG1: IC1.B6 (IOT_21A_G1), J3.2
IOT18B: IC1.B5 (IOT_18B), J3.3
IOT19A: IC1.A4 (IOT_19A), J3.8
IOT22BG0: IC1.C6 (IOT_22B_G0), J4.9
IOT24B: IC1.B2 (IOT_24B), J3.4
IOT27A: IC1.C2 (IOT_27A), J4.10
IRLED: IC1.A6 (IRLED), J3.6
unnamed: IC5.3 (!W), R16.2, U$7.P$2 (C)
unnamed: R15.1, U$7.P$1 (A)
unnamed: LED4.A, R21.2
unnamed: FL1.3 (OUT/IN), R18.2, R19.1
unnamed: FL1.1 (IN/OUT), R20.1
unnamed: IC1.D5 (IOB_11B_CDONE), R21.1
RBG1: IC1.B1 (RGB1), J3.5
RBO0: IC1.A2 (RGB0), J3.9
RGB2: IC1.A1 (RGB2), J3.10
SPI_PROM_CLK: IC1.E6 (IOB_16A_SCK), IC5.6 (C), R14.1; also elsewhere on the board
SPI_PROM_CS: IC1.F5 (IOB_17B_SS), IC5.1 (!S), R13.1; also elsewhere on the board
SPI_PROM_MISO: IC1.F6 (IOB_14A_SO), IC5.2 (Q); also elsewhere on the board
SPI_PROM_MOSI: IC1.E5 (IOB_15B_SI), IC5.5 (D); also elsewhere on the board
VCC: C13.1, C22.1, C23.1, C24.1, C25.1, C26.2, IC1.B3 (VCCIO0), IC1.B4 (VPP2V5), IC1.E3 (VCCIO2), IC1.E4 (SPI_VCCIO1), IC5.7 (!HOLD), IC5.8 (VCC), R13.2, R15.2, R17.2, R18.1; also elsewhere on the board
VCC-FPGA-PLL: C27.1, C28.1, IC1.D3 (VCC), IC1.D4 (VCCPLL), R20.2

Notes on the sheet:
HOLD is LOW, so connecting to VCC for now but need more investigation
puts W bar low writes are disabled, so when programming the SPI PROM we'll need to hold the button (for now)
voltage divider to lower the 3.3 V to between 1.14 and 1.26
VCC
VCCIO1
VCCIO2
VCCIO0
FPGA says PLL must have its own ground. Don't know how to do that, so for now I'm connecting to board ground. Does it need its own power and gnd or just ground?
probaly want to invert this so the LED only turns one while its configuring

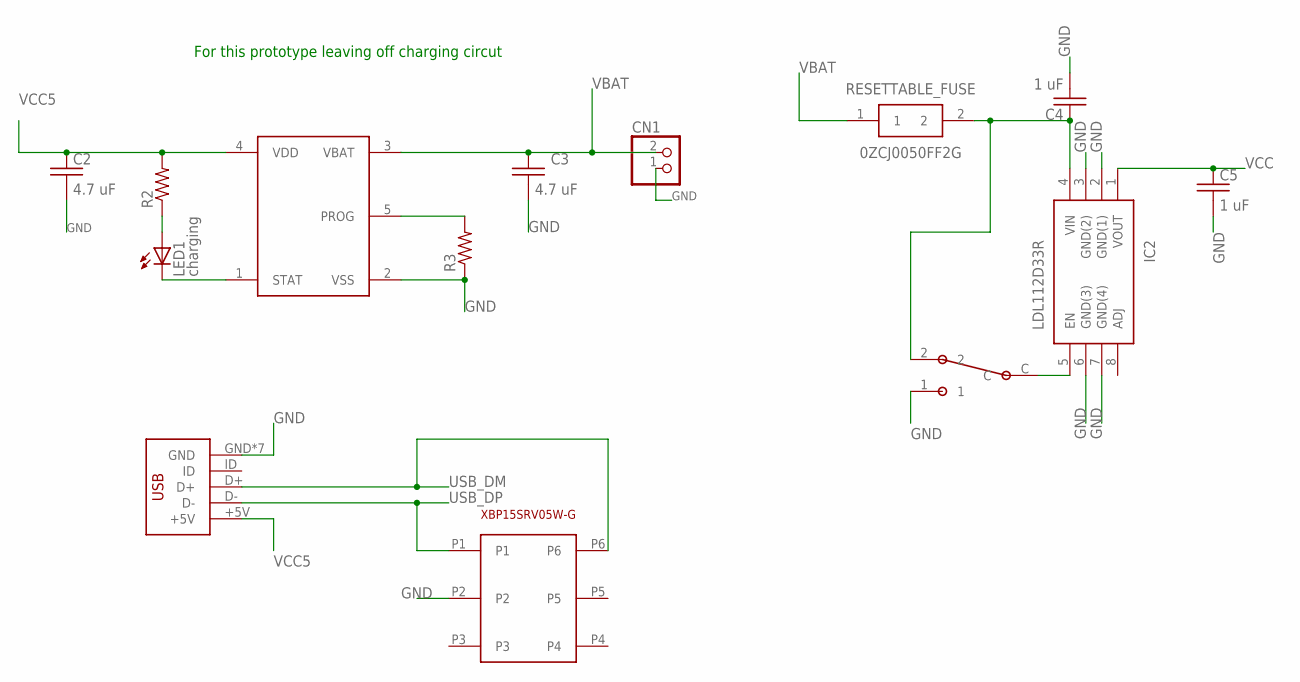
[picture p64: schematic prototype1-with-charging-circut.sch, sheet 4]

Parts:
C2, C3: 4.7 uF; C0805
C4, C5: 1 uF; C0805
CN1: JST_2PIN-THM-RA; JST-PH-2-THM-RA
IC2: LDL112D33R; SOIC127P600X175-8N
LED1: charging; LED-0603
R2, R3: RESISTOR0805-RES; 0805
RESETTABLE_FUSE: 0ZCJ0050FF2G; FUSC3216X55N
U$2: DX4R005JJ2DX4R005JJ2; DX4R005JJ2
U$3: XBP15SRV05W-G; SOT-26P-XBP15SRV05W-G
U$4: DS21984E; SOT23-5
U$5: SWITCH_SPDT; SPDT_SSAJ120100

Connections:
GND: C2.2, C3.2, C4.2, C5.2, CN1.1 (2), IC2.2 (GND(1)), IC2.3 (GND(2)), IC2.6 (GND(3)), IC2.7 (GND(4)), R3.1, U$2.GND, U$2.P$6 (GND), U$2.P$7 (GND), U$2.P$8 (GND), U$2.P$9 (GND), U$2.P$10 (GND), U$2.P$11 (GND), U$3.P2, U$4.2 (VSS), U$5.1; also elsewhere on the board
unnamed: LED1.A, R2.1
unnamed: LED1.C, U$4.1 (STAT)
unnamed: R3.2, U$4.5 (PROG)
unnamed: C4.1, IC2.4 (VIN), RESETTABLE_FUSE.2, U$5.2
unnamed: IC2.5 (EN), U$5.C
USB_DM: U$2.D+, U$3.P6; also elsewhere on the board
USB_DP: U$2.D-, U$3.P1; also elsewhere on the board
VBAT: C3.1, CN1.2 (1), RESETTABLE_FUSE.1, U$4.3 (VBAT)
VCC: C5.1, IC2.1 (VOUT); also elsewhere on the board
VCC5: C2.1, R2.2, U$2.+5V, U$4.4 (VDD)

Notes on the sheet:
For this prototype leaving off charging circut

Board: 2 copper layers, 87 parts (0 on the bottom side), 91 nets, no tracks yet.
