thedarknet/darknet8-badge/DC27/firmware/main/dc27.cpp

#include <stdio.h>
#include <stdlib.h>
#include <string.h>
#include "freertos/FreeRTOS.h"
#include "freertos/task.h"
#include "esp_system.h"
#include "driver/spi_master.h"
#include "soc/gpio_struct.h"

#include "system.h"
#include "i2c.hpp"
#include <esp_log.h>

#include "nvs_flash.h"

#include "app.h"

#include "wifi.h"

// This contains GPIO pin definitions for different kits
#include "devkit.h"

extern "C" {
	void app_main();
}

#define ESP_INTR_FLAG_DEFAULT 0

static void check_for_ota(void)
{
  int32_t doing_ota = 0;
  uint32_t nvsh = 0;
  QueueHandle_t nullhandle;
  nvs_open("nvs", NVS_READWRITE, &nvsh);
  nvs_get_i32(nvsh, "do_ota", &doing_ota);
  nvs_set_i32(nvsh, "do_ota", 0);
  if (doing_ota == 1)
  {
		initialize_ota_wifi();
		do_ota();
  }
}


void app_main() {
	static const char *LOGTAG="APP_MAIN";
	esp_err_t ret;
	
	// initialize NVS
	ret = nvs_flash_init();
	if (ret == ESP_ERR_NVS_NO_FREE_PAGES || ret == ESP_ERR_NVS_NEW_VERSION_FOUND) {
		ESP_ERROR_CHECK(nvs_flash_erase()); // TODO: do we actually want this?
		ret = nvs_flash_init();
	}
	ESP_ERROR_CHECK( ret );

	check_for_ota();

	gpio_install_isr_service(ESP_INTR_FLAG_DEFAULT);

	libesp::ErrorType et;
	et = DN8App::get().init();

	if(!et.ok()) {
		ESP_LOGE(LOGTAG,"init error: %s", et.toString());
	}


	//ESP32_I2CMaster::doIt();

	//ESP_LOGI(LOGTAG,"scan I2c1");
	//ESP32_I2CMaster I2c1(I2C_SCL2,I2C_SDA2,400000, I2C_NUM_1, 0, 16);
	//I2c1.init(false);
	//I2c1.scan();
	

	libesp::System::get().logSystemInfo();

   do {
		et = DN8App::get().run();
		//vTaskDelay(1 / portTICK_RATE_MS);
	} while (et.ok());
	vTaskDelay(3000 / portTICK_RATE_MS);
}
