thedarknet/darknet8-badge/DC27/top-board-firmware/DarkNet8-Top/DC27Top/src/driver_init.c

/**
 * \file
 *
 * \brief Driver initialization.
 *
 (c) 2018 Microchip Technology Inc. and its subsidiaries.

    Subject to your compliance with these terms,you may use this software and
    any derivatives exclusively with Microchip products.It is your responsibility
    to comply with third party license terms applicable to your use of third party
    software (including open source software) that may accompany Microchip software.

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
    IN NO EVENT WILL MICROCHIP BE LIABLE FOR ANY INDIRECT, SPECIAL, PUNITIVE,
    INCIDENTAL OR CONSEQUENTIAL LOSS, DAMAGE, COST OR EXPENSE OF ANY KIND
    WHATSOEVER RELATED TO THE SOFTWARE, HOWEVER CAUSED, EVEN IF MICROCHIP HAS
    BEEN ADVISED OF THE POSSIBILITY OR THE DAMAGES ARE FORESEEABLE. TO THE
    FULLEST EXTENT ALLOWED BY LAW, MICROCHIP'S TOTAL LIABILITY ON ALL CLAIMS IN
    ANY WAY RELATED TO THIS SOFTWARE WILL NOT EXCEED THE AMOUNT OF FEES, IF ANY,
    THAT YOU HAVE PAID DIRECTLY TO MICROCHIP FOR THIS SOFTWARE.
 *
 */

/*
 * Code generated by START.
 *
 * This file will be overwritten when reconfiguring your START project.
 * Please copy examples or other code you want to keep to a separate file
 * to avoid losing it when reconfiguring.
 */

#include "driver_init.h"
#include <system.h>

void PWM_0_initialization(void)
{

	// Set pin direction to output
	PA0_set_dir(PORT_DIR_OUT);

	PA0_set_level(
	    // <y> Initial level
	    // <id> pad_initial_level
	    // <false"> Low
	    // <true"> High
	    false);

	PWM_0_init();
}

/* configure pins and initialize registers */
void I2C_0_initialization(void)
{

	PA3_set_dir(
	    // <y> Pin direction
	    // <id> pad_dir
	    // <PORT_DIR_OFF"> Off
	    // <PORT_DIR_IN"> In
	    // <PORT_DIR_OUT"> Out
	    PORT_DIR_OUT);

	PA3_set_level(
	    // <y> Initial level
	    // <id> pad_initial_level
	    // <false"> Low
	    // <true"> High
	    false);

	PA3_set_pull_mode(
	    // <y> Pull configuration
	    // <id> pad_pull_config
	    // <PORT_PULL_OFF"> Off
	    // <PORT_PULL_UP"> Pull-up
	    PORT_PULL_OFF);

	PA3_set_inverted(
	    // <y> Invert I/O on pin
	    // <id> pad_invert
	    // <false"> Not inverted
	    // <true"> Inverted
	    false);

	PA3_set_isc(
	    // <y> Pin Input/Sense Configuration
	    // <id> pad_isc
	    // <PORT_ISC_INTDISABLE_gc"> Interrupt disabled but input buffer enabled
	    // <PORT_ISC_BOTHEDGES_gc"> Sense Both Edges
	    // <PORT_ISC_RISING_gc"> Sense Rising Edge
	    // <PORT_ISC_FALLING_gc"> Sense Falling Edge
	    // <PORT_ISC_INPUT_DISABLE_gc"> Digital Input Buffer disabled
	    // <PORT_ISC_LEVEL_gc"> Sense low Level
	    PORT_ISC_INTDISABLE_gc);

	PA2_set_dir(
	    // <y> Pin direction
	    // <id> pad_dir
	    // <PORT_DIR_OFF"> Off
	    // <PORT_DIR_IN"> In
	    // <PORT_DIR_OUT"> Out
	    PORT_DIR_OUT);

	PA2_set_level(
	    // <y> Initial level
	    // <id> pad_initial_level
	    // <false"> Low
	    // <true"> High
	    false);

	PA2_set_pull_mode(
	    // <y> Pull configuration
	    // <id> pad_pull_config
	    // <PORT_PULL_OFF"> Off
	    // <PORT_PULL_UP"> Pull-up
	    PORT_PULL_OFF);

	PA2_set_inverted(
	    // <y> Invert I/O on pin
	    // <id> pad_invert
	    // <false"> Not inverted
	    // <true"> Inverted
	    false);

	PA2_set_isc(
	    // <y> Pin Input/Sense Configuration
	    // <id> pad_isc
	    // <PORT_ISC_INTDISABLE_gc"> Interrupt disabled but input buffer enabled
	    // <PORT_ISC_BOTHEDGES_gc"> Sense Both Edges
	    // <PORT_ISC_RISING_gc"> Sense Rising Edge
	    // <PORT_ISC_FALLING_gc"> Sense Falling Edge
	    // <PORT_ISC_INPUT_DISABLE_gc"> Digital Input Buffer disabled
	    // <PORT_ISC_LEVEL_gc"> Sense low Level
	    PORT_ISC_INTDISABLE_gc);

	I2C_0_init();
}

/**
 * \brief System initialization
 */
void system_init()
{
	mcu_init();

	/* PORT setting on PA1 */

	// Set pin direction to output
	LED5_set_dir(PORT_DIR_OUT);

	LED5_set_level(
	    // <y> Initial level
	    // <id> pad_initial_level
	    // <false"> Low
	    // <true"> High
	    false);

	/* PORT setting on PA4 */

	// Set pin direction to output
	LED4_set_dir(PORT_DIR_OUT);

	LED4_set_level(
	    // <y> Initial level
	    // <id> pad_initial_level
	    // <false"> Low
	    // <true"> High
	    false);

	/* PORT setting on PA5 */

	// Set pin direction to output
	LED3_set_dir(PORT_DIR_OUT);

	LED3_set_level(
	    // <y> Initial level
	    // <id> pad_initial_level
	    // <false"> Low
	    // <true"> High
	    false);

	/* PORT setting on PA6 */

	// Set pin direction to output
	LED2_set_dir(PORT_DIR_OUT);

	LED2_set_level(
	    // <y> Initial level
	    // <id> pad_initial_level
	    // <false"> Low
	    // <true"> High
	    false);

	/* PORT setting on PA7 */

	// Set pin direction to output
	LED1_set_dir(PORT_DIR_OUT);

	LED1_set_level(
	    // <y> Initial level
	    // <id> pad_initial_level
	    // <false"> Low
	    // <true"> High
	    false);

	/* PORT setting on PC0 */

	// Set pin direction to output
	LED12_set_dir(PORT_DIR_OUT);

	LED12_set_level(
	    // <y> Initial level
	    // <id> pad_initial_level
	    // <false"> Low
	    // <true"> High
	    false);

	/* PORT setting on PC1 */

	// Set pin direction to output
	LED11_set_dir(PORT_DIR_OUT);

	LED11_set_level(
	    // <y> Initial level
	    // <id> pad_initial_level
	    // <false"> Low
	    // <true"> High
	    false);

	/* PORT setting on PC2 */

	// Set pin direction to output
	LED10_set_dir(PORT_DIR_OUT);

	LED10_set_level(
	    // <y> Initial level
	    // <id> pad_initial_level
	    // <false"> Low
	    // <true"> High
	    false);

	/* PORT setting on PC3 */

	// Set pin direction to output
	LED9_set_dir(PORT_DIR_OUT);

	LED9_set_level(
	    // <y> Initial level
	    // <id> pad_initial_level
	    // <false"> Low
	    // <true"> High
	    false);

	/* PORT setting on PC4 */

	// Set pin direction to output
	LED8_set_dir(PORT_DIR_OUT);

	LED8_set_level(
	    // <y> Initial level
	    // <id> pad_initial_level
	    // <false"> Low
	    // <true"> High
	    false);

	/* PORT setting on PD0 */

	// Set pin direction to output
	LED7_set_dir(PORT_DIR_OUT);

	LED7_set_level(
	    // <y> Initial level
	    // <id> pad_initial_level
	    // <false"> Low
	    // <true"> High
	    false);

	/* PORT setting on PD4 */

	// Set pin direction to output
	LED18_set_dir(PORT_DIR_OUT);

	LED18_set_level(
	    // <y> Initial level
	    // <id> pad_initial_level
	    // <false"> Low
	    // <true"> High
	    false);

	/* PORT setting on PD5 */

	// Set pin direction to output
	LED17_set_dir(PORT_DIR_OUT);

	LED17_set_level(
	    // <y> Initial level
	    // <id> pad_initial_level
	    // <false"> Low
	    // <true"> High
	    false);

	/* PORT setting on PD6 */

	// Set pin direction to output
	LED16_set_dir(PORT_DIR_OUT);

	LED16_set_level(
	    // <y> Initial level
	    // <id> pad_initial_level
	    // <false"> Low
	    // <true"> High
	    false);

	/* PORT setting on PD7 */

	// Set pin direction to output
	LED15_set_dir(PORT_DIR_OUT);

	LED15_set_level(
	    // <y> Initial level
	    // <id> pad_initial_level
	    // <false"> Low
	    // <true"> High
	    false);

	/* PORT setting on PE0 */

	// Set pin direction to output
	LED14_set_dir(PORT_DIR_OUT);

	LED14_set_level(
	    // <y> Initial level
	    // <id> pad_initial_level
	    // <false"> Low
	    // <true"> High
	    false);

	/* PORT setting on PE1 */

	// Set pin direction to output
	LED13_set_dir(PORT_DIR_OUT);

	LED13_set_level(
	    // <y> Initial level
	    // <id> pad_initial_level
	    // <false"> Low
	    // <true"> High
	    false);

	/* PORT setting on PE2 */

	// Set pin direction to output
	LED24_set_dir(PORT_DIR_OUT);

	LED24_set_level(
	    // <y> Initial level
	    // <id> pad_initial_level
	    // <false"> Low
	    // <true"> High
	    false);

	/* PORT setting on PE3 */

	// Set pin direction to output
	LED23_set_dir(PORT_DIR_OUT);

	LED23_set_level(
	    // <y> Initial level
	    // <id> pad_initial_level
	    // <false"> Low
	    // <true"> High
	    false);

	/* PORT setting on PF0 */

	// Set pin direction to output
	LED22_set_dir(PORT_DIR_OUT);

	LED22_set_level(
	    // <y> Initial level
	    // <id> pad_initial_level
	    // <false"> Low
	    // <true"> High
	    false);

	/* PORT setting on PF1 */

	// Set pin direction to output
	LED21_set_dir(PORT_DIR_OUT);

	LED21_set_level(
	    // <y> Initial level
	    // <id> pad_initial_level
	    // <false"> Low
	    // <true"> High
	    false);

	/* PORT setting on PF2 */

	// Set pin direction to output
	LED20_set_dir(PORT_DIR_OUT);

	LED20_set_level(
	    // <y> Initial level
	    // <id> pad_initial_level
	    // <false"> Low
	    // <true"> High
	    false);

	/* PORT setting on PF5 */

	// Set pin direction to output
	LED19_set_dir(PORT_DIR_OUT);

	LED19_set_level(
	    // <y> Initial level
	    // <id> pad_initial_level
	    // <false"> Low
	    // <true"> High
	    false);

	/* PORT setting on PF6 */

	// Set pin direction to output
	LED6_set_dir(PORT_DIR_OUT);

	LED6_set_level(
	    // <y> Initial level
	    // <id> pad_initial_level
	    // <false"> Low
	    // <true"> High
	    false);

	CLKCTRL_init();

	TIMER_0_timeout_init();

	PWM_0_initialization();

	CPUINT_init();

	SLPCTRL_init();

	I2C_0_initialization();

	BOD_init();
}
