thedarknet/darknet8-badge/DC27/firmware/main/menus/menu_state.h

#ifndef DN8_MENU_STATE_H
#define DN8_MENU_STATE_H

#include "dn8base_menu.h"
#include <device/touch/XPT2046.h>

class MenuState: public DN8BaseMenu {
public:
	static const int QUEUE_SIZE = 10;
	static const int MSG_SIZE = sizeof(libesp::TouchNotification*);
	MenuState();
	virtual ~MenuState();
protected:
	virtual libesp::ErrorType onInit();
	virtual libesp::BaseMenu::ReturnStateContext onRun();
	virtual libesp::ErrorType onShutdown();
private:
	libesp::GUIListData MenuList;
	libesp::GUIListItemData Items[10];
	QueueHandle_t InternalQueueHandler;
	static const uint16_t ItemCount = uint16_t(sizeof(Items) / sizeof(Items[0]));
};

#endif
