thedarknet/darknet8-badge/DC27/firmware/main/ble.cpp

#include "ble.h"
#include <stdio.h>
#include <string.h>
#include "freertos/FreeRTOS.h"
#include "freertos/queue.h"
#include <map>
#include <nvs_flash.h>

#include "app.h"
#include "KeyStore.h"

// bluetooth libraries
#include "esp_bt.h"
#include "esp_gap_ble_api.h"
#include "esp_gatts_api.h"
#include "esp_bt_defs.h"
#include "esp_bt_main.h"

// app libraries
#include "./game_master.h"

BluetoothTask *pBTTask;
const char *BluetoothTask::LOGTAG = "BluetoothTask";
const char *LOGTAG = "BluetoothService";

#define DN8_PROFILE_NUM       0x1
#define DN8_PROFILE_APP_IDX   0x0
#define DN8_APP_ID            0x55
#define DN8_DEVICE_NAME       "DN8_SECURITY"
#define DN8_SVC_INST_ID       0x0

uint16_t dn8_handle_tbl[DN8_IDX_NB];

/* Scan and Advertisement Configuration */
#define ADV_CONFIG_FLAG       (1 << 0)
#define SCAN_RSP_CONFIG_FLAG  (1 << 1)
static uint8_t dn8_manufacturer[3] = {'D', 'N', '8'};
static uint8_t sec_service_uuid[16] = {0xfb, 0x34, 0x9b, 0x5f, 0x80, 0x00, 0x00, 0x80,
	0x00, 0x10, 0x00, 0x00, 0x18, 0x0D, 0x00, 0x00};
static uint8_t adv_config_done = 0;
static esp_ble_adv_data_t dn8_adv_config;
static esp_ble_adv_params_t dn8_adv_params;
static esp_ble_adv_data_t dn8_scan_rsp_config;

static void gatts_profile_event_handler(esp_gatts_cb_event_t event,
	esp_gatt_if_t gatts_if, esp_ble_gatts_cb_param_t* param);

static struct gatts_profile_inst dn8_profile_tab[DN8_PROFILE_NUM];

// Serial Stuff
static uint16_t serial_mtu_size     = 23;
static uint16_t serial_conn_id      = 0xffff;
static bool serial_is_connected       = false;
static esp_gatt_if_t serial_gatts_if   = 0xff;
static esp_bd_addr_t serial_remote_bda = {0x0,};

// Serial game connectivity
static QueueHandle_t gameTaskQueue_g = nullptr;
static QueueHandle_t bleGameResponseQueue_g = nullptr;


// Characteristic Definition helpers
#define CHAR_DECLARATION_SIZE   (sizeof(uint8_t))
static const uint16_t character_declaration_uuid = ESP_GATT_UUID_CHAR_DECLARE;
static const uint16_t character_client_config_uuid = ESP_GATT_UUID_CHAR_CLIENT_CONFIG;

static const uint8_t char_prop_read_notify = ESP_GATT_CHAR_PROP_BIT_READ|ESP_GATT_CHAR_PROP_BIT_NOTIFY;
static const uint8_t char_prop_read_write = ESP_GATT_CHAR_PROP_BIT_WRITE_NR|ESP_GATT_CHAR_PROP_BIT_READ;

/*
 * Profile Attributes
 ************************************
 */
// EXPLOITABLE - data receive and notify characters
static const uint16_t exploitable_data_receive_uuid = ESP_GATT_UUID_EXPLOITABLE_DATA_RECEIVE;
static const uint8_t  exploitable_data_receive_val[20] = {0x00};
static const uint16_t exploitable_data_notify_uuid = ESP_GATT_UUID_EXPLOITABLE_DATA_NOTIFY;
static const uint8_t  exploitable_data_notify_val[20] = {0x00};
static const uint8_t  exploitable_data_notify_ccc[2] = {0x00, 0x00};

// GAMEMASTER - data receive and notify chars
static const uint16_t gamemaster_data_receive_uuid = ESP_GATT_UUID_GAMEMASTER_DATA_RECEIVE;
static const uint8_t  gamemaster_data_receive_val[20] = {0x00};
static const uint16_t gamemaster_data_notify_uuid = ESP_GATT_UUID_GAMEMASTER_DATA_NOTIFY;
static const uint8_t  gamemaster_data_notify_val[20] = {0x00};
static const uint8_t  gamemaster_data_notify_ccc[2] = {0x00, 0x00};

// BRAINFUZZ - data in and out for Brainfuzz game
static const uint16_t brainfuzz_data_receive_uuid = ESP_GATT_UUID_BRAINFUZZ_DATA_RECEIVE;
static const uint8_t  brainfuzz_data_receive_val[20] = {0x00};
static const uint16_t brainfuzz_data_notify_uuid = ESP_GATT_UUID_BRAINFUZZ_DATA_NOTIFY;
static const uint8_t  brainfuzz_data_notify_val[20] = {0x00};
static const uint8_t  brainfuzz_data_notify_ccc[2] = {0x00, 0x00};

// TTT3D -data in and out for the TTT3D game
static const uint16_t ttt3d_data_receive_uuid = ESP_GATT_UUID_TTT3D_DATA_RECEIVE;
static const uint8_t  ttt3d_data_receive_val[20] = {0x00};
static const uint16_t ttt3d_data_notify_uuid = ESP_GATT_UUID_TTT3D_DATA_NOTIFY;
static const uint8_t  ttt3d_data_notify_val[20] = {0x00};
static const uint8_t  ttt3d_data_notify_ccc[2] = {0x00, 0x00};

static const esp_gatts_attr_db_t dn8_gatt_db[DN8_IDX_NB] =
{
	// Service
	[DN8_IDX_SVC] =
	{{ESP_GATT_AUTO_RSP},
		{ESP_UUID_LEN_16,
			(uint8_t *)&primary_service_uuid,
			ESP_GATT_PERM_READ,
			sizeof(uint16_t),
			sizeof(dn8_svc),
			(uint8_t *)&dn8_svc}},

	//Serial - Data receive characteristic, value
	[DN8_IDX_EXPLOITABLE_DATA_RECV_CHAR] =
	{{ESP_GATT_AUTO_RSP},
		{ESP_UUID_LEN_16,
			(uint8_t *)&character_declaration_uuid,
			ESP_GATT_PERM_READ,
			CHAR_DECLARATION_SIZE,
			CHAR_DECLARATION_SIZE,
			(uint8_t *)&char_prop_read_write}},
	[DN8_IDX_EXPLOITABLE_DATA_RECV_VAL] =
	{{ESP_GATT_AUTO_RSP},
		{ESP_UUID_LEN_16,
			(uint8_t *)&exploitable_data_receive_uuid,
			ESP_GATT_PERM_READ|ESP_GATT_PERM_WRITE,
			EXPLOITABLE_DATA_MAX_LEN,
			sizeof(exploitable_data_receive_val),
			(uint8_t *)exploitable_data_receive_val}},

	//Serial: Data notify characteristic, value, descriptor
	[DN8_IDX_EXPLOITABLE_DATA_NOTIFY_CHAR] =
	{{ESP_GATT_AUTO_RSP},
		{ESP_UUID_LEN_16,
			(uint8_t *)&character_declaration_uuid,
			ESP_GATT_PERM_READ,
			CHAR_DECLARATION_SIZE,
			CHAR_DECLARATION_SIZE,
			(uint8_t *)&char_prop_read_notify}},
	[DN8_IDX_EXPLOITABLE_DATA_NOTIFY_VAL] =
	{{ESP_GATT_AUTO_RSP},
		{ESP_UUID_LEN_16,
			(uint8_t *)&exploitable_data_notify_uuid,
			ESP_GATT_PERM_READ,
			EXPLOITABLE_DATA_MAX_LEN,
			sizeof(exploitable_data_notify_val),
			(uint8_t *)exploitable_data_notify_val}},
	[DN8_IDX_EXPLOITABLE_DATA_NOTIFY_CFG] =
	{{ESP_GATT_AUTO_RSP},
		{ESP_UUID_LEN_16,
			(uint8_t *)&character_client_config_uuid,
			ESP_GATT_PERM_READ|ESP_GATT_PERM_WRITE,
			sizeof(uint16_t),
			sizeof(exploitable_data_notify_ccc),
			(uint8_t *)exploitable_data_notify_ccc}},

	//GAMEMASTER - Data receive characteristic, value
	[DN8_IDX_GAMEMASTER_DATA_RECV_CHAR] =
	{{ESP_GATT_AUTO_RSP},
		{ESP_UUID_LEN_16,
			(uint8_t *)&character_declaration_uuid,
			ESP_GATT_PERM_READ,
			CHAR_DECLARATION_SIZE,
			CHAR_DECLARATION_SIZE,
			(uint8_t *)&char_prop_read_write}},
	[DN8_IDX_GAMEMASTER_DATA_RECV_VAL] =
	{{ESP_GATT_AUTO_RSP},
		{ESP_UUID_LEN_16,
			(uint8_t *)&gamemaster_data_receive_uuid,
			ESP_GATT_PERM_READ|ESP_GATT_PERM_WRITE,
			GAMEMASTER_DATA_MAX_LEN,
			sizeof(gamemaster_data_receive_val),
			(uint8_t *)gamemaster_data_receive_val}},

	//GAMEMASTER: Data notify characteristic, value, descriptor
	[DN8_IDX_GAMEMASTER_DATA_NOTIFY_CHAR] =
	{{ESP_GATT_AUTO_RSP},
		{ESP_UUID_LEN_16,
			(uint8_t *)&character_declaration_uuid,
			ESP_GATT_PERM_READ,
			CHAR_DECLARATION_SIZE,
			CHAR_DECLARATION_SIZE,
			(uint8_t *)&char_prop_read_notify}},
	[DN8_IDX_GAMEMASTER_DATA_NOTIFY_VAL] =
	{{ESP_GATT_AUTO_RSP},
		{ESP_UUID_LEN_16,
			(uint8_t *)&gamemaster_data_notify_uuid,
			ESP_GATT_PERM_READ,
			GAMEMASTER_DATA_MAX_LEN,
			sizeof(gamemaster_data_notify_val),
			(uint8_t *)gamemaster_data_notify_val}},
	[DN8_IDX_GAMEMASTER_DATA_NOTIFY_CFG] =
	{{ESP_GATT_AUTO_RSP},
		{ESP_UUID_LEN_16,
			(uint8_t *)&character_client_config_uuid,
			ESP_GATT_PERM_READ|ESP_GATT_PERM_WRITE,
			sizeof(uint16_t),
			sizeof(gamemaster_data_notify_ccc),
			(uint8_t *)gamemaster_data_notify_ccc}},


	//Brainfuzz - Data receive characteristic, value
	[DN8_IDX_BRAINFUZZ_DATA_RECV_CHAR] =
	{{ESP_GATT_AUTO_RSP},
		{ESP_UUID_LEN_16,
			(uint8_t *)&character_declaration_uuid,
			ESP_GATT_PERM_READ,
			CHAR_DECLARATION_SIZE,
			CHAR_DECLARATION_SIZE,
			(uint8_t *)&char_prop_read_write}},
	[DN8_IDX_BRAINFUZZ_DATA_RECV_VAL] =
	{{ESP_GATT_AUTO_RSP},
		{ESP_UUID_LEN_16,
			(uint8_t *)&brainfuzz_data_receive_uuid,
			ESP_GATT_PERM_READ|ESP_GATT_PERM_WRITE,
			BRAINFUZZ_DATA_MAX_LEN,
			sizeof(brainfuzz_data_receive_val),
			(uint8_t *)brainfuzz_data_receive_val}},

	//Brainfuzz: Data notify characteristic, value, descriptor
	[DN8_IDX_BRAINFUZZ_DATA_NOTIFY_CHAR] =
	{{ESP_GATT_AUTO_RSP},
		{ESP_UUID_LEN_16,
			(uint8_t *)&character_declaration_uuid,
			ESP_GATT_PERM_READ,
			CHAR_DECLARATION_SIZE,
			CHAR_DECLARATION_SIZE,
			(uint8_t *)&char_prop_read_notify}},
	[DN8_IDX_BRAINFUZZ_DATA_NOTIFY_VAL] =
	{{ESP_GATT_AUTO_RSP},
		{ESP_UUID_LEN_16,
			(uint8_t *)&brainfuzz_data_notify_uuid,
			ESP_GATT_PERM_READ,
			BRAINFUZZ_DATA_MAX_LEN,
			sizeof(brainfuzz_data_notify_val),
			(uint8_t *)brainfuzz_data_notify_val}},
	[DN8_IDX_BRAINFUZZ_DATA_NOTIFY_CFG] =
	{{ESP_GATT_AUTO_RSP},
		{ESP_UUID_LEN_16,
			(uint8_t *)&character_client_config_uuid,
			ESP_GATT_PERM_READ|ESP_GATT_PERM_WRITE,
			sizeof(uint16_t),
			sizeof(brainfuzz_data_notify_ccc),
			(uint8_t *)brainfuzz_data_notify_ccc}},

	// TTT3D - Data receive characteristic, value
	[DN8_IDX_TTT3D_DATA_RECV_CHAR] =
	{{ESP_GATT_AUTO_RSP},
		{ESP_UUID_LEN_16,
			(uint8_t *)&character_declaration_uuid,
			ESP_GATT_PERM_READ,
			CHAR_DECLARATION_SIZE,
			CHAR_DECLARATION_SIZE,
			(uint8_t *)&char_prop_read_write}},
	[DN8_IDX_TTT3D_DATA_RECV_VAL] =
	{{ESP_GATT_AUTO_RSP},
		{ESP_UUID_LEN_16,
			(uint8_t *)&ttt3d_data_receive_uuid,
			ESP_GATT_PERM_READ|ESP_GATT_PERM_WRITE,
			TTT3D_DATA_MAX_LEN,
			sizeof(ttt3d_data_receive_val),
			(uint8_t *)ttt3d_data_receive_val}},

	// TTT3D: Data notify characteristic, value, descriptor
	[DN8_IDX_TTT3D_DATA_NOTIFY_CHAR] =
	{{ESP_GATT_AUTO_RSP},
		{ESP_UUID_LEN_16,
			(uint8_t *)&character_declaration_uuid,
			ESP_GATT_PERM_READ,
			CHAR_DECLARATION_SIZE,
			CHAR_DECLARATION_SIZE,
			(uint8_t *)&char_prop_read_notify}},
	[DN8_IDX_TTT3D_DATA_NOTIFY_VAL] =
	{{ESP_GATT_AUTO_RSP},
		{ESP_UUID_LEN_16,
			(uint8_t *)&ttt3d_data_notify_uuid,
			ESP_GATT_PERM_READ,
			TTT3D_DATA_MAX_LEN,
			sizeof(ttt3d_data_notify_val),
			(uint8_t *)ttt3d_data_notify_val}},
	[DN8_IDX_TTT3D_DATA_NOTIFY_CFG] =
	{{ESP_GATT_AUTO_RSP},
		{ESP_UUID_LEN_16,
			(uint8_t *)&character_client_config_uuid,
			ESP_GATT_PERM_READ|ESP_GATT_PERM_WRITE,
			sizeof(uint16_t),
			sizeof(ttt3d_data_notify_ccc),
			(uint8_t *)ttt3d_data_notify_ccc}},


};


static uint8_t find_char_and_desr_index(uint16_t handle)
{
	for (int i = 0; i < DN8_IDX_NB; i++)
	{
		if (handle == dn8_handle_tbl[i])
			return i;
	}
	return 0xff; // error
}

static void send_raw_game_command(char* buffer, uint16_t length, uint32_t gameid,
	uint32_t returnContext)
{
	GameMsg* msg = NULL;
	if (gameTaskQueue_g == nullptr)
	{
		ESP_LOGE(LOGTAG, "ATTEMPTED TO SEND COMMAND TO NON-EXISTANT GAME QUEUE");
		return;
	}

	//ESP_LOGI(LOGTAG, "Game Msg. Length:%d - Msg: %s", length, buffer);
	msg = (GameMsg*)malloc(sizeof(GameMsg));
	memset(msg, '\0', sizeof(GameMsg));
	msg->context = gameid;

	msg->length = length;
	msg->data = (char*)malloc(length);
	memcpy(msg->data, buffer, length);

	msg->returnQueue = bleGameResponseQueue_g;
	msg->returnContext = returnContext;

	xQueueSend(gameTaskQueue_g, (void*)&msg, (TickType_t)100);

	return;
}


void BluetoothTask::setGameTaskQueue(QueueHandle_t queue)
{
	this->gameTaskQueue = queue;
	gameTaskQueue_g = queue;
}


void BluetoothTask::gameCommandHandler(GameMsg* msg)
{
	// TODO: Switch
	uint32_t curpos = 0;
	// msg->length
	// esp_log_buffer_char(LOGTAG, msg->data, msg->length);
	// TODO: indicate code with MTU handling
	while (msg->length > 20)
	{
		esp_ble_gatts_send_indicate(serial_gatts_if, serial_conn_id,
			dn8_handle_tbl[msg->returnContext],
			20, (uint8_t*)&msg->data[curpos], false);
			msg->length -= 20;
			curpos += 20;
	}
	esp_ble_gatts_send_indicate(serial_gatts_if, serial_conn_id,
		dn8_handle_tbl[msg->returnContext],
		msg->length, (uint8_t*)&msg->data[curpos], false);
	return;
}

#define CmdQueueTimeout ((TickType_t) 500 / portTICK_PERIOD_MS)
void BluetoothTask::run(void* data)
{
	GameMsg* msg = nullptr;
	ESP_LOGI(LOGTAG, "RUNNING");
	while (1)
	{
		if (xQueueReceive(BLEGameQueueHandle, &msg, CmdQueueTimeout))
		{
			if (msg != nullptr)
			{
				this->gameCommandHandler(msg);
				free(msg->data);
				free(msg);
			}
		}
		// TODO General Command Queue
	}
	ESP_LOGI(LOGTAG, "COMPLETE");
}


static void gap_event_handler(esp_gap_ble_cb_event_t event, esp_ble_gap_cb_param_t *param)
{
	esp_err_t ret;
	ESP_LOGV(LOGTAG, "GAP_EVT, event %d\n", event);

	switch (event)
	{
		// Security Server Example
		case ESP_GAP_BLE_SCAN_RSP_DATA_SET_COMPLETE_EVT:
			// When we've complete a scan, turn advertising back on
			adv_config_done &= (~SCAN_RSP_CONFIG_FLAG);
			if (adv_config_done == 0)
				esp_ble_gap_start_advertising(&dn8_adv_params);
			break;
		case ESP_GAP_BLE_ADV_DATA_SET_COMPLETE_EVT:
			// When we've finished setting advertising data, turn advertising back on
			adv_config_done &= (~ADV_CONFIG_FLAG);
			if (adv_config_done == 0)
				esp_ble_gap_start_advertising(&dn8_adv_params);
			break;
		case ESP_GAP_BLE_ADV_START_COMPLETE_EVT:
			// Fires after advertising is turned on to indicate success or failure
			if (param->adv_start_cmpl.status != ESP_BT_STATUS_SUCCESS)
				ESP_LOGE(LOGTAG, "Advertising Start Failed: %x", param->adv_start_cmpl.status);
			else
				ESP_LOGI(LOGTAG, "Advertising Start Succeess");
			break;
		case ESP_GAP_BLE_PASSKEY_REQ_EVT:
			// Passkey request event, in the case of a non-preset passkey
			// TODO: We will want to replace a preset passkey
			ESP_LOGI(LOGTAG, "PASSKEY_REQ_EVT");
			break;
		case ESP_GAP_BLE_SEC_REQ_EVT:
			// Respond to security request with the affirmative to start the handshake
			esp_ble_gap_security_rsp(param->ble_security.ble_req.bd_addr, true);
			break;
		case ESP_GAP_BLE_NC_REQ_EVT:
			// Received When IO has Display Yes/No and Peer has Display Yes/No capability
			// show the passkey number to the user to confirm it with the number displayed
			// TODO: print to screen
			ESP_LOGI(LOGTAG, "NC_REQ_EVT, Passkey: %d", param->ble_security.key_notif.passkey);
			break;
		case ESP_GAP_BLE_PASSKEY_NOTIF_EVT:
			// Received when IO has Output and peer has Input capability
			ESP_LOGI(LOGTAG, "NOTIF_EVT, Passkey: %06d", param->ble_security.key_notif.passkey);
			break;
		case ESP_GAP_BLE_KEY_EVT:
			// Shows BLE key info shared with perr device to user
			ESP_LOGI(LOGTAG, "KEY_EVT, Key Type: 0x%x", param->ble_security.ble_key.key_type);
			break;
		case ESP_GAP_BLE_AUTH_CMPL_EVT:
			if (param->ble_security.auth_cmpl.success)
				ESP_LOGI(LOGTAG, "CMPL, Mode: 0x%x", param->ble_security.auth_cmpl.auth_mode);
			else
				ESP_LOGE(LOGTAG, "CMPL, Fail: 0x%x", param->ble_security.auth_cmpl.fail_reason);
			break;
		case ESP_GAP_BLE_REMOVE_BOND_DEV_COMPLETE_EVT:
			ESP_LOGI(LOGTAG, "ESP_GAP_BLE_REMOVE_BOND_DEV_COMPLETE_EVT status: %d",
				param->remove_bond_dev_cmpl.status);
			break;
		case ESP_GAP_BLE_SET_LOCAL_PRIVACY_COMPLETE_EVT:
			ESP_LOGI(LOGTAG, "ESP_GAP_BLE_SET_LOCAL_PRIVACY_COMPLETE_EVT");
			if (param->local_privacy_cmpl.status != ESP_BT_STATUS_SUCCESS)
			{
				ESP_LOGE(LOGTAG, "Config Local Privacy Failed: %x",
					param->local_privacy_cmpl.status);
				break;
			}
			ret = esp_ble_gap_config_adv_data(&dn8_adv_config);
			if (ret)
				ESP_LOGE(LOGTAG, "config adv data failed, error code = %x", ret);
			else
				adv_config_done |= ADV_CONFIG_FLAG;

			ret = esp_ble_gap_config_adv_data(&dn8_scan_rsp_config);
			if (ret)
				ESP_LOGE(LOGTAG, "config adv data failed, error code = %x", ret);
			else
				adv_config_done |= SCAN_RSP_CONFIG_FLAG;

			break;
		case ESP_GAP_BLE_OOB_REQ_EVT: // unused
		case ESP_GAP_BLE_LOCAL_IR_EVT: // unused
		case ESP_GAP_BLE_LOCAL_ER_EVT: // unused
		default:
			ESP_LOGI(LOGTAG, "Unused GAP_BLE_.*_EVT");
			break;
	}
}

static void gatts_profile_event_handler(esp_gatts_cb_event_t event,
	esp_gatt_if_t gatts_if, esp_ble_gatts_cb_param_t *param)
{
	ESP_LOGV(LOGTAG, "GATTS Profile Event = %x\n", event);
	uint8_t res = 0xff;
	const char* dname = NULL;
	switch (event)
	{
		case ESP_GATTS_REG_EVT:
			dname = DN8App::get().getContacts().getSettings().getAgentName();
			if (dname[0] == '\0')
				esp_ble_gap_set_device_name(DN8_DEVICE_NAME);
			else
				esp_ble_gap_set_device_name(dname);
			esp_ble_gap_config_local_privacy(true);
			esp_ble_gatts_create_attr_tab(dn8_gatt_db, gatts_if, DN8_IDX_NB, DN8_SVC_INST_ID);
			break;
		case ESP_GATTS_CONNECT_EVT:
			//ESP_LOGI(LOGTAG, "ESP_GATTS_CONNECT_EVT");
			// Get the connection details for the serial stuff
			serial_conn_id      = param->connect.conn_id;
			serial_gatts_if     = gatts_if;
			serial_is_connected = true;
			memcpy(&serial_remote_bda, &param->connect.remote_bda, sizeof(esp_bd_addr_t));
			// setup encryption
			esp_ble_set_encryption(param->connect.remote_bda, ESP_BLE_SEC_ENCRYPT_MITM);
			break;
		case ESP_GATTS_DISCONNECT_EVT:
			//ESP_LOGI(LOGTAG, "ESP_GATTS_DISCONNECT_EVT");
			// Clean up serial stuff
			serial_is_connected = false;
			// Start advertising again
			esp_ble_gap_start_advertising(&dn8_adv_params);
			break;
		case ESP_GATTS_CREAT_ATTR_TAB_EVT:
			ESP_LOGI(LOGTAG, "The number handle = %x",param->add_attr_tab.num_handle);
			if (param->create.status == ESP_GATT_OK)
			{
				if(param->add_attr_tab.num_handle == DN8_IDX_NB)
				{
					memcpy(dn8_handle_tbl, param->add_attr_tab.handles, sizeof(dn8_handle_tbl));
					esp_ble_gatts_start_service(dn8_handle_tbl[DN8_IDX_SVC]);
				}
				else
					ESP_LOGE(LOGTAG, "Create attribute table event abnormal - Bad Handle Num");
			}
			else
				ESP_LOGE(LOGTAG, "Create attribute table failed");
			break;
		case ESP_GATTS_READ_EVT:
			//ESP_LOGI(LOGTAG, "ESP_GATTS_READ_EVT");
			res = find_char_and_desr_index(param->read.handle);
			break;
		case ESP_GATTS_WRITE_EVT:
			//ESP_LOGI(LOGTAG, "ESP_GATTS_WRITE_EVT");
			res = find_char_and_desr_index(param->write.handle);
			if (!param->write.is_prep)
			{
				if (res == DN8_IDX_GAMEMASTER_DATA_RECV_VAL)
				{
					send_raw_game_command((char*)(param->write.value),
						param->write.len,
						GAMEMASTER_ID,
						DN8_IDX_GAMEMASTER_DATA_NOTIFY_VAL);
				}
				else if (res == DN8_IDX_EXPLOITABLE_DATA_RECV_VAL)
				{
					send_raw_game_command((char*)(param->write.value),
						param->write.len,
						EXPLOITABLE_ID,
						DN8_IDX_EXPLOITABLE_DATA_NOTIFY_VAL);
				}
				else if (res == DN8_IDX_BRAINFUZZ_DATA_RECV_VAL)
				{
					send_raw_game_command((char*)(param->write.value),
						param->write.len,
						BRAINFUZZ_ID,
						DN8_IDX_BRAINFUZZ_DATA_NOTIFY_VAL);
				}
				else if (res == DN8_IDX_TTT3D_DATA_RECV_VAL)
				{
					send_raw_game_command((char*)(param->write.value),
						param->write.len,
						TTT3D_ID,
						DN8_IDX_TTT3D_DATA_NOTIFY_VAL);
				}
			}
			break;
		case ESP_GATTS_EXEC_WRITE_EVT:
			//ESP_LOGI(LOGTAG, "ESP_GATTS_EXEC_WRITE_EVT\n");
			break;
		case ESP_GATTS_MTU_EVT:
			serial_mtu_size = param->mtu.mtu;
			break;
		case ESP_GATTS_CONF_EVT:
		case ESP_GATTS_UNREG_EVT:
		case ESP_GATTS_DELETE_EVT:
		case ESP_GATTS_START_EVT:
		case ESP_GATTS_STOP_EVT:
		case ESP_GATTS_OPEN_EVT:
		case ESP_GATTS_CANCEL_OPEN_EVT:
		case ESP_GATTS_CLOSE_EVT:
		case ESP_GATTS_LISTEN_EVT:
		case ESP_GATTS_CONGEST_EVT:
		default:
			break;
	}
}

static void gatts_event_handler(esp_gatts_cb_event_t event, esp_gatt_if_t gatts_if,
	esp_ble_gatts_cb_param_t *param)
{
	// If event is register event, store the gatts_if for each profile
	if (event == ESP_GATTS_REG_EVT)
	{
		if (param->reg.status == ESP_GATT_OK)
			dn8_profile_tab[DN8_PROFILE_APP_IDX].gatts_if = gatts_if;
		else
		{
			ESP_LOGI(LOGTAG, "Reg app failed, app_id %04x, status %d\n",
				param->reg.app_id, param->reg.status);
			return;
		}
	}

	do
	{
		int idx;
		for (idx = 0; idx < DN8_PROFILE_NUM; idx++)
		{
			if (gatts_if == ESP_GATT_IF_NONE ||
				gatts_if == dn8_profile_tab[idx].gatts_if)
			{
				if (dn8_profile_tab[idx].gatts_cb)
					dn8_profile_tab[idx].gatts_cb(event, gatts_if, param);
			}
		}
	} while (0);
}


static void init_ble_globals(void)
{
	// Advertisement configuation
	dn8_adv_config.set_scan_rsp = false;
	dn8_adv_config.include_txpower = true;
	dn8_adv_config.min_interval = 0x100;
	dn8_adv_config.max_interval = 0x100;
	dn8_adv_config.appearance = 0x00;
	dn8_adv_config.manufacturer_len = sizeof(dn8_manufacturer);
	dn8_adv_config.p_manufacturer_data = dn8_manufacturer;
	dn8_adv_config.service_data_len = 0;
	dn8_adv_config.p_service_data = NULL;
	dn8_adv_config.service_uuid_len = sizeof(sec_service_uuid);
	dn8_adv_config.p_service_uuid = sec_service_uuid;
	dn8_adv_config.flag = (ESP_BLE_ADV_FLAG_GEN_DISC | ESP_BLE_ADV_FLAG_BREDR_NOT_SPT);

	// Advertisement parameters
	dn8_adv_params.adv_int_min       = 0x100;
	dn8_adv_params.adv_int_max       = 0x100;
	dn8_adv_params.adv_type          = ADV_TYPE_IND;
	dn8_adv_params.own_addr_type     = BLE_ADDR_TYPE_RANDOM;
	dn8_adv_params.channel_map       = ADV_CHNL_ALL;
	dn8_adv_params.adv_filter_policy = ADV_FILTER_ALLOW_SCAN_ANY_CON_ANY;

	// Scan rsp configuration
	dn8_scan_rsp_config.set_scan_rsp = true;
	dn8_scan_rsp_config.include_name = true;
	dn8_scan_rsp_config.manufacturer_len = sizeof(dn8_manufacturer);
	dn8_scan_rsp_config.p_manufacturer_data = dn8_manufacturer;

	// Setup the application callback handler
	dn8_profile_tab[DN8_PROFILE_APP_IDX].gatts_cb = gatts_profile_event_handler;
	dn8_profile_tab[DN8_PROFILE_APP_IDX].gatts_if = ESP_GATT_IF_NONE;

}

static bool ble_initialized = false;
bool ble_get_initialized()
{
	return ble_initialized;
}

static uint32_t PASSKEY = 0;
uint32_t ble_get_passkey()
{
	return PASSKEY;
}

static void init_ble_security(void)
{
	esp_ble_auth_req_t auth_req = ESP_LE_AUTH_REQ_SC_MITM_BOND; // Bond w/ device after auth
	esp_ble_io_cap_t iocap = ESP_IO_CAP_OUT; // no output, no input - TODO: ESP_IO_CAP_IO
	uint8_t key_size = 16; // 7-16 bytes in length
	uint8_t init_key = ESP_BLE_ENC_KEY_MASK | ESP_BLE_ID_KEY_MASK;
	uint8_t resp_key = ESP_BLE_ENC_KEY_MASK | ESP_BLE_ID_KEY_MASK;
	uint8_t auth_option = ESP_BLE_ONLY_ACCEPT_SPECIFIED_AUTH_ENABLE;

	//generate a random number for the passkey
	PASSKEY = esp_random() % 999999;

	// FIXME: Different passkey? No passkey but use verification?
	esp_ble_gap_set_security_param(ESP_BLE_SM_SET_STATIC_PASSKEY, &PASSKEY, sizeof(uint32_t));
	esp_ble_gap_set_security_param(ESP_BLE_SM_AUTHEN_REQ_MODE, &auth_req,
		sizeof(esp_ble_auth_req_t));
	esp_ble_gap_set_security_param(ESP_BLE_SM_IOCAP_MODE, &iocap, sizeof(esp_ble_io_cap_t));
	esp_ble_gap_set_security_param(ESP_BLE_SM_MAX_KEY_SIZE, &key_size, sizeof(uint8_t));
	esp_ble_gap_set_security_param(ESP_BLE_SM_ONLY_ACCEPT_SPECIFIED_SEC_AUTH, &auth_option,
		sizeof(uint8_t));

	// When acting as server, init_key means which types of key client should distribute
	// and resp_key means which keys the server can distribute
	// When acting as client, this is flipped around
	esp_ble_gap_set_security_param(ESP_BLE_SM_SET_INIT_KEY, &init_key, sizeof(uint8_t));
	esp_ble_gap_set_security_param(ESP_BLE_SM_SET_RSP_KEY, &resp_key, sizeof(uint8_t));
}

static esp_err_t init_ble(void)
{
	esp_err_t ret = 0;

	// Initialize general Bluetooth / Bluedroid
	ESP_ERROR_CHECK(esp_bt_controller_mem_release(ESP_BT_MODE_CLASSIC_BT));
	esp_bt_controller_config_t bt_cfg = BT_CONTROLLER_INIT_CONFIG_DEFAULT();
	ret = esp_bt_controller_init(&bt_cfg);
	if (ret)
	{
		ESP_LOGE(LOGTAG, "%s init controller failed: %s", __func__, esp_err_to_name(ret));
		return ret;
	}
	ret = esp_bt_controller_enable(ESP_BT_MODE_BLE);
	if (ret)
	{
		ESP_LOGE(LOGTAG, "%s enable controller failed %s", __func__, esp_err_to_name(ret));
		return ret;
	}
	ESP_LOGI(LOGTAG, "%s init bluetooth", __func__);
	ret = esp_bluedroid_init();
	if (ret)
	{
		ESP_LOGE(LOGTAG, "%s init bluetooth failed: %s", __func__, esp_err_to_name(ret));
		return ret;
	}
	ret = esp_bluedroid_enable();
	if (ret)
	{
		ESP_LOGE(LOGTAG, "%s enable bluetooth failed: %s", __func__, esp_err_to_name(ret));
		return ret;
	}

	// Register the gatts register, gap register, and gatts app register callbacks
	ret = esp_ble_gatts_register_callback(gatts_event_handler);
	if (ret)
	{
		ESP_LOGE(LOGTAG, "gatts register error, error code = %x", ret);
		return ret;
	}

	ret = esp_ble_gap_register_callback(gap_event_handler);
	if (ret)
	{
		ESP_LOGE(LOGTAG, "gap register error, error code = %x", ret);
		return ret;
	}

	ret = esp_ble_gatts_app_register(DN8_APP_ID);
	if (ret)
	{
		ESP_LOGE(LOGTAG, "gatts app register error, error code = %x", ret);
		return ret;
	}
	else // good to go, setup all the other info
	{
		init_ble_security();
	}
	return ret;
}

bool BluetoothTask::init()
{
	esp_err_t ret = 0;
	ESP_LOGI(LOGTAG, "INIT START");
	pBTTask = this;

	this->BLEGameQueueHandle = xQueueCreateStatic(BLE_QUEUE_SIZE, BLE_MSG_SIZE,
		bleGameQueueBuffer, &BLEGameQueue);
	bleGameResponseQueue_g = this->BLEGameQueueHandle;

	// TODO: General command queue

	init_ble_globals();
	ret = init_ble();
	if (ret)
		ESP_LOGE(LOGTAG, "BLE Initialization failed\n");
	else
		ESP_LOGI(LOGTAG, "BLE Initialization succeeded\n");
	// TODO:
	// open nvs, get badge name from flash

	// initialize bluetooth device with name, if found, otherwise default to DN8-Dev

	// Create the server
	// Create the UART Service
		// UART UUID
		// Input Characteristic
		// Output Characteristic
		// Descriptor

	// Setup Advertising

	ESP_LOGI(LOGTAG, "INIT COMPLETE");
	ble_initialized = true;
	return true;
}

BluetoothTask::BluetoothTask(const std::string &tName, uint16_t stackSize, uint8_t priority)
	: Task(tName, stackSize, priority)
{
	this->LOGTAG = LOGTAG;
	ESP_LOGI(LOGTAG, "CREATE");
}

BluetoothTask::~BluetoothTask()
{
	// TODO
	ESP_LOGI(LOGTAG, "DESTROY");
}
