thedarknet/darknet8-badge/DC27/top-board-firmware/DarkNet8-Top/DC27Top/include/atmel_start_pins.h

/*
 * Code generated from START.
 *
 * This file will be overwritten when reconfiguring your START project.
 * Please copy examples or other code you want to keep to a separate file
 * to avoid losing it when reconfiguring.
 */
#ifndef ATMEL_START_PINS_H_INCLUDED
#define ATMEL_START_PINS_H_INCLUDED

#include <port.h>

/**
 * \brief Set PA0 pull mode
 *
 * Configure pin to pull up, down or disable pull mode, supported pull
 * modes are defined by device used
 *
 * \param[in] pull_mode Pin pull mode
 */
static inline void PA0_set_pull_mode(const enum port_pull_mode pull_mode)
{
	PORTA_set_pin_pull_mode(0, pull_mode);
}

/**
 * \brief Set PA0 data direction
 *
 * Select if the pin data direction is input, output or disabled.
 * If disabled state is not possible, this function throws an assert.
 *
 * \param[in] direction PORT_DIR_IN  = Data direction in
 *                      PORT_DIR_OUT = Data direction out
 *                      PORT_DIR_OFF = Disables the pin
 *                      (low power state)
 */
static inline void PA0_set_dir(const enum port_dir dir)
{
	PORTA_set_pin_dir(0, dir);
}

/**
 * \brief Set PA0 input/sense configuration
 *
 * Enable/disable PA0 digital input buffer and pin change interrupt,
 * select pin interrupt edge/level sensing mode
 *
 * \param[in] isc PORT_ISC_INTDISABLE_gc    = Iterrupt disabled but input buffer enabled
 *                PORT_ISC_BOTHEDGES_gc     = Sense Both Edges
 *                PORT_ISC_RISING_gc        = Sense Rising Edge
 *                PORT_ISC_FALLING_gc       = Sense Falling Edge
 *                PORT_ISC_INPUT_DISABLE_gc = Digital Input Buffer disabled
 *                PORT_ISC_LEVEL_gc         = Sense low Level
 */
static inline void PA0_set_isc(const PORT_ISC_t isc)
{
	PORTA_pin_set_isc(0, isc);
}

/**
 * \brief Set PA0 inverted mode
 *
 * Enable or disable inverted I/O on a pin
 *
 * \param[in] inverted true  = I/O on PA0 is inverted
 *                     false = I/O on PA0 is not inverted
 */
static inline void PA0_set_inverted(const bool inverted)
{
	PORTA_pin_set_inverted(0, inverted);
}

/**
 * \brief Set PA0 level
 *
 * Sets output level on a pin
 *
 * \param[in] level true  = Pin level set to "high" state
 *                  false = Pin level set to "low" state
 */
static inline void PA0_set_level(const bool level)
{
	PORTA_set_pin_level(0, level);
}

/**
 * \brief Toggle output level on PA0
 *
 * Toggle the pin level
 */
static inline void PA0_toggle_level()
{
	PORTA_toggle_pin_level(0);
}

/**
 * \brief Get level on PA0
 *
 * Reads the level on a pin
 */
static inline bool PA0_get_level()
{
	return PORTA_get_pin_level(0);
}

/**
 * \brief Set LED5 pull mode
 *
 * Configure pin to pull up, down or disable pull mode, supported pull
 * modes are defined by device used
 *
 * \param[in] pull_mode Pin pull mode
 */
static inline void LED5_set_pull_mode(const enum port_pull_mode pull_mode)
{
	PORTA_set_pin_pull_mode(1, pull_mode);
}

/**
 * \brief Set LED5 data direction
 *
 * Select if the pin data direction is input, output or disabled.
 * If disabled state is not possible, this function throws an assert.
 *
 * \param[in] direction PORT_DIR_IN  = Data direction in
 *                      PORT_DIR_OUT = Data direction out
 *                      PORT_DIR_OFF = Disables the pin
 *                      (low power state)
 */
static inline void LED5_set_dir(const enum port_dir dir)
{
	PORTA_set_pin_dir(1, dir);
}

/**
 * \brief Set LED5 input/sense configuration
 *
 * Enable/disable LED5 digital input buffer and pin change interrupt,
 * select pin interrupt edge/level sensing mode
 *
 * \param[in] isc PORT_ISC_INTDISABLE_gc    = Iterrupt disabled but input buffer enabled
 *                PORT_ISC_BOTHEDGES_gc     = Sense Both Edges
 *                PORT_ISC_RISING_gc        = Sense Rising Edge
 *                PORT_ISC_FALLING_gc       = Sense Falling Edge
 *                PORT_ISC_INPUT_DISABLE_gc = Digital Input Buffer disabled
 *                PORT_ISC_LEVEL_gc         = Sense low Level
 */
static inline void LED5_set_isc(const PORT_ISC_t isc)
{
	PORTA_pin_set_isc(1, isc);
}

/**
 * \brief Set LED5 inverted mode
 *
 * Enable or disable inverted I/O on a pin
 *
 * \param[in] inverted true  = I/O on LED5 is inverted
 *                     false = I/O on LED5 is not inverted
 */
static inline void LED5_set_inverted(const bool inverted)
{
	PORTA_pin_set_inverted(1, inverted);
}

/**
 * \brief Set LED5 level
 *
 * Sets output level on a pin
 *
 * \param[in] level true  = Pin level set to "high" state
 *                  false = Pin level set to "low" state
 */
static inline void LED5_set_level(const bool level)
{
	PORTA_set_pin_level(1, level);
}

/**
 * \brief Toggle output level on LED5
 *
 * Toggle the pin level
 */
static inline void LED5_toggle_level()
{
	PORTA_toggle_pin_level(1);
}

/**
 * \brief Get level on LED5
 *
 * Reads the level on a pin
 */
static inline bool LED5_get_level()
{
	return PORTA_get_pin_level(1);
}

/**
 * \brief Set PA2 pull mode
 *
 * Configure pin to pull up, down or disable pull mode, supported pull
 * modes are defined by device used
 *
 * \param[in] pull_mode Pin pull mode
 */
static inline void PA2_set_pull_mode(const enum port_pull_mode pull_mode)
{
	PORTA_set_pin_pull_mode(2, pull_mode);
}

/**
 * \brief Set PA2 data direction
 *
 * Select if the pin data direction is input, output or disabled.
 * If disabled state is not possible, this function throws an assert.
 *
 * \param[in] direction PORT_DIR_IN  = Data direction in
 *                      PORT_DIR_OUT = Data direction out
 *                      PORT_DIR_OFF = Disables the pin
 *                      (low power state)
 */
static inline void PA2_set_dir(const enum port_dir dir)
{
	PORTA_set_pin_dir(2, dir);
}

/**
 * \brief Set PA2 input/sense configuration
 *
 * Enable/disable PA2 digital input buffer and pin change interrupt,
 * select pin interrupt edge/level sensing mode
 *
 * \param[in] isc PORT_ISC_INTDISABLE_gc    = Iterrupt disabled but input buffer enabled
 *                PORT_ISC_BOTHEDGES_gc     = Sense Both Edges
 *                PORT_ISC_RISING_gc        = Sense Rising Edge
 *                PORT_ISC_FALLING_gc       = Sense Falling Edge
 *                PORT_ISC_INPUT_DISABLE_gc = Digital Input Buffer disabled
 *                PORT_ISC_LEVEL_gc         = Sense low Level
 */
static inline void PA2_set_isc(const PORT_ISC_t isc)
{
	PORTA_pin_set_isc(2, isc);
}

/**
 * \brief Set PA2 inverted mode
 *
 * Enable or disable inverted I/O on a pin
 *
 * \param[in] inverted true  = I/O on PA2 is inverted
 *                     false = I/O on PA2 is not inverted
 */
static inline void PA2_set_inverted(const bool inverted)
{
	PORTA_pin_set_inverted(2, inverted);
}

/**
 * \brief Set PA2 level
 *
 * Sets output level on a pin
 *
 * \param[in] level true  = Pin level set to "high" state
 *                  false = Pin level set to "low" state
 */
static inline void PA2_set_level(const bool level)
{
	PORTA_set_pin_level(2, level);
}

/**
 * \brief Toggle output level on PA2
 *
 * Toggle the pin level
 */
static inline void PA2_toggle_level()
{
	PORTA_toggle_pin_level(2);
}

/**
 * \brief Get level on PA2
 *
 * Reads the level on a pin
 */
static inline bool PA2_get_level()
{
	return PORTA_get_pin_level(2);
}

/**
 * \brief Set PA3 pull mode
 *
 * Configure pin to pull up, down or disable pull mode, supported pull
 * modes are defined by device used
 *
 * \param[in] pull_mode Pin pull mode
 */
static inline void PA3_set_pull_mode(const enum port_pull_mode pull_mode)
{
	PORTA_set_pin_pull_mode(3, pull_mode);
}

/**
 * \brief Set PA3 data direction
 *
 * Select if the pin data direction is input, output or disabled.
 * If disabled state is not possible, this function throws an assert.
 *
 * \param[in] direction PORT_DIR_IN  = Data direction in
 *                      PORT_DIR_OUT = Data direction out
 *                      PORT_DIR_OFF = Disables the pin
 *                      (low power state)
 */
static inline void PA3_set_dir(const enum port_dir dir)
{
	PORTA_set_pin_dir(3, dir);
}

/**
 * \brief Set PA3 input/sense configuration
 *
 * Enable/disable PA3 digital input buffer and pin change interrupt,
 * select pin interrupt edge/level sensing mode
 *
 * \param[in] isc PORT_ISC_INTDISABLE_gc    = Iterrupt disabled but input buffer enabled
 *                PORT_ISC_BOTHEDGES_gc     = Sense Both Edges
 *                PORT_ISC_RISING_gc        = Sense Rising Edge
 *                PORT_ISC_FALLING_gc       = Sense Falling Edge
 *                PORT_ISC_INPUT_DISABLE_gc = Digital Input Buffer disabled
 *                PORT_ISC_LEVEL_gc         = Sense low Level
 */
static inline void PA3_set_isc(const PORT_ISC_t isc)
{
	PORTA_pin_set_isc(3, isc);
}

/**
 * \brief Set PA3 inverted mode
 *
 * Enable or disable inverted I/O on a pin
 *
 * \param[in] inverted true  = I/O on PA3 is inverted
 *                     false = I/O on PA3 is not inverted
 */
static inline void PA3_set_inverted(const bool inverted)
{
	PORTA_pin_set_inverted(3, inverted);
}

/**
 * \brief Set PA3 level
 *
 * Sets output level on a pin
 *
 * \param[in] level true  = Pin level set to "high" state
 *                  false = Pin level set to "low" state
 */
static inline void PA3_set_level(const bool level)
{
	PORTA_set_pin_level(3, level);
}

/**
 * \brief Toggle output level on PA3
 *
 * Toggle the pin level
 */
static inline void PA3_toggle_level()
{
	PORTA_toggle_pin_level(3);
}

/**
 * \brief Get level on PA3
 *
 * Reads the level on a pin
 */
static inline bool PA3_get_level()
{
	return PORTA_get_pin_level(3);
}

/**
 * \brief Set LED4 pull mode
 *
 * Configure pin to pull up, down or disable pull mode, supported pull
 * modes are defined by device used
 *
 * \param[in] pull_mode Pin pull mode
 */
static inline void LED4_set_pull_mode(const enum port_pull_mode pull_mode)
{
	PORTA_set_pin_pull_mode(4, pull_mode);
}

/**
 * \brief Set LED4 data direction
 *
 * Select if the pin data direction is input, output or disabled.
 * If disabled state is not possible, this function throws an assert.
 *
 * \param[in] direction PORT_DIR_IN  = Data direction in
 *                      PORT_DIR_OUT = Data direction out
 *                      PORT_DIR_OFF = Disables the pin
 *                      (low power state)
 */
static inline void LED4_set_dir(const enum port_dir dir)
{
	PORTA_set_pin_dir(4, dir);
}

/**
 * \brief Set LED4 input/sense configuration
 *
 * Enable/disable LED4 digital input buffer and pin change interrupt,
 * select pin interrupt edge/level sensing mode
 *
 * \param[in] isc PORT_ISC_INTDISABLE_gc    = Iterrupt disabled but input buffer enabled
 *                PORT_ISC_BOTHEDGES_gc     = Sense Both Edges
 *                PORT_ISC_RISING_gc        = Sense Rising Edge
 *                PORT_ISC_FALLING_gc       = Sense Falling Edge
 *                PORT_ISC_INPUT_DISABLE_gc = Digital Input Buffer disabled
 *                PORT_ISC_LEVEL_gc         = Sense low Level
 */
static inline void LED4_set_isc(const PORT_ISC_t isc)
{
	PORTA_pin_set_isc(4, isc);
}

/**
 * \brief Set LED4 inverted mode
 *
 * Enable or disable inverted I/O on a pin
 *
 * \param[in] inverted true  = I/O on LED4 is inverted
 *                     false = I/O on LED4 is not inverted
 */
static inline void LED4_set_inverted(const bool inverted)
{
	PORTA_pin_set_inverted(4, inverted);
}

/**
 * \brief Set LED4 level
 *
 * Sets output level on a pin
 *
 * \param[in] level true  = Pin level set to "high" state
 *                  false = Pin level set to "low" state
 */
static inline void LED4_set_level(const bool level)
{
	PORTA_set_pin_level(4, level);
}

/**
 * \brief Toggle output level on LED4
 *
 * Toggle the pin level
 */
static inline void LED4_toggle_level()
{
	PORTA_toggle_pin_level(4);
}

/**
 * \brief Get level on LED4
 *
 * Reads the level on a pin
 */
static inline bool LED4_get_level()
{
	return PORTA_get_pin_level(4);
}

/**
 * \brief Set LED3 pull mode
 *
 * Configure pin to pull up, down or disable pull mode, supported pull
 * modes are defined by device used
 *
 * \param[in] pull_mode Pin pull mode
 */
static inline void LED3_set_pull_mode(const enum port_pull_mode pull_mode)
{
	PORTA_set_pin_pull_mode(5, pull_mode);
}

/**
 * \brief Set LED3 data direction
 *
 * Select if the pin data direction is input, output or disabled.
 * If disabled state is not possible, this function throws an assert.
 *
 * \param[in] direction PORT_DIR_IN  = Data direction in
 *                      PORT_DIR_OUT = Data direction out
 *                      PORT_DIR_OFF = Disables the pin
 *                      (low power state)
 */
static inline void LED3_set_dir(const enum port_dir dir)
{
	PORTA_set_pin_dir(5, dir);
}

/**
 * \brief Set LED3 input/sense configuration
 *
 * Enable/disable LED3 digital input buffer and pin change interrupt,
 * select pin interrupt edge/level sensing mode
 *
 * \param[in] isc PORT_ISC_INTDISABLE_gc    = Iterrupt disabled but input buffer enabled
 *                PORT_ISC_BOTHEDGES_gc     = Sense Both Edges
 *                PORT_ISC_RISING_gc        = Sense Rising Edge
 *                PORT_ISC_FALLING_gc       = Sense Falling Edge
 *                PORT_ISC_INPUT_DISABLE_gc = Digital Input Buffer disabled
 *                PORT_ISC_LEVEL_gc         = Sense low Level
 */
static inline void LED3_set_isc(const PORT_ISC_t isc)
{
	PORTA_pin_set_isc(5, isc);
}

/**
 * \brief Set LED3 inverted mode
 *
 * Enable or disable inverted I/O on a pin
 *
 * \param[in] inverted true  = I/O on LED3 is inverted
 *                     false = I/O on LED3 is not inverted
 */
static inline void LED3_set_inverted(const bool inverted)
{
	PORTA_pin_set_inverted(5, inverted);
}

/**
 * \brief Set LED3 level
 *
 * Sets output level on a pin
 *
 * \param[in] level true  = Pin level set to "high" state
 *                  false = Pin level set to "low" state
 */
static inline void LED3_set_level(const bool level)
{
	PORTA_set_pin_level(5, level);
}

/**
 * \brief Toggle output level on LED3
 *
 * Toggle the pin level
 */
static inline void LED3_toggle_level()
{
	PORTA_toggle_pin_level(5);
}

/**
 * \brief Get level on LED3
 *
 * Reads the level on a pin
 */
static inline bool LED3_get_level()
{
	return PORTA_get_pin_level(5);
}

/**
 * \brief Set LED2 pull mode
 *
 * Configure pin to pull up, down or disable pull mode, supported pull
 * modes are defined by device used
 *
 * \param[in] pull_mode Pin pull mode
 */
static inline void LED2_set_pull_mode(const enum port_pull_mode pull_mode)
{
	PORTA_set_pin_pull_mode(6, pull_mode);
}

/**
 * \brief Set LED2 data direction
 *
 * Select if the pin data direction is input, output or disabled.
 * If disabled state is not possible, this function throws an assert.
 *
 * \param[in] direction PORT_DIR_IN  = Data direction in
 *                      PORT_DIR_OUT = Data direction out
 *                      PORT_DIR_OFF = Disables the pin
 *                      (low power state)
 */
static inline void LED2_set_dir(const enum port_dir dir)
{
	PORTA_set_pin_dir(6, dir);
}

/**
 * \brief Set LED2 input/sense configuration
 *
 * Enable/disable LED2 digital input buffer and pin change interrupt,
 * select pin interrupt edge/level sensing mode
 *
 * \param[in] isc PORT_ISC_INTDISABLE_gc    = Iterrupt disabled but input buffer enabled
 *                PORT_ISC_BOTHEDGES_gc     = Sense Both Edges
 *                PORT_ISC_RISING_gc        = Sense Rising Edge
 *                PORT_ISC_FALLING_gc       = Sense Falling Edge
 *                PORT_ISC_INPUT_DISABLE_gc = Digital Input Buffer disabled
 *                PORT_ISC_LEVEL_gc         = Sense low Level
 */
static inline void LED2_set_isc(const PORT_ISC_t isc)
{
	PORTA_pin_set_isc(6, isc);
}

/**
 * \brief Set LED2 inverted mode
 *
 * Enable or disable inverted I/O on a pin
 *
 * \param[in] inverted true  = I/O on LED2 is inverted
 *                     false = I/O on LED2 is not inverted
 */
static inline void LED2_set_inverted(const bool inverted)
{
	PORTA_pin_set_inverted(6, inverted);
}

/**
 * \brief Set LED2 level
 *
 * Sets output level on a pin
 *
 * \param[in] level true  = Pin level set to "high" state
 *                  false = Pin level set to "low" state
 */
static inline void LED2_set_level(const bool level)
{
	PORTA_set_pin_level(6, level);
}

/**
 * \brief Toggle output level on LED2
 *
 * Toggle the pin level
 */
static inline void LED2_toggle_level()
{
	PORTA_toggle_pin_level(6);
}

/**
 * \brief Get level on LED2
 *
 * Reads the level on a pin
 */
static inline bool LED2_get_level()
{
	return PORTA_get_pin_level(6);
}

/**
 * \brief Set LED1 pull mode
 *
 * Configure pin to pull up, down or disable pull mode, supported pull
 * modes are defined by device used
 *
 * \param[in] pull_mode Pin pull mode
 */
static inline void LED1_set_pull_mode(const enum port_pull_mode pull_mode)
{
	PORTA_set_pin_pull_mode(7, pull_mode);
}

/**
 * \brief Set LED1 data direction
 *
 * Select if the pin data direction is input, output or disabled.
 * If disabled state is not possible, this function throws an assert.
 *
 * \param[in] direction PORT_DIR_IN  = Data direction in
 *                      PORT_DIR_OUT = Data direction out
 *                      PORT_DIR_OFF = Disables the pin
 *                      (low power state)
 */
static inline void LED1_set_dir(const enum port_dir dir)
{
	PORTA_set_pin_dir(7, dir);
}

/**
 * \brief Set LED1 input/sense configuration
 *
 * Enable/disable LED1 digital input buffer and pin change interrupt,
 * select pin interrupt edge/level sensing mode
 *
 * \param[in] isc PORT_ISC_INTDISABLE_gc    = Iterrupt disabled but input buffer enabled
 *                PORT_ISC_BOTHEDGES_gc     = Sense Both Edges
 *                PORT_ISC_RISING_gc        = Sense Rising Edge
 *                PORT_ISC_FALLING_gc       = Sense Falling Edge
 *                PORT_ISC_INPUT_DISABLE_gc = Digital Input Buffer disabled
 *                PORT_ISC_LEVEL_gc         = Sense low Level
 */
static inline void LED1_set_isc(const PORT_ISC_t isc)
{
	PORTA_pin_set_isc(7, isc);
}

/**
 * \brief Set LED1 inverted mode
 *
 * Enable or disable inverted I/O on a pin
 *
 * \param[in] inverted true  = I/O on LED1 is inverted
 *                     false = I/O on LED1 is not inverted
 */
static inline void LED1_set_inverted(const bool inverted)
{
	PORTA_pin_set_inverted(7, inverted);
}

/**
 * \brief Set LED1 level
 *
 * Sets output level on a pin
 *
 * \param[in] level true  = Pin level set to "high" state
 *                  false = Pin level set to "low" state
 */
static inline void LED1_set_level(const bool level)
{
	PORTA_set_pin_level(7, level);
}

/**
 * \brief Toggle output level on LED1
 *
 * Toggle the pin level
 */
static inline void LED1_toggle_level()
{
	PORTA_toggle_pin_level(7);
}

/**
 * \brief Get level on LED1
 *
 * Reads the level on a pin
 */
static inline bool LED1_get_level()
{
	return PORTA_get_pin_level(7);
}

/**
 * \brief Set LED12 pull mode
 *
 * Configure pin to pull up, down or disable pull mode, supported pull
 * modes are defined by device used
 *
 * \param[in] pull_mode Pin pull mode
 */
static inline void LED12_set_pull_mode(const enum port_pull_mode pull_mode)
{
	PORTC_set_pin_pull_mode(0, pull_mode);
}

/**
 * \brief Set LED12 data direction
 *
 * Select if the pin data direction is input, output or disabled.
 * If disabled state is not possible, this function throws an assert.
 *
 * \param[in] direction PORT_DIR_IN  = Data direction in
 *                      PORT_DIR_OUT = Data direction out
 *                      PORT_DIR_OFF = Disables the pin
 *                      (low power state)
 */
static inline void LED12_set_dir(const enum port_dir dir)
{
	PORTC_set_pin_dir(0, dir);
}

/**
 * \brief Set LED12 input/sense configuration
 *
 * Enable/disable LED12 digital input buffer and pin change interrupt,
 * select pin interrupt edge/level sensing mode
 *
 * \param[in] isc PORT_ISC_INTDISABLE_gc    = Iterrupt disabled but input buffer enabled
 *                PORT_ISC_BOTHEDGES_gc     = Sense Both Edges
 *                PORT_ISC_RISING_gc        = Sense Rising Edge
 *                PORT_ISC_FALLING_gc       = Sense Falling Edge
 *                PORT_ISC_INPUT_DISABLE_gc = Digital Input Buffer disabled
 *                PORT_ISC_LEVEL_gc         = Sense low Level
 */
static inline void LED12_set_isc(const PORT_ISC_t isc)
{
	PORTC_pin_set_isc(0, isc);
}

/**
 * \brief Set LED12 inverted mode
 *
 * Enable or disable inverted I/O on a pin
 *
 * \param[in] inverted true  = I/O on LED12 is inverted
 *                     false = I/O on LED12 is not inverted
 */
static inline void LED12_set_inverted(const bool inverted)
{
	PORTC_pin_set_inverted(0, inverted);
}

/**
 * \brief Set LED12 level
 *
 * Sets output level on a pin
 *
 * \param[in] level true  = Pin level set to "high" state
 *                  false = Pin level set to "low" state
 */
static inline void LED12_set_level(const bool level)
{
	PORTC_set_pin_level(0, level);
}

/**
 * \brief Toggle output level on LED12
 *
 * Toggle the pin level
 */
static inline void LED12_toggle_level()
{
	PORTC_toggle_pin_level(0);
}

/**
 * \brief Get level on LED12
 *
 * Reads the level on a pin
 */
static inline bool LED12_get_level()
{
	return PORTC_get_pin_level(0);
}

/**
 * \brief Set LED11 pull mode
 *
 * Configure pin to pull up, down or disable pull mode, supported pull
 * modes are defined by device used
 *
 * \param[in] pull_mode Pin pull mode
 */
static inline void LED11_set_pull_mode(const enum port_pull_mode pull_mode)
{
	PORTC_set_pin_pull_mode(1, pull_mode);
}

/**
 * \brief Set LED11 data direction
 *
 * Select if the pin data direction is input, output or disabled.
 * If disabled state is not possible, this function throws an assert.
 *
 * \param[in] direction PORT_DIR_IN  = Data direction in
 *                      PORT_DIR_OUT = Data direction out
 *                      PORT_DIR_OFF = Disables the pin
 *                      (low power state)
 */
static inline void LED11_set_dir(const enum port_dir dir)
{
	PORTC_set_pin_dir(1, dir);
}

/**
 * \brief Set LED11 input/sense configuration
 *
 * Enable/disable LED11 digital input buffer and pin change interrupt,
 * select pin interrupt edge/level sensing mode
 *
 * \param[in] isc PORT_ISC_INTDISABLE_gc    = Iterrupt disabled but input buffer enabled
 *                PORT_ISC_BOTHEDGES_gc     = Sense Both Edges
 *                PORT_ISC_RISING_gc        = Sense Rising Edge
 *                PORT_ISC_FALLING_gc       = Sense Falling Edge
 *                PORT_ISC_INPUT_DISABLE_gc = Digital Input Buffer disabled
 *                PORT_ISC_LEVEL_gc         = Sense low Level
 */
static inline void LED11_set_isc(const PORT_ISC_t isc)
{
	PORTC_pin_set_isc(1, isc);
}

/**
 * \brief Set LED11 inverted mode
 *
 * Enable or disable inverted I/O on a pin
 *
 * \param[in] inverted true  = I/O on LED11 is inverted
 *                     false = I/O on LED11 is not inverted
 */
static inline void LED11_set_inverted(const bool inverted)
{
	PORTC_pin_set_inverted(1, inverted);
}

/**
 * \brief Set LED11 level
 *
 * Sets output level on a pin
 *
 * \param[in] level true  = Pin level set to "high" state
 *                  false = Pin level set to "low" state
 */
static inline void LED11_set_level(const bool level)
{
	PORTC_set_pin_level(1, level);
}

/**
 * \brief Toggle output level on LED11
 *
 * Toggle the pin level
 */
static inline void LED11_toggle_level()
{
	PORTC_toggle_pin_level(1);
}

/**
 * \brief Get level on LED11
 *
 * Reads the level on a pin
 */
static inline bool LED11_get_level()
{
	return PORTC_get_pin_level(1);
}

/**
 * \brief Set LED10 pull mode
 *
 * Configure pin to pull up, down or disable pull mode, supported pull
 * modes are defined by device used
 *
 * \param[in] pull_mode Pin pull mode
 */
static inline void LED10_set_pull_mode(const enum port_pull_mode pull_mode)
{
	PORTC_set_pin_pull_mode(2, pull_mode);
}

/**
 * \brief Set LED10 data direction
 *
 * Select if the pin data direction is input, output or disabled.
 * If disabled state is not possible, this function throws an assert.
 *
 * \param[in] direction PORT_DIR_IN  = Data direction in
 *                      PORT_DIR_OUT = Data direction out
 *                      PORT_DIR_OFF = Disables the pin
 *                      (low power state)
 */
static inline void LED10_set_dir(const enum port_dir dir)
{
	PORTC_set_pin_dir(2, dir);
}

/**
 * \brief Set LED10 input/sense configuration
 *
 * Enable/disable LED10 digital input buffer and pin change interrupt,
 * select pin interrupt edge/level sensing mode
 *
 * \param[in] isc PORT_ISC_INTDISABLE_gc    = Iterrupt disabled but input buffer enabled
 *                PORT_ISC_BOTHEDGES_gc     = Sense Both Edges
 *                PORT_ISC_RISING_gc        = Sense Rising Edge
 *                PORT_ISC_FALLING_gc       = Sense Falling Edge
 *                PORT_ISC_INPUT_DISABLE_gc = Digital Input Buffer disabled
 *                PORT_ISC_LEVEL_gc         = Sense low Level
 */
static inline void LED10_set_isc(const PORT_ISC_t isc)
{
	PORTC_pin_set_isc(2, isc);
}

/**
 * \brief Set LED10 inverted mode
 *
 * Enable or disable inverted I/O on a pin
 *
 * \param[in] inverted true  = I/O on LED10 is inverted
 *                     false = I/O on LED10 is not inverted
 */
static inline void LED10_set_inverted(const bool inverted)
{
	PORTC_pin_set_inverted(2, inverted);
}

/**
 * \brief Set LED10 level
 *
 * Sets output level on a pin
 *
 * \param[in] level true  = Pin level set to "high" state
 *                  false = Pin level set to "low" state
 */
static inline void LED10_set_level(const bool level)
{
	PORTC_set_pin_level(2, level);
}

/**
 * \brief Toggle output level on LED10
 *
 * Toggle the pin level
 */
static inline void LED10_toggle_level()
{
	PORTC_toggle_pin_level(2);
}

/**
 * \brief Get level on LED10
 *
 * Reads the level on a pin
 */
static inline bool LED10_get_level()
{
	return PORTC_get_pin_level(2);
}

/**
 * \brief Set LED9 pull mode
 *
 * Configure pin to pull up, down or disable pull mode, supported pull
 * modes are defined by device used
 *
 * \param[in] pull_mode Pin pull mode
 */
static inline void LED9_set_pull_mode(const enum port_pull_mode pull_mode)
{
	PORTC_set_pin_pull_mode(3, pull_mode);
}

/**
 * \brief Set LED9 data direction
 *
 * Select if the pin data direction is input, output or disabled.
 * If disabled state is not possible, this function throws an assert.
 *
 * \param[in] direction PORT_DIR_IN  = Data direction in
 *                      PORT_DIR_OUT = Data direction out
 *                      PORT_DIR_OFF = Disables the pin
 *                      (low power state)
 */
static inline void LED9_set_dir(const enum port_dir dir)
{
	PORTC_set_pin_dir(3, dir);
}

/**
 * \brief Set LED9 input/sense configuration
 *
 * Enable/disable LED9 digital input buffer and pin change interrupt,
 * select pin interrupt edge/level sensing mode
 *
 * \param[in] isc PORT_ISC_INTDISABLE_gc    = Iterrupt disabled but input buffer enabled
 *                PORT_ISC_BOTHEDGES_gc     = Sense Both Edges
 *                PORT_ISC_RISING_gc        = Sense Rising Edge
 *                PORT_ISC_FALLING_gc       = Sense Falling Edge
 *                PORT_ISC_INPUT_DISABLE_gc = Digital Input Buffer disabled
 *                PORT_ISC_LEVEL_gc         = Sense low Level
 */
static inline void LED9_set_isc(const PORT_ISC_t isc)
{
	PORTC_pin_set_isc(3, isc);
}

/**
 * \brief Set LED9 inverted mode
 *
 * Enable or disable inverted I/O on a pin
 *
 * \param[in] inverted true  = I/O on LED9 is inverted
 *                     false = I/O on LED9 is not inverted
 */
static inline void LED9_set_inverted(const bool inverted)
{
	PORTC_pin_set_inverted(3, inverted);
}

/**
 * \brief Set LED9 level
 *
 * Sets output level on a pin
 *
 * \param[in] level true  = Pin level set to "high" state
 *                  false = Pin level set to "low" state
 */
static inline void LED9_set_level(const bool level)
{
	PORTC_set_pin_level(3, level);
}

/**
 * \brief Toggle output level on LED9
 *
 * Toggle the pin level
 */
static inline void LED9_toggle_level()
{
	PORTC_toggle_pin_level(3);
}

/**
 * \brief Get level on LED9
 *
 * Reads the level on a pin
 */
static inline bool LED9_get_level()
{
	return PORTC_get_pin_level(3);
}

/**
 * \brief Set LED8 pull mode
 *
 * Configure pin to pull up, down or disable pull mode, supported pull
 * modes are defined by device used
 *
 * \param[in] pull_mode Pin pull mode
 */
static inline void LED8_set_pull_mode(const enum port_pull_mode pull_mode)
{
	PORTC_set_pin_pull_mode(4, pull_mode);
}

/**
 * \brief Set LED8 data direction
 *
 * Select if the pin data direction is input, output or disabled.
 * If disabled state is not possible, this function throws an assert.
 *
 * \param[in] direction PORT_DIR_IN  = Data direction in
 *                      PORT_DIR_OUT = Data direction out
 *                      PORT_DIR_OFF = Disables the pin
 *                      (low power state)
 */
static inline void LED8_set_dir(const enum port_dir dir)
{
	PORTC_set_pin_dir(4, dir);
}

/**
 * \brief Set LED8 input/sense configuration
 *
 * Enable/disable LED8 digital input buffer and pin change interrupt,
 * select pin interrupt edge/level sensing mode
 *
 * \param[in] isc PORT_ISC_INTDISABLE_gc    = Iterrupt disabled but input buffer enabled
 *                PORT_ISC_BOTHEDGES_gc     = Sense Both Edges
 *                PORT_ISC_RISING_gc        = Sense Rising Edge
 *                PORT_ISC_FALLING_gc       = Sense Falling Edge
 *                PORT_ISC_INPUT_DISABLE_gc = Digital Input Buffer disabled
 *                PORT_ISC_LEVEL_gc         = Sense low Level
 */
static inline void LED8_set_isc(const PORT_ISC_t isc)
{
	PORTC_pin_set_isc(4, isc);
}

/**
 * \brief Set LED8 inverted mode
 *
 * Enable or disable inverted I/O on a pin
 *
 * \param[in] inverted true  = I/O on LED8 is inverted
 *                     false = I/O on LED8 is not inverted
 */
static inline void LED8_set_inverted(const bool inverted)
{
	PORTC_pin_set_inverted(4, inverted);
}

/**
 * \brief Set LED8 level
 *
 * Sets output level on a pin
 *
 * \param[in] level true  = Pin level set to "high" state
 *                  false = Pin level set to "low" state
 */
static inline void LED8_set_level(const bool level)
{
	PORTC_set_pin_level(4, level);
}

/**
 * \brief Toggle output level on LED8
 *
 * Toggle the pin level
 */
static inline void LED8_toggle_level()
{
	PORTC_toggle_pin_level(4);
}

/**
 * \brief Get level on LED8
 *
 * Reads the level on a pin
 */
static inline bool LED8_get_level()
{
	return PORTC_get_pin_level(4);
}

/**
 * \brief Set LED7 pull mode
 *
 * Configure pin to pull up, down or disable pull mode, supported pull
 * modes are defined by device used
 *
 * \param[in] pull_mode Pin pull mode
 */
static inline void LED7_set_pull_mode(const enum port_pull_mode pull_mode)
{
	PORTD_set_pin_pull_mode(0, pull_mode);
}

/**
 * \brief Set LED7 data direction
 *
 * Select if the pin data direction is input, output or disabled.
 * If disabled state is not possible, this function throws an assert.
 *
 * \param[in] direction PORT_DIR_IN  = Data direction in
 *                      PORT_DIR_OUT = Data direction out
 *                      PORT_DIR_OFF = Disables the pin
 *                      (low power state)
 */
static inline void LED7_set_dir(const enum port_dir dir)
{
	PORTD_set_pin_dir(0, dir);
}

/**
 * \brief Set LED7 input/sense configuration
 *
 * Enable/disable LED7 digital input buffer and pin change interrupt,
 * select pin interrupt edge/level sensing mode
 *
 * \param[in] isc PORT_ISC_INTDISABLE_gc    = Iterrupt disabled but input buffer enabled
 *                PORT_ISC_BOTHEDGES_gc     = Sense Both Edges
 *                PORT_ISC_RISING_gc        = Sense Rising Edge
 *                PORT_ISC_FALLING_gc       = Sense Falling Edge
 *                PORT_ISC_INPUT_DISABLE_gc = Digital Input Buffer disabled
 *                PORT_ISC_LEVEL_gc         = Sense low Level
 */
static inline void LED7_set_isc(const PORT_ISC_t isc)
{
	PORTD_pin_set_isc(0, isc);
}

/**
 * \brief Set LED7 inverted mode
 *
 * Enable or disable inverted I/O on a pin
 *
 * \param[in] inverted true  = I/O on LED7 is inverted
 *                     false = I/O on LED7 is not inverted
 */
static inline void LED7_set_inverted(const bool inverted)
{
	PORTD_pin_set_inverted(0, inverted);
}

/**
 * \brief Set LED7 level
 *
 * Sets output level on a pin
 *
 * \param[in] level true  = Pin level set to "high" state
 *                  false = Pin level set to "low" state
 */
static inline void LED7_set_level(const bool level)
{
	PORTD_set_pin_level(0, level);
}

/**
 * \brief Toggle output level on LED7
 *
 * Toggle the pin level
 */
static inline void LED7_toggle_level()
{
	PORTD_toggle_pin_level(0);
}

/**
 * \brief Get level on LED7
 *
 * Reads the level on a pin
 */
static inline bool LED7_get_level()
{
	return PORTD_get_pin_level(0);
}

/**
 * \brief Set LED18 pull mode
 *
 * Configure pin to pull up, down or disable pull mode, supported pull
 * modes are defined by device used
 *
 * \param[in] pull_mode Pin pull mode
 */
static inline void LED18_set_pull_mode(const enum port_pull_mode pull_mode)
{
	PORTD_set_pin_pull_mode(4, pull_mode);
}

/**
 * \brief Set LED18 data direction
 *
 * Select if the pin data direction is input, output or disabled.
 * If disabled state is not possible, this function throws an assert.
 *
 * \param[in] direction PORT_DIR_IN  = Data direction in
 *                      PORT_DIR_OUT = Data direction out
 *                      PORT_DIR_OFF = Disables the pin
 *                      (low power state)
 */
static inline void LED18_set_dir(const enum port_dir dir)
{
	PORTD_set_pin_dir(4, dir);
}

/**
 * \brief Set LED18 input/sense configuration
 *
 * Enable/disable LED18 digital input buffer and pin change interrupt,
 * select pin interrupt edge/level sensing mode
 *
 * \param[in] isc PORT_ISC_INTDISABLE_gc    = Iterrupt disabled but input buffer enabled
 *                PORT_ISC_BOTHEDGES_gc     = Sense Both Edges
 *                PORT_ISC_RISING_gc        = Sense Rising Edge
 *                PORT_ISC_FALLING_gc       = Sense Falling Edge
 *                PORT_ISC_INPUT_DISABLE_gc = Digital Input Buffer disabled
 *                PORT_ISC_LEVEL_gc         = Sense low Level
 */
static inline void LED18_set_isc(const PORT_ISC_t isc)
{
	PORTD_pin_set_isc(4, isc);
}

/**
 * \brief Set LED18 inverted mode
 *
 * Enable or disable inverted I/O on a pin
 *
 * \param[in] inverted true  = I/O on LED18 is inverted
 *                     false = I/O on LED18 is not inverted
 */
static inline void LED18_set_inverted(const bool inverted)
{
	PORTD_pin_set_inverted(4, inverted);
}

/**
 * \brief Set LED18 level
 *
 * Sets output level on a pin
 *
 * \param[in] level true  = Pin level set to "high" state
 *                  false = Pin level set to "low" state
 */
static inline void LED18_set_level(const bool level)
{
	PORTD_set_pin_level(4, level);
}

/**
 * \brief Toggle output level on LED18
 *
 * Toggle the pin level
 */
static inline void LED18_toggle_level()
{
	PORTD_toggle_pin_level(4);
}

/**
 * \brief Get level on LED18
 *
 * Reads the level on a pin
 */
static inline bool LED18_get_level()
{
	return PORTD_get_pin_level(4);
}

/**
 * \brief Set LED17 pull mode
 *
 * Configure pin to pull up, down or disable pull mode, supported pull
 * modes are defined by device used
 *
 * \param[in] pull_mode Pin pull mode
 */
static inline void LED17_set_pull_mode(const enum port_pull_mode pull_mode)
{
	PORTD_set_pin_pull_mode(5, pull_mode);
}

/**
 * \brief Set LED17 data direction
 *
 * Select if the pin data direction is input, output or disabled.
 * If disabled state is not possible, this function throws an assert.
 *
 * \param[in] direction PORT_DIR_IN  = Data direction in
 *                      PORT_DIR_OUT = Data direction out
 *                      PORT_DIR_OFF = Disables the pin
 *                      (low power state)
 */
static inline void LED17_set_dir(const enum port_dir dir)
{
	PORTD_set_pin_dir(5, dir);
}

/**
 * \brief Set LED17 input/sense configuration
 *
 * Enable/disable LED17 digital input buffer and pin change interrupt,
 * select pin interrupt edge/level sensing mode
 *
 * \param[in] isc PORT_ISC_INTDISABLE_gc    = Iterrupt disabled but input buffer enabled
 *                PORT_ISC_BOTHEDGES_gc     = Sense Both Edges
 *                PORT_ISC_RISING_gc        = Sense Rising Edge
 *                PORT_ISC_FALLING_gc       = Sense Falling Edge
 *                PORT_ISC_INPUT_DISABLE_gc = Digital Input Buffer disabled
 *                PORT_ISC_LEVEL_gc         = Sense low Level
 */
static inline void LED17_set_isc(const PORT_ISC_t isc)
{
	PORTD_pin_set_isc(5, isc);
}

/**
 * \brief Set LED17 inverted mode
 *
 * Enable or disable inverted I/O on a pin
 *
 * \param[in] inverted true  = I/O on LED17 is inverted
 *                     false = I/O on LED17 is not inverted
 */
static inline void LED17_set_inverted(const bool inverted)
{
	PORTD_pin_set_inverted(5, inverted);
}

/**
 * \brief Set LED17 level
 *
 * Sets output level on a pin
 *
 * \param[in] level true  = Pin level set to "high" state
 *                  false = Pin level set to "low" state
 */
static inline void LED17_set_level(const bool level)
{
	PORTD_set_pin_level(5, level);
}

/**
 * \brief Toggle output level on LED17
 *
 * Toggle the pin level
 */
static inline void LED17_toggle_level()
{
	PORTD_toggle_pin_level(5);
}

/**
 * \brief Get level on LED17
 *
 * Reads the level on a pin
 */
static inline bool LED17_get_level()
{
	return PORTD_get_pin_level(5);
}

/**
 * \brief Set LED16 pull mode
 *
 * Configure pin to pull up, down or disable pull mode, supported pull
 * modes are defined by device used
 *
 * \param[in] pull_mode Pin pull mode
 */
static inline void LED16_set_pull_mode(const enum port_pull_mode pull_mode)
{
	PORTD_set_pin_pull_mode(6, pull_mode);
}

/**
 * \brief Set LED16 data direction
 *
 * Select if the pin data direction is input, output or disabled.
 * If disabled state is not possible, this function throws an assert.
 *
 * \param[in] direction PORT_DIR_IN  = Data direction in
 *                      PORT_DIR_OUT = Data direction out
 *                      PORT_DIR_OFF = Disables the pin
 *                      (low power state)
 */
static inline void LED16_set_dir(const enum port_dir dir)
{
	PORTD_set_pin_dir(6, dir);
}

/**
 * \brief Set LED16 input/sense configuration
 *
 * Enable/disable LED16 digital input buffer and pin change interrupt,
 * select pin interrupt edge/level sensing mode
 *
 * \param[in] isc PORT_ISC_INTDISABLE_gc    = Iterrupt disabled but input buffer enabled
 *                PORT_ISC_BOTHEDGES_gc     = Sense Both Edges
 *                PORT_ISC_RISING_gc        = Sense Rising Edge
 *                PORT_ISC_FALLING_gc       = Sense Falling Edge
 *                PORT_ISC_INPUT_DISABLE_gc = Digital Input Buffer disabled
 *                PORT_ISC_LEVEL_gc         = Sense low Level
 */
static inline void LED16_set_isc(const PORT_ISC_t isc)
{
	PORTD_pin_set_isc(6, isc);
}

/**
 * \brief Set LED16 inverted mode
 *
 * Enable or disable inverted I/O on a pin
 *
 * \param[in] inverted true  = I/O on LED16 is inverted
 *                     false = I/O on LED16 is not inverted
 */
static inline void LED16_set_inverted(const bool inverted)
{
	PORTD_pin_set_inverted(6, inverted);
}

/**
 * \brief Set LED16 level
 *
 * Sets output level on a pin
 *
 * \param[in] level true  = Pin level set to "high" state
 *                  false = Pin level set to "low" state
 */
static inline void LED16_set_level(const bool level)
{
	PORTD_set_pin_level(6, level);
}

/**
 * \brief Toggle output level on LED16
 *
 * Toggle the pin level
 */
static inline void LED16_toggle_level()
{
	PORTD_toggle_pin_level(6);
}

/**
 * \brief Get level on LED16
 *
 * Reads the level on a pin
 */
static inline bool LED16_get_level()
{
	return PORTD_get_pin_level(6);
}

/**
 * \brief Set LED15 pull mode
 *
 * Configure pin to pull up, down or disable pull mode, supported pull
 * modes are defined by device used
 *
 * \param[in] pull_mode Pin pull mode
 */
static inline void LED15_set_pull_mode(const enum port_pull_mode pull_mode)
{
	PORTD_set_pin_pull_mode(7, pull_mode);
}

/**
 * \brief Set LED15 data direction
 *
 * Select if the pin data direction is input, output or disabled.
 * If disabled state is not possible, this function throws an assert.
 *
 * \param[in] direction PORT_DIR_IN  = Data direction in
 *                      PORT_DIR_OUT = Data direction out
 *                      PORT_DIR_OFF = Disables the pin
 *                      (low power state)
 */
static inline void LED15_set_dir(const enum port_dir dir)
{
	PORTD_set_pin_dir(7, dir);
}

/**
 * \brief Set LED15 input/sense configuration
 *
 * Enable/disable LED15 digital input buffer and pin change interrupt,
 * select pin interrupt edge/level sensing mode
 *
 * \param[in] isc PORT_ISC_INTDISABLE_gc    = Iterrupt disabled but input buffer enabled
 *                PORT_ISC_BOTHEDGES_gc     = Sense Both Edges
 *                PORT_ISC_RISING_gc        = Sense Rising Edge
 *                PORT_ISC_FALLING_gc       = Sense Falling Edge
 *                PORT_ISC_INPUT_DISABLE_gc = Digital Input Buffer disabled
 *                PORT_ISC_LEVEL_gc         = Sense low Level
 */
static inline void LED15_set_isc(const PORT_ISC_t isc)
{
	PORTD_pin_set_isc(7, isc);
}

/**
 * \brief Set LED15 inverted mode
 *
 * Enable or disable inverted I/O on a pin
 *
 * \param[in] inverted true  = I/O on LED15 is inverted
 *                     false = I/O on LED15 is not inverted
 */
static inline void LED15_set_inverted(const bool inverted)
{
	PORTD_pin_set_inverted(7, inverted);
}

/**
 * \brief Set LED15 level
 *
 * Sets output level on a pin
 *
 * \param[in] level true  = Pin level set to "high" state
 *                  false = Pin level set to "low" state
 */
static inline void LED15_set_level(const bool level)
{
	PORTD_set_pin_level(7, level);
}

/**
 * \brief Toggle output level on LED15
 *
 * Toggle the pin level
 */
static inline void LED15_toggle_level()
{
	PORTD_toggle_pin_level(7);
}

/**
 * \brief Get level on LED15
 *
 * Reads the level on a pin
 */
static inline bool LED15_get_level()
{
	return PORTD_get_pin_level(7);
}

/**
 * \brief Set LED14 pull mode
 *
 * Configure pin to pull up, down or disable pull mode, supported pull
 * modes are defined by device used
 *
 * \param[in] pull_mode Pin pull mode
 */
static inline void LED14_set_pull_mode(const enum port_pull_mode pull_mode)
{
	PORTE_set_pin_pull_mode(0, pull_mode);
}

/**
 * \brief Set LED14 data direction
 *
 * Select if the pin data direction is input, output or disabled.
 * If disabled state is not possible, this function throws an assert.
 *
 * \param[in] direction PORT_DIR_IN  = Data direction in
 *                      PORT_DIR_OUT = Data direction out
 *                      PORT_DIR_OFF = Disables the pin
 *                      (low power state)
 */
static inline void LED14_set_dir(const enum port_dir dir)
{
	PORTE_set_pin_dir(0, dir);
}

/**
 * \brief Set LED14 input/sense configuration
 *
 * Enable/disable LED14 digital input buffer and pin change interrupt,
 * select pin interrupt edge/level sensing mode
 *
 * \param[in] isc PORT_ISC_INTDISABLE_gc    = Iterrupt disabled but input buffer enabled
 *                PORT_ISC_BOTHEDGES_gc     = Sense Both Edges
 *                PORT_ISC_RISING_gc        = Sense Rising Edge
 *                PORT_ISC_FALLING_gc       = Sense Falling Edge
 *                PORT_ISC_INPUT_DISABLE_gc = Digital Input Buffer disabled
 *                PORT_ISC_LEVEL_gc         = Sense low Level
 */
static inline void LED14_set_isc(const PORT_ISC_t isc)
{
	PORTE_pin_set_isc(0, isc);
}

/**
 * \brief Set LED14 inverted mode
 *
 * Enable or disable inverted I/O on a pin
 *
 * \param[in] inverted true  = I/O on LED14 is inverted
 *                     false = I/O on LED14 is not inverted
 */
static inline void LED14_set_inverted(const bool inverted)
{
	PORTE_pin_set_inverted(0, inverted);
}

/**
 * \brief Set LED14 level
 *
 * Sets output level on a pin
 *
 * \param[in] level true  = Pin level set to "high" state
 *                  false = Pin level set to "low" state
 */
static inline void LED14_set_level(const bool level)
{
	PORTE_set_pin_level(0, level);
}

/**
 * \brief Toggle output level on LED14
 *
 * Toggle the pin level
 */
static inline void LED14_toggle_level()
{
	PORTE_toggle_pin_level(0);
}

/**
 * \brief Get level on LED14
 *
 * Reads the level on a pin
 */
static inline bool LED14_get_level()
{
	return PORTE_get_pin_level(0);
}

/**
 * \brief Set LED13 pull mode
 *
 * Configure pin to pull up, down or disable pull mode, supported pull
 * modes are defined by device used
 *
 * \param[in] pull_mode Pin pull mode
 */
static inline void LED13_set_pull_mode(const enum port_pull_mode pull_mode)
{
	PORTE_set_pin_pull_mode(1, pull_mode);
}

/**
 * \brief Set LED13 data direction
 *
 * Select if the pin data direction is input, output or disabled.
 * If disabled state is not possible, this function throws an assert.
 *
 * \param[in] direction PORT_DIR_IN  = Data direction in
 *                      PORT_DIR_OUT = Data direction out
 *                      PORT_DIR_OFF = Disables the pin
 *                      (low power state)
 */
static inline void LED13_set_dir(const enum port_dir dir)
{
	PORTE_set_pin_dir(1, dir);
}

/**
 * \brief Set LED13 input/sense configuration
 *
 * Enable/disable LED13 digital input buffer and pin change interrupt,
 * select pin interrupt edge/level sensing mode
 *
 * \param[in] isc PORT_ISC_INTDISABLE_gc    = Iterrupt disabled but input buffer enabled
 *                PORT_ISC_BOTHEDGES_gc     = Sense Both Edges
 *                PORT_ISC_RISING_gc        = Sense Rising Edge
 *                PORT_ISC_FALLING_gc       = Sense Falling Edge
 *                PORT_ISC_INPUT_DISABLE_gc = Digital Input Buffer disabled
 *                PORT_ISC_LEVEL_gc         = Sense low Level
 */
static inline void LED13_set_isc(const PORT_ISC_t isc)
{
	PORTE_pin_set_isc(1, isc);
}

/**
 * \brief Set LED13 inverted mode
 *
 * Enable or disable inverted I/O on a pin
 *
 * \param[in] inverted true  = I/O on LED13 is inverted
 *                     false = I/O on LED13 is not inverted
 */
static inline void LED13_set_inverted(const bool inverted)
{
	PORTE_pin_set_inverted(1, inverted);
}

/**
 * \brief Set LED13 level
 *
 * Sets output level on a pin
 *
 * \param[in] level true  = Pin level set to "high" state
 *                  false = Pin level set to "low" state
 */
static inline void LED13_set_level(const bool level)
{
	PORTE_set_pin_level(1, level);
}

/**
 * \brief Toggle output level on LED13
 *
 * Toggle the pin level
 */
static inline void LED13_toggle_level()
{
	PORTE_toggle_pin_level(1);
}

/**
 * \brief Get level on LED13
 *
 * Reads the level on a pin
 */
static inline bool LED13_get_level()
{
	return PORTE_get_pin_level(1);
}

/**
 * \brief Set LED24 pull mode
 *
 * Configure pin to pull up, down or disable pull mode, supported pull
 * modes are defined by device used
 *
 * \param[in] pull_mode Pin pull mode
 */
static inline void LED24_set_pull_mode(const enum port_pull_mode pull_mode)
{
	PORTE_set_pin_pull_mode(2, pull_mode);
}

/**
 * \brief Set LED24 data direction
 *
 * Select if the pin data direction is input, output or disabled.
 * If disabled state is not possible, this function throws an assert.
 *
 * \param[in] direction PORT_DIR_IN  = Data direction in
 *                      PORT_DIR_OUT = Data direction out
 *                      PORT_DIR_OFF = Disables the pin
 *                      (low power state)
 */
static inline void LED24_set_dir(const enum port_dir dir)
{
	PORTE_set_pin_dir(2, dir);
}

/**
 * \brief Set LED24 input/sense configuration
 *
 * Enable/disable LED24 digital input buffer and pin change interrupt,
 * select pin interrupt edge/level sensing mode
 *
 * \param[in] isc PORT_ISC_INTDISABLE_gc    = Iterrupt disabled but input buffer enabled
 *                PORT_ISC_BOTHEDGES_gc     = Sense Both Edges
 *                PORT_ISC_RISING_gc        = Sense Rising Edge
 *                PORT_ISC_FALLING_gc       = Sense Falling Edge
 *                PORT_ISC_INPUT_DISABLE_gc = Digital Input Buffer disabled
 *                PORT_ISC_LEVEL_gc         = Sense low Level
 */
static inline void LED24_set_isc(const PORT_ISC_t isc)
{
	PORTE_pin_set_isc(2, isc);
}

/**
 * \brief Set LED24 inverted mode
 *
 * Enable or disable inverted I/O on a pin
 *
 * \param[in] inverted true  = I/O on LED24 is inverted
 *                     false = I/O on LED24 is not inverted
 */
static inline void LED24_set_inverted(const bool inverted)
{
	PORTE_pin_set_inverted(2, inverted);
}

/**
 * \brief Set LED24 level
 *
 * Sets output level on a pin
 *
 * \param[in] level true  = Pin level set to "high" state
 *                  false = Pin level set to "low" state
 */
static inline void LED24_set_level(const bool level)
{
	PORTE_set_pin_level(2, level);
}

/**
 * \brief Toggle output level on LED24
 *
 * Toggle the pin level
 */
static inline void LED24_toggle_level()
{
	PORTE_toggle_pin_level(2);
}

/**
 * \brief Get level on LED24
 *
 * Reads the level on a pin
 */
static inline bool LED24_get_level()
{
	return PORTE_get_pin_level(2);
}

/**
 * \brief Set LED23 pull mode
 *
 * Configure pin to pull up, down or disable pull mode, supported pull
 * modes are defined by device used
 *
 * \param[in] pull_mode Pin pull mode
 */
static inline void LED23_set_pull_mode(const enum port_pull_mode pull_mode)
{
	PORTE_set_pin_pull_mode(3, pull_mode);
}

/**
 * \brief Set LED23 data direction
 *
 * Select if the pin data direction is input, output or disabled.
 * If disabled state is not possible, this function throws an assert.
 *
 * \param[in] direction PORT_DIR_IN  = Data direction in
 *                      PORT_DIR_OUT = Data direction out
 *                      PORT_DIR_OFF = Disables the pin
 *                      (low power state)
 */
static inline void LED23_set_dir(const enum port_dir dir)
{
	PORTE_set_pin_dir(3, dir);
}

/**
 * \brief Set LED23 input/sense configuration
 *
 * Enable/disable LED23 digital input buffer and pin change interrupt,
 * select pin interrupt edge/level sensing mode
 *
 * \param[in] isc PORT_ISC_INTDISABLE_gc    = Iterrupt disabled but input buffer enabled
 *                PORT_ISC_BOTHEDGES_gc     = Sense Both Edges
 *                PORT_ISC_RISING_gc        = Sense Rising Edge
 *                PORT_ISC_FALLING_gc       = Sense Falling Edge
 *                PORT_ISC_INPUT_DISABLE_gc = Digital Input Buffer disabled
 *                PORT_ISC_LEVEL_gc         = Sense low Level
 */
static inline void LED23_set_isc(const PORT_ISC_t isc)
{
	PORTE_pin_set_isc(3, isc);
}

/**
 * \brief Set LED23 inverted mode
 *
 * Enable or disable inverted I/O on a pin
 *
 * \param[in] inverted true  = I/O on LED23 is inverted
 *                     false = I/O on LED23 is not inverted
 */
static inline void LED23_set_inverted(const bool inverted)
{
	PORTE_pin_set_inverted(3, inverted);
}

/**
 * \brief Set LED23 level
 *
 * Sets output level on a pin
 *
 * \param[in] level true  = Pin level set to "high" state
 *                  false = Pin level set to "low" state
 */
static inline void LED23_set_level(const bool level)
{
	PORTE_set_pin_level(3, level);
}

/**
 * \brief Toggle output level on LED23
 *
 * Toggle the pin level
 */
static inline void LED23_toggle_level()
{
	PORTE_toggle_pin_level(3);
}

/**
 * \brief Get level on LED23
 *
 * Reads the level on a pin
 */
static inline bool LED23_get_level()
{
	return PORTE_get_pin_level(3);
}

/**
 * \brief Set LED22 pull mode
 *
 * Configure pin to pull up, down or disable pull mode, supported pull
 * modes are defined by device used
 *
 * \param[in] pull_mode Pin pull mode
 */
static inline void LED22_set_pull_mode(const enum port_pull_mode pull_mode)
{
	PORTF_set_pin_pull_mode(0, pull_mode);
}

/**
 * \brief Set LED22 data direction
 *
 * Select if the pin data direction is input, output or disabled.
 * If disabled state is not possible, this function throws an assert.
 *
 * \param[in] direction PORT_DIR_IN  = Data direction in
 *                      PORT_DIR_OUT = Data direction out
 *                      PORT_DIR_OFF = Disables the pin
 *                      (low power state)
 */
static inline void LED22_set_dir(const enum port_dir dir)
{
	PORTF_set_pin_dir(0, dir);
}

/**
 * \brief Set LED22 input/sense configuration
 *
 * Enable/disable LED22 digital input buffer and pin change interrupt,
 * select pin interrupt edge/level sensing mode
 *
 * \param[in] isc PORT_ISC_INTDISABLE_gc    = Iterrupt disabled but input buffer enabled
 *                PORT_ISC_BOTHEDGES_gc     = Sense Both Edges
 *                PORT_ISC_RISING_gc        = Sense Rising Edge
 *                PORT_ISC_FALLING_gc       = Sense Falling Edge
 *                PORT_ISC_INPUT_DISABLE_gc = Digital Input Buffer disabled
 *                PORT_ISC_LEVEL_gc         = Sense low Level
 */
static inline void LED22_set_isc(const PORT_ISC_t isc)
{
	PORTF_pin_set_isc(0, isc);
}

/**
 * \brief Set LED22 inverted mode
 *
 * Enable or disable inverted I/O on a pin
 *
 * \param[in] inverted true  = I/O on LED22 is inverted
 *                     false = I/O on LED22 is not inverted
 */
static inline void LED22_set_inverted(const bool inverted)
{
	PORTF_pin_set_inverted(0, inverted);
}

/**
 * \brief Set LED22 level
 *
 * Sets output level on a pin
 *
 * \param[in] level true  = Pin level set to "high" state
 *                  false = Pin level set to "low" state
 */
static inline void LED22_set_level(const bool level)
{
	PORTF_set_pin_level(0, level);
}

/**
 * \brief Toggle output level on LED22
 *
 * Toggle the pin level
 */
static inline void LED22_toggle_level()
{
	PORTF_toggle_pin_level(0);
}

/**
 * \brief Get level on LED22
 *
 * Reads the level on a pin
 */
static inline bool LED22_get_level()
{
	return PORTF_get_pin_level(0);
}

/**
 * \brief Set LED21 pull mode
 *
 * Configure pin to pull up, down or disable pull mode, supported pull
 * modes are defined by device used
 *
 * \param[in] pull_mode Pin pull mode
 */
static inline void LED21_set_pull_mode(const enum port_pull_mode pull_mode)
{
	PORTF_set_pin_pull_mode(1, pull_mode);
}

/**
 * \brief Set LED21 data direction
 *
 * Select if the pin data direction is input, output or disabled.
 * If disabled state is not possible, this function throws an assert.
 *
 * \param[in] direction PORT_DIR_IN  = Data direction in
 *                      PORT_DIR_OUT = Data direction out
 *                      PORT_DIR_OFF = Disables the pin
 *                      (low power state)
 */
static inline void LED21_set_dir(const enum port_dir dir)
{
	PORTF_set_pin_dir(1, dir);
}

/**
 * \brief Set LED21 input/sense configuration
 *
 * Enable/disable LED21 digital input buffer and pin change interrupt,
 * select pin interrupt edge/level sensing mode
 *
 * \param[in] isc PORT_ISC_INTDISABLE_gc    = Iterrupt disabled but input buffer enabled
 *                PORT_ISC_BOTHEDGES_gc     = Sense Both Edges
 *                PORT_ISC_RISING_gc        = Sense Rising Edge
 *                PORT_ISC_FALLING_gc       = Sense Falling Edge
 *                PORT_ISC_INPUT_DISABLE_gc = Digital Input Buffer disabled
 *                PORT_ISC_LEVEL_gc         = Sense low Level
 */
static inline void LED21_set_isc(const PORT_ISC_t isc)
{
	PORTF_pin_set_isc(1, isc);
}

/**
 * \brief Set LED21 inverted mode
 *
 * Enable or disable inverted I/O on a pin
 *
 * \param[in] inverted true  = I/O on LED21 is inverted
 *                     false = I/O on LED21 is not inverted
 */
static inline void LED21_set_inverted(const bool inverted)
{
	PORTF_pin_set_inverted(1, inverted);
}

/**
 * \brief Set LED21 level
 *
 * Sets output level on a pin
 *
 * \param[in] level true  = Pin level set to "high" state
 *                  false = Pin level set to "low" state
 */
static inline void LED21_set_level(const bool level)
{
	PORTF_set_pin_level(1, level);
}

/**
 * \brief Toggle output level on LED21
 *
 * Toggle the pin level
 */
static inline void LED21_toggle_level()
{
	PORTF_toggle_pin_level(1);
}

/**
 * \brief Get level on LED21
 *
 * Reads the level on a pin
 */
static inline bool LED21_get_level()
{
	return PORTF_get_pin_level(1);
}

/**
 * \brief Set LED20 pull mode
 *
 * Configure pin to pull up, down or disable pull mode, supported pull
 * modes are defined by device used
 *
 * \param[in] pull_mode Pin pull mode
 */
static inline void LED20_set_pull_mode(const enum port_pull_mode pull_mode)
{
	PORTF_set_pin_pull_mode(2, pull_mode);
}

/**
 * \brief Set LED20 data direction
 *
 * Select if the pin data direction is input, output or disabled.
 * If disabled state is not possible, this function throws an assert.
 *
 * \param[in] direction PORT_DIR_IN  = Data direction in
 *                      PORT_DIR_OUT = Data direction out
 *                      PORT_DIR_OFF = Disables the pin
 *                      (low power state)
 */
static inline void LED20_set_dir(const enum port_dir dir)
{
	PORTF_set_pin_dir(2, dir);
}

/**
 * \brief Set LED20 input/sense configuration
 *
 * Enable/disable LED20 digital input buffer and pin change interrupt,
 * select pin interrupt edge/level sensing mode
 *
 * \param[in] isc PORT_ISC_INTDISABLE_gc    = Iterrupt disabled but input buffer enabled
 *                PORT_ISC_BOTHEDGES_gc     = Sense Both Edges
 *                PORT_ISC_RISING_gc        = Sense Rising Edge
 *                PORT_ISC_FALLING_gc       = Sense Falling Edge
 *                PORT_ISC_INPUT_DISABLE_gc = Digital Input Buffer disabled
 *                PORT_ISC_LEVEL_gc         = Sense low Level
 */
static inline void LED20_set_isc(const PORT_ISC_t isc)
{
	PORTF_pin_set_isc(2, isc);
}

/**
 * \brief Set LED20 inverted mode
 *
 * Enable or disable inverted I/O on a pin
 *
 * \param[in] inverted true  = I/O on LED20 is inverted
 *                     false = I/O on LED20 is not inverted
 */
static inline void LED20_set_inverted(const bool inverted)
{
	PORTF_pin_set_inverted(2, inverted);
}

/**
 * \brief Set LED20 level
 *
 * Sets output level on a pin
 *
 * \param[in] level true  = Pin level set to "high" state
 *                  false = Pin level set to "low" state
 */
static inline void LED20_set_level(const bool level)
{
	PORTF_set_pin_level(2, level);
}

/**
 * \brief Toggle output level on LED20
 *
 * Toggle the pin level
 */
static inline void LED20_toggle_level()
{
	PORTF_toggle_pin_level(2);
}

/**
 * \brief Get level on LED20
 *
 * Reads the level on a pin
 */
static inline bool LED20_get_level()
{
	return PORTF_get_pin_level(2);
}

/**
 * \brief Set LED19 pull mode
 *
 * Configure pin to pull up, down or disable pull mode, supported pull
 * modes are defined by device used
 *
 * \param[in] pull_mode Pin pull mode
 */
static inline void LED19_set_pull_mode(const enum port_pull_mode pull_mode)
{
	PORTF_set_pin_pull_mode(5, pull_mode);
}

/**
 * \brief Set LED19 data direction
 *
 * Select if the pin data direction is input, output or disabled.
 * If disabled state is not possible, this function throws an assert.
 *
 * \param[in] direction PORT_DIR_IN  = Data direction in
 *                      PORT_DIR_OUT = Data direction out
 *                      PORT_DIR_OFF = Disables the pin
 *                      (low power state)
 */
static inline void LED19_set_dir(const enum port_dir dir)
{
	PORTF_set_pin_dir(5, dir);
}

/**
 * \brief Set LED19 input/sense configuration
 *
 * Enable/disable LED19 digital input buffer and pin change interrupt,
 * select pin interrupt edge/level sensing mode
 *
 * \param[in] isc PORT_ISC_INTDISABLE_gc    = Iterrupt disabled but input buffer enabled
 *                PORT_ISC_BOTHEDGES_gc     = Sense Both Edges
 *                PORT_ISC_RISING_gc        = Sense Rising Edge
 *                PORT_ISC_FALLING_gc       = Sense Falling Edge
 *                PORT_ISC_INPUT_DISABLE_gc = Digital Input Buffer disabled
 *                PORT_ISC_LEVEL_gc         = Sense low Level
 */
static inline void LED19_set_isc(const PORT_ISC_t isc)
{
	PORTF_pin_set_isc(5, isc);
}

/**
 * \brief Set LED19 inverted mode
 *
 * Enable or disable inverted I/O on a pin
 *
 * \param[in] inverted true  = I/O on LED19 is inverted
 *                     false = I/O on LED19 is not inverted
 */
static inline void LED19_set_inverted(const bool inverted)
{
	PORTF_pin_set_inverted(5, inverted);
}

/**
 * \brief Set LED19 level
 *
 * Sets output level on a pin
 *
 * \param[in] level true  = Pin level set to "high" state
 *                  false = Pin level set to "low" state
 */
static inline void LED19_set_level(const bool level)
{
	PORTF_set_pin_level(5, level);
}

/**
 * \brief Toggle output level on LED19
 *
 * Toggle the pin level
 */
static inline void LED19_toggle_level()
{
	PORTF_toggle_pin_level(5);
}

/**
 * \brief Get level on LED19
 *
 * Reads the level on a pin
 */
static inline bool LED19_get_level()
{
	return PORTF_get_pin_level(5);
}

/**
 * \brief Set LED6 pull mode
 *
 * Configure pin to pull up, down or disable pull mode, supported pull
 * modes are defined by device used
 *
 * \param[in] pull_mode Pin pull mode
 */
static inline void LED6_set_pull_mode(const enum port_pull_mode pull_mode)
{
	PORTF_set_pin_pull_mode(6, pull_mode);
}

/**
 * \brief Set LED6 data direction
 *
 * Select if the pin data direction is input, output or disabled.
 * If disabled state is not possible, this function throws an assert.
 *
 * \param[in] direction PORT_DIR_IN  = Data direction in
 *                      PORT_DIR_OUT = Data direction out
 *                      PORT_DIR_OFF = Disables the pin
 *                      (low power state)
 */
static inline void LED6_set_dir(const enum port_dir dir)
{
	PORTF_set_pin_dir(6, dir);
}

/**
 * \brief Set LED6 input/sense configuration
 *
 * Enable/disable LED6 digital input buffer and pin change interrupt,
 * select pin interrupt edge/level sensing mode
 *
 * \param[in] isc PORT_ISC_INTDISABLE_gc    = Iterrupt disabled but input buffer enabled
 *                PORT_ISC_BOTHEDGES_gc     = Sense Both Edges
 *                PORT_ISC_RISING_gc        = Sense Rising Edge
 *                PORT_ISC_FALLING_gc       = Sense Falling Edge
 *                PORT_ISC_INPUT_DISABLE_gc = Digital Input Buffer disabled
 *                PORT_ISC_LEVEL_gc         = Sense low Level
 */
static inline void LED6_set_isc(const PORT_ISC_t isc)
{
	PORTF_pin_set_isc(6, isc);
}

/**
 * \brief Set LED6 inverted mode
 *
 * Enable or disable inverted I/O on a pin
 *
 * \param[in] inverted true  = I/O on LED6 is inverted
 *                     false = I/O on LED6 is not inverted
 */
static inline void LED6_set_inverted(const bool inverted)
{
	PORTF_pin_set_inverted(6, inverted);
}

/**
 * \brief Set LED6 level
 *
 * Sets output level on a pin
 *
 * \param[in] level true  = Pin level set to "high" state
 *                  false = Pin level set to "low" state
 */
static inline void LED6_set_level(const bool level)
{
	PORTF_set_pin_level(6, level);
}

/**
 * \brief Toggle output level on LED6
 *
 * Toggle the pin level
 */
static inline void LED6_toggle_level()
{
	PORTF_toggle_pin_level(6);
}

/**
 * \brief Get level on LED6
 *
 * Reads the level on a pin
 */
static inline bool LED6_get_level()
{
	return PORTF_get_pin_level(6);
}

#endif /* ATMEL_START_PINS_H_INCLUDED */
