thedarknet/darknet8-badge/Prototype1/hardware/docs/HARDWARE/SPI/spi.c

#include "spi.h"
#include "usart.h"

//以下是SPI模块的初始化代码，配置成主机模式，访问SD Card/W25X16/24L01/JF24C							  
//SPI口初始化
//这里针是对SPI2的初始化

 void SPI1_Init(void)
{
 	GPIO_InitTypeDef GPIO_InitStructure;
  	SPI_InitTypeDef  SPI_InitStructure;

	RCC_APB2PeriphClockCmd(	RCC_APB2Periph_GPIOA, ENABLE );//PORTA时钟使能 
	RCC_APB2PeriphClockCmd(	RCC_APB2Periph_SPI1,  ENABLE );//SPI1时钟使能 	
 
	GPIO_InitStructure.GPIO_Pin = GPIO_Pin_5 | GPIO_Pin_7 ;	  //Pin_5 sck  pin7 MOSI
	GPIO_InitStructure.GPIO_Mode = GPIO_Mode_AF_PP;  //PA5/7/复用推挽输出 
	GPIO_InitStructure.GPIO_Speed = GPIO_Speed_50MHz;
	GPIO_Init(GPIOA, &GPIO_InitStructure);

	GPIO_InitStructure.GPIO_Pin = GPIO_Pin_4;  
    GPIO_InitStructure.GPIO_Speed = GPIO_Speed_50MHz; 
    GPIO_InitStructure.GPIO_Mode = GPIO_Mode_Out_PP; 
    GPIO_Init(GPIOA, &GPIO_InitStructure);
	GPIO_ResetBits(GPIOA, GPIO_Pin_4);//PA4	CS

	GPIO_InitStructure.GPIO_Pin = GPIO_Pin_4;  
    GPIO_InitStructure.GPIO_Speed = GPIO_Speed_50MHz; 
    GPIO_InitStructure.GPIO_Mode = GPIO_Mode_Out_PP; 
    GPIO_Init(GPIOC, &GPIO_InitStructure);
	GPIO_ResetBits(GPIOC, GPIO_Pin_4);//PC4	DC

	GPIO_InitStructure.GPIO_Pin = GPIO_Pin_0;  
    GPIO_InitStructure.GPIO_Speed = GPIO_Speed_50MHz; 
    GPIO_InitStructure.GPIO_Mode = GPIO_Mode_Out_PP; 
    GPIO_Init(GPIOB, &GPIO_InitStructure);
	GPIO_ResetBits(GPIOB, GPIO_Pin_0);//PB0	LCD_RST



 //	GPIO_SetBits(GPIOA,GPIO_Pin_5|GPIO_Pin_7);  //PB13/14/15上拉

	SPI_InitStructure.SPI_Direction = SPI_Direction_2Lines_FullDuplex;  //设置SPI单向或者双向的数据模式:SPI设置为双线双向全双工  SPI_Direction_1Line_Tx
	SPI_InitStructure.SPI_Mode = SPI_Mode_Master;		//设置SPI工作模式:设置为主SPI
	SPI_InitStructure.SPI_DataSize = SPI_DataSize_8b;		//设置SPI的数据大小:SPI发送接收8位帧结构
	SPI_InitStructure.SPI_CPOL = SPI_CPOL_High;		//选择了串行时钟的稳态:时钟悬空高
	SPI_InitStructure.SPI_CPHA = SPI_CPHA_2Edge;	//数据捕获于第二个时钟沿
	SPI_InitStructure.SPI_NSS = SPI_NSS_Soft;		//NSS信号由硬件（NSS管脚）还是软件（使用SSI位）管理:内部NSS信号有SSI位控制
	SPI_InitStructure.SPI_BaudRatePrescaler =SPI_BaudRatePrescaler_2;		//定义波特率预分频的值:波特率预分频值为16
	SPI_InitStructure.SPI_FirstBit = SPI_FirstBit_MSB;	//指定数据传输从MSB位还是LSB位开始:数据传输从MSB位开始
	SPI_InitStructure.SPI_CRCPolynomial = 7;	//CRC值计算的多项式
	SPI_Init(SPI1, &SPI_InitStructure);  //根据SPI_InitStruct中指定的参数初始化外设SPIx寄存器
 
	SPI_Cmd(SPI1, ENABLE); //使能SPI外设
	
	//SPI2_ReadWriteByte(0xff);//启动传输	 


//	SPI1_SetSpeed(SPI_BaudRatePrescaler_256);//设置为18M时钟,高速模式

  //SPI 速度设置函数
//SpeedSet:
//SPI_BaudRatePrescaler_2   2分频   (SPI 36M@sys 72M)
//SPI_BaudRatePrescaler_8   8分频   (SPI 9M@sys 72M)
//SPI_BaudRatePrescaler_16  16分频  (SPI 4.5M@sys 72M)
//SPI_BaudRatePrescaler_256 256分频 (SPI 281.25K@sys 72M)
} 
void SPI2_Init(void)
{
 	GPIO_InitTypeDef GPIO_InitStructure;
  	SPI_InitTypeDef  SPI_InitStructure;

	RCC_APB2PeriphClockCmd(	RCC_APB2Periph_GPIOB, ENABLE );//PORTB时钟使能 
	RCC_APB1PeriphClockCmd(	RCC_APB1Periph_SPI2,  ENABLE );//SPI2时钟使能 	
 
	GPIO_InitStructure.GPIO_Pin = GPIO_Pin_13 | GPIO_Pin_14 | GPIO_Pin_15;
	GPIO_InitStructure.GPIO_Mode = GPIO_Mode_AF_PP;  //PB13/14/15复用推挽输出 
	GPIO_InitStructure.GPIO_Speed = GPIO_Speed_50MHz;
	GPIO_Init(GPIOB, &GPIO_InitStructure);

 	GPIO_SetBits(GPIOB,GPIO_Pin_13|GPIO_Pin_14|GPIO_Pin_15);  //PB13/14/15上拉

	SPI_InitStructure.SPI_Direction = SPI_Direction_2Lines_FullDuplex;  //设置SPI单向或者双向的数据模式:SPI设置为双线双向全双工
	SPI_InitStructure.SPI_Mode = SPI_Mode_Master;		//设置SPI工作模式:设置为主SPI
	SPI_InitStructure.SPI_DataSize = SPI_DataSize_8b;		//设置SPI的数据大小:SPI发送接收8位帧结构
	SPI_InitStructure.SPI_CPOL = SPI_CPOL_High;		//选择了串行时钟的稳态:时钟悬空高
	SPI_InitStructure.SPI_CPHA = SPI_CPHA_2Edge;	//数据捕获于第二个时钟沿
	SPI_InitStructure.SPI_NSS = SPI_NSS_Soft;		//NSS信号由硬件（NSS管脚）还是软件（使用SSI位）管理:内部NSS信号有SSI位控制
	SPI_InitStructure.SPI_BaudRatePrescaler = SPI_BaudRatePrescaler_16;		//定义波特率预分频的值:波特率预分频值为16
	SPI_InitStructure.SPI_FirstBit = SPI_FirstBit_MSB;	//指定数据传输从MSB位还是LSB位开始:数据传输从MSB位开始
	SPI_InitStructure.SPI_CRCPolynomial = 7;	//CRC值计算的多项式
	SPI_Init(SPI2, &SPI_InitStructure);  //根据SPI_InitStruct中指定的参数初始化外设SPIx寄存器
 
	SPI_Cmd(SPI2, ENABLE); //使能SPI外设
	
	SPI2_ReadWriteByte(0xff);//启动传输	 

}   
//SPI 速度设置函数
//SpeedSet:
//SPI_BaudRatePrescaler_2   2分频   (SPI 36M@sys 72M)
//SPI_BaudRatePrescaler_8   8分频   (SPI 9M@sys 72M)
//SPI_BaudRatePrescaler_16  16分频  (SPI 4.5M@sys 72M)
//SPI_BaudRatePrescaler_256 256分频 (SPI 281.25K@sys 72M)
  
void SPI2_SetSpeed(u8 SpeedSet)
{
	SPI2->CR1&=0XFFC7; 
	SPI2->CR1|=SpeedSet;
	SPI_Cmd(SPI2,ENABLE); 
} 

//SPIx 读写一个字节
//TxData:要写入的字节
//返回值:读取到的字节
u8 SPI2_ReadWriteByte(u8 TxData)
{		
	u8 retry=0;				 	
	while (SPI_I2S_GetFlagStatus(SPI2, SPI_I2S_FLAG_TXE) == RESET) //检查指定的SPI标志位设置与否:发送缓存空标志位
		{
		retry++;
		if(retry>200)return 0;
		}			  
	SPI_I2S_SendData(SPI2, TxData); //通过外设SPIx发送一个数据
	retry=0;

	while (SPI_I2S_GetFlagStatus(SPI2, SPI_I2S_FLAG_RXNE) == RESET)//检查指定的SPI标志位设置与否:接受缓存非空标志位
		{
		retry++;
		if(retry>200)return 0;
		}	  						    
	return SPI_I2S_ReceiveData(SPI2); //返回通过SPIx最近接收的数据					    
}
u8 SPI_WriteByte(SPI_TypeDef* SPIx,u8 Byte)
{
	while((SPIx->SR&SPI_I2S_FLAG_TXE)==RESET);		//等待发送区空	  
	SPIx->DR=Byte;	 	//发送一个byte   
	while((SPIx->SR&SPI_I2S_FLAG_RXNE)==RESET);//等待接收完一个byte  
	return SPIx->DR;          	     //返回收到的数据			
}
