thedarknet/darknet8-badge/Prototype1/hardware/docs/HARDWARE/SPI/spi.h

#ifndef __SPI_H
#define __SPI_H
#include "sys.h"
//////////////////////////////////////////////////////////////////////////////////	 
//本程序只供学习使用，未经作者许可，不得用于其它任何用途
//Mini STM32开发板
//SPI 驱动函数	   
//正点原子@ALIENTEK
//技术论坛:www.openedv.com
//修改日期:2010/6/13 
//版本：V1.0
//版权所有，盗版必究。
//Copyright(C) 正点原子 2009-2019
//All rights reserved
////////////////////////////////////////////////////////////////////////////////// 	  
										  
void SPI2_Init(void);			 //初始化SPI口
void SPI2_SetSpeed(u8 SpeedSet); //设置SPI速度   
u8 SPI2_ReadWriteByte(u8 TxData);//SPI总线读写一个字节
u8 SPI_WriteByte(SPI_TypeDef* SPIx,u8 Byte);
void SPI1_Init(void);
 		 
#endif
