thedarknet/darknet8-badge/(commit log)

2018-12-30 early hardware prototype
    [prototype1.sch]
2019-01-04 only FPGA left (I think) and a bunch of new reference material
    [prototype1.sch]
2019-01-05 starting dev board layout
    [prototype1.brd, prototype1.sch]
2019-01-07 initial prototype board design complete will use this one on bantam
    [prototype1-with-charging-circut.brd, prototype1-with-charging-circut.sch, prototype1.brd]
2019-01-07 adding bantam plans as I'm getting very different milling times when plath is calced on my desktop vs my POS laptop I run the cnc with.
2019-01-21 breakout board without ftdi chip ready for bantam
    [ft2232h-breakout.sch, prototype1-ftdi-as-breakout.brd, prototype1-ftdi-as-breakout.sch]
2019-01-21 added logo and fixed drc error
    [prototype1-ftdi-as-breakout.brd, prototype1-ftdi-as-breakout.sch]
2019-01-25 updated breakout board
    [ft2232h-breakout.brd, ft2232h-breakout.sch, prototype1.brd, prototype1.sch]
2019-01-27 made outside traces a bit thicker
    [ft2232h-breakout-with-ground-planesch.brd, ft2232h-breakout-with-ground-planesch.sch]
2019-01-27 a bit more room between traces
    [prototype1.brd]
2019-02-04 adding voltera files for solder
    [copper_bottom.GBL, copper_top.GTL, profile.GKO, silkscreen_bottom.GBO, silkscreen_top.GTO, soldermask_bottom.GBS, soldermask_top.GTS, solderpaste_bottom.GBP]
2019-02-04 added bom
2019-02-17 adding docs
    [ft2232h-breakout-with-ground-planesch.brd, prototype1.brd, prototype1.sch]
2019-02-22 started prototype 2 board
    [prototype2.sch]
2019-02-23 prototype 2 schema done(?)
    [prototype2.sch]
2019-02-23 fixed erc errors and warnings
    [prototype2.sch]
2019-02-23 fixed one more warning
    [prototype2.sch]
2019-02-25 prototype 2 board design 'complete'
    [prototype2.brd, prototype2.sch]
2019-02-26 removed top ground plane because bantam tools HATES that
    [prototype2-only-bot-ground-plane.brd, prototype2-only-bot-ground-plane.sch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]
2019-02-27 shorten board a bit so it fits on a 3x4 f4 board
    [prototype2-only-bot-ground-plane.brd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]
2019-02-27 removing bad file location and fixing a missing ground
    [prototype2-only-bot-ground-plane.brd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]
2019-02-27 adding voltera files back
    [copper_bottom.GBL, copper_top.GTL, profile.GKO, silkscreen_bottom.GBO, silkscreen_top.GTO, soldermask_bottom.GBS, soldermask_top.GTS, solderpaste_bottom.GBP]
2019-03-07 increased width of traces and tried a different package for slide switch
    [DC27-bottom.brd, DC27-bottom.sch, DC27-top.brd, DC27-top.sch, prototype2-only-bot-ground-plane.brd, prototype2-only-bot-ground-plane.sch]
2019-03-14 fixed bug with center ground plane on esp32
    [prototype2-only-bot-ground-plane.brd, prototype2-only-bot-ground-plane.sch, prototype2.brd, prototype2.sch]
2019-03-20 removed inputs to output pins....duh
    [DC27-bottom.sch, prototype2-only-bot-ground-plane.brd, prototype2-only-bot-ground-plane.sch, prototype2.brd, prototype2.sch]
2019-03-30 moving over schema
    [DC27-bottom.brd, DC27-bottom.sch]
2019-04-01 dc27 board started for darknet 8
    [DC27-bottom.brd, DC27-bottom.sch]
2019-04-02 adding basic layout dc27 badge
    [DC27-bottom.brd, DC27-top.brd]
2019-04-03 started on changes to not charlie plex the leds
    [DC27-bottom.brd, DC27-bottom.sch, DC27-top.brd, DC27-top.sch]
2019-04-04 top board farther, made a breakout board for new led driver
    [DC27-top.brd, breakout-ledpca9956b.brd, breakout-ledpca9956b.sch]
2019-04-05 basic layout nearly done
    [DC27-bottom.brd, DC27-bottom.sch, DC27-top.brd, DC27-top.sch]
2019-04-05 adding apa102c
    [DC27-top.brd]
2019-04-08 top board nearly complete
    [DC27-top.brd, DC27-top.sch]
2019-04-12 nearly done
    [DC27-bottom.brd, DC27-top.brd]
2019-04-13 fix initialization ording, pairing works with a pre-configured key
    [ble.cpp]
2019-04-14 can boop serial profile from serial app on phone. echo not working yet
    [ble.cpp]
2019-04-14 what should be sent to pcbway
    [DC27-bottom.brd, DC27-bottom.sch, DC27-top.brd, DC27-top.sch]
2019-04-27 Fixed artwork
    Fixed artwork which got mangled by Eagle's Push and shove routing
    [DC27-bottom.brd, DC27-top.brd, DC27-top.sch]
2019-04-27 Fixed copper ground planes
    Fixed copper ground planes
    [DC27-bottom.brd, DC27-bottom.sch, DC27-top.brd]
2019-04-28 moved top cutout for lcd down by 1 mm
    [DC27-top.brd]
2019-05-05 removed apa 102s from top board swapped led driver for atmega4089 put on programming pads bottom board adding paring headers on bottom board added 1206 56 OHM resistors to each LED top board pulled o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
    [DC27-bottom.brd, DC27-bottom.sch, DC27-top.brd, DC27-top.sch]
2019-05-05 moved pairing headers back so they don't stick out
    [DC27-bottom.brd, DC27-bottom.sch, breakout-ledpca9956b.brd, breakout-ledpca9956b.sch, prototype2-whole-through-usb.brd, prototype2-whole-through-usb.sch]
2019-05-05 tweaked position of the led 7 and 8 to be at same Y as the right eye (+/- .1 mm) rerouted trace so it does not go between resistor on bottom board
    [DC27-bottom.brd, DC27-top.brd]
2019-05-05 minor text changes
    [DC27-bottom.brd, DC27-top.brd]
2019-05-06 moved JST down and to the left
    [DC27-bottom.brd]
2019-05-06 put hole in board just incase we have to mount battery to back
    [DC27-bottom.brd]
2019-05-16 adding docs and breakouts
    [atmega4089-breakout.brd, atmega4089-breakout.sch, breakout-ledpca9956b.brd, breakout-ledpca9956b.sch, touch-config.txt]
2019-05-19 Update DC27-bottom.brd
    additional puzzle updates
    [DC27-bottom.brd]
2019-05-19 Add header to bluetooth message to allow sending large messages
    Could have messed with MTU size, but tests showed it to be not dependable
    This makes it such that you must use a pre-defined protocol to talk to the
    badge, since just using a serial client won't use our message format.
    [ble.cpp, ble.h]
2019-05-20 adding FPA SAO
    [fpa-sao.brd, fpa-sao.sch]
2019-05-25 finish up context switching, tested with locked and invalid context selections. Implemented a simple format string vulnerability quest to the Game Master as an example quest. Next we need to start im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
2019-05-26 Sample OTA Code. Binary size is too large :<
    [dc27.cpp]
2019-05-26 Setup custom OTA partitions (1.3mb each), re-enable BLE And GameMaster for development. Leave OTA commented out for size purposes.
    [partitions.csv]
2019-05-27 checking in sao changes
    [fpa-sao.brd, fpa-sao.sch]
2019-05-27 swaping touch_data_in and touch_data_out
    [DC27-bottom.brd, DC27-bottom.sch]
2019-05-29 updated sao
    [fpa-sao.brd, fpa-sao.sch]
2019-05-30 updated sao and docs
    [fpa-sao.brd, fpa-sao.sch, iCE5LP1KPinout.ods]
2019-06-02 Enable line of pwr switch is now what powers vbat on top board, so if you turnoff the badge top the top and the bottom board are off. :) Increased top board caps to 1206 from 0805
    [DC27-bottom.brd, DC27-bottom.sch, DC27-top.brd, DC27-top.sch]
2019-06-03 tied pin 6 to cdone
    [fpa-sao.brd, fpa-sao.sch]
2019-06-04 cleaned up silk screen top board
    [DC27-top.brd, DC27-top.sch]
2019-06-05 updated silk screen so everything should be 'readable' 'squared off the usb area' so that its 1.2mm from the hole to the end of the board per data sheet.
    [DC27-bottom.brd]
2019-06-05 added cmdc0dez puzzle
    [DC27-top.brd]
2019-06-05 Added puzzle elemenets for Krux's Challenge.
    Added puzzle elemenets for Krux's Challenge. Cleaned up size/font/position for part labels
    [DC27-bottom-krux.brd, DC27-bottom-krux.sch, DC27-bottom.sch]
2019-06-06 moved vias
    [DC27-bottom.brd]
2019-06-06 Fixed the darknet logo, and made resistors pretty
    [DC27-bottom.brd, DC27-bottom.sch, DC27-top.brd, DC27-top.sch]
2019-06-06 fixed an airwire, changed diodes to through hole
    [DC27-bottom.brd, DC27-top.brd, DC27-top.sch]
2019-06-06 fixed my image
    [DC27-top.brd]
2019-06-17 final tweaks moved top board I2C to separate bus
    [DC27-bottom.brd, DC27-bottom.sch, DC27-top.brd, fpa-sao.brd, fpa-sao.sch]
2019-06-21 moved usb .15mm closer to edge per first pcb ask
    [DC27-bottom.brd]
2019-06-22 fixed i2c pull ups to be actual pull ups
    [DC27-bottom.brd, DC27-bottom.sch]
2019-06-30 reduce stack size of tasks, implement factory reset and verify OTA works
    [ble.h, dc27.cpp, game_master.h]
2019-06-30 turn OTA task on (doesn't reach out to anything)
    [dc27.cpp]
2019-07-03 almost working, color is just wrong
    [dc27.cpp]
2019-07-06 store game unlocked status and exploitable game level in nvs. fix exploitable level 1.
    [game_master.cpp, game_master.h]
2019-07-10 add some xtensa assembly documentation for reference
2019-07-10 sample assembly
2019-07-11 buttons now work, but somewhere I broke touch screen
    [app.cpp, app.h, buttons.cpp, calibration_menu.cpp, calibration_menu.h, dc27.cpp, gui_list_processor.h, menu_state.cpp]
2019-07-13 fix some exploitable prints
2019-07-14 add 3d tic-tac-toe. almost works, bug in computer movement generation
    [app.cpp, app.h, ble.cpp, ble.h, game_master.cpp, game_master.h]
2019-07-14 everything compiles but won't link
    [KeyStore.cpp, KeyStore.h, app.cpp, app.h, badge_info_menu.cpp, communications_settings.cpp, communications_settings.h, dn8base_menu.h]
2019-07-14 tic-tac-toe works now. clean up some superfluous debug prints
2019-07-14 stub out rest of exploitable quest, add another password guessing quest, add newline to gamemaster printer
2019-07-15 removed address book and sao scan fixed game of life
    [app.cpp, app.h, game_of_life.cpp, game_of_life.h, menu_state.cpp, menu_state.h]
2019-07-15 jam all the games into game_master.cpp
    [app.cpp, game_master.cpp, game_master.h]
2019-07-21 basic calibration stuff complete
2019-07-21 calibration now completely works next up to allow touch to navigate menus
2019-07-22 calibration works Test menu works main menu works with touch screen
2019-07-23 fixed the way components work so they are 'mostly' correct for the current esp32 make system (non-cmake based). but that meant removing <libesp/> from many includes but now we can include more than 1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
    [app.cpp, app.h, badge_info_menu.cpp, ble.h, buttons.cpp, calibration_menu.cpp, calibration_menu.h, dc27.cpp]
2019-07-27 fix pairing menu build
    [app.h, pairing_menu.cpp, pairing_menu.h]
2019-07-30 remove the wifi stuff until i can fix it appropriately
    [app.cpp]
2019-07-30 crytpo chip works initialize serial number gerneates device public/private key pair logs all config
2019-07-30 fix screen for wrover AND devkit
    [app.cpp]
2019-07-30 drop 1 ota partition, update sdkconfig for SPI ram
    [partitions.csv]
2019-07-30 fix wifi stuff, shuffle all these files around
    [app.cpp, npc_interact.cpp, npc_interact.h, wifi.cpp, wifi.h]
2019-07-30 turn on wifi, reduce backbuffer to 50%, turn off SPIRAM support because ESP32-WROOM doesn't have it (ROVER Only). Add #GOURRY_DEVKIT define for pinouts and buttons
    [app.cpp, app.h, buttons.cpp, dc27.cpp, devkit.h]
2019-08-03 i2c working via bus pirate
2019-08-03 bot board can talk to bottom board
2019-08-03 added a few new led dances
2019-08-04 get uart working for pairing menu, move all GPIO pin definitions to a central place
2019-08-04 setting flash to 8 MB
    [partitions.csv]
2019-08-04 fixed bug in horizontal light show
    [main.c]
2019-08-05 fix random number generation
    [ble.cpp, game_master.cpp]
2019-08-05 fix communication settings menu, ble settings are no longer interactive
    [communications_settings.cpp]
2019-08-05 move pairing uart initialization into pairing_menu.cpp
2019-08-05 add a uart flush during menu intialization to clear out any garbage
2019-08-05 fixed badge info screen (mostly) vitual buttons in place for drawing
    [badge_info_menu.cpp, dn8base_menu.cpp, dn8base_menu.h, drawing.cpp]
2019-08-06 drawing mostly works. Fixed bug with display in badge info added timeout for screen saver added touch screen back on test Menu
    [app.cpp, app.h, badge_info_menu.cpp, drawing.cpp, drawing.h, test_menu.cpp, test_menu.h]
2019-08-06 OTA works, menu is wonky, it is successful inconsistently due to what seems like memory or connection issues, greatest chance of success if you actually power-cycle the badge (turn it on and off)
    [partitions.csv]
2019-08-07 fixed a bug with saving contacts the namespace was too long becasue 18 is indeed greater than 15
    [KeyStore.cpp, contact.cpp, contact.h, pairing_menu.cpp]
2019-08-08 fixed a bunch of UI bugs and made the print out of contacs better
    [KeyStore.cpp, KeyStore.h, app.cpp, badge_info_menu.cpp, badge_info_menu.h, contact.cpp, contact.h, menu_state.cpp]
2019-08-08 final top board firmware
    final top board
2019-08-09 Version 1.0
    final fix: ble bug that found an ota bug.
    [communications_settings.cpp, dc27.cpp, setting_state.cpp, wifi.cpp, wifi.h]
