thedarknet/darknet8-badge/(notices)

Notices in the files:
Prototype1/hardware/docs/HARDWARE/SPI/spi.h:
Copyright(C) ÕýµãÔ­×Ó 2009-2019
All rights reserved
